Robusr/OnesArm/README.md

<p align="center">
  OnesArm v2 modular robotic arm on a 4040 aluminium platform
</p>

<h1 align="center">OnesArm</h1>

<p align="center">
  <strong>A modular serial robotic arm for multi-scenario tasks</strong>
  <br>
  v2 stepper/CAN platform, 24 joint layouts, and mortise-and-tenon interfaces
</p>

<p align="center">
  
  
  
  
  
  
</p>

<p align="center">
  <a href="./README.md">English</a> |
  <a href="./README.zh-CN.md">中文</a> |
  <a href="./README.fr.md">Français</a>
</p>

---

## About the project

**OnesArm** (Chinese project title: 珠联“臂”合) is a modular serial robotic arm. **v2 is the current platform.** It combines 42BYGH47 stepper motors with FLE-42-20 planetary reducers, STM32F103C8T6 CAN joint modules, an STM32F407ZGT6 bus controller, a 350 W supply and a 4040 aluminium platform. The links use 5 mm 5052 aluminium sheet and 50 × 46 mm carbon-fibre tubes, joined at standardised M5 nodes.

The arm is assembled from interchangeable joint, link and end-effector modules through **T/N mortise-and-tenon** interfaces. For the three-module configuration, the base-adjacent orientation is fixed and the other two modules choose one of two perpendicular channels, giving

**N₃ = 3! × 2² = 24**

joint layouts. The 24 assemblies are modelled in SolidWorks.

The earlier **v1 reference build**, with 15 kgf·cm PWM servos and a Raspberry Pi Pico W, is retained in the repository for comparison. The project was developed by 郭沫晗 (Guo Mohan) at Guyuan No. 1 Middle School, Ningxia. The report documents a first prize at the 38th National Youth Science and Technology Innovation Competition (2024).

> **Platform note.** v1 and v2 use separate electronics. Select the matching drive and board set before assembly.

## Key features

- **v2 stepper/CAN drive chain** — 42BYGH47 motors, FLE-42-20 1:20 reducers, magnetic encoder closed-loop control and STM32F103C8T6 CAN joint modules.
- **v2 aluminium/carbon structure** — 5 mm 5052 links, 50 × 46 mm carbon tubes, M5 nodes, a 4040 platform and a 350 W supply, with SolidWorks, STEP and STL sources included.
- **24 reconfigurable layouts** — three interchangeable modules, two perpendicular channels, and a fixed base-adjacent orientation.
- **T/N mortise-and-tenon interface** — a T node on top and an N node below, clamped by an M5 screw, inspired by dovetail and half-lap timber joints.
- **v1 reference build** — 15 kgf·cm PWM servos, Raspberry Pi Pico W, five module boards and a 16P gold-finger interconnect.
- **Multi-scenario end effectors** — parallel gripper, HC-SR04 ultrasonic probe, MQ gas sensor and pen module share the same interface.

## System architecture

### v2 current platform

<p align="center">
  OnesArm v2 system architecture
  <br>
  <em><strong>System architecture.</strong> End effector, link module, joint module and 4040 platform, with the CAN bus and 350 W supply.</em>
</p>

| Subsystem | v2 implementation |
|---|---|
| Controller | STM32F407ZGT6 CAN bus controller; STM32F103C8T6 CAN module in each joint |
| Drive | 42BYGH47 stepper + FLE-42-20 planetary reducer, 1:20; magnetic encoder closed-loop |
| Bus and power | CAN via TJA1050; 350 W DC supply; XT60 input; LM2596-5.0 logic rail |
| Structure | 5 mm 5052 aluminium sheet + 50 × 46 mm carbon tubes; M5 nodes; 4040 aluminium platform |
| End effectors | Parallel gripper, HC-SR04 ultrasonic probe, MQ gas sensor, pen module |

<p align="center">
  v2 X-X long link render
  v2 X-Y long link render
  <br>
  <em><strong>Figure 1 — v2 long links.</strong> X-X and X-Y links in 5 mm 5052 aluminium with 50 × 46 mm carbon tubes and M5 connection nodes.</em>
</p>

<p align="center">
  v2 stepper and reducer module
  v2 arm on a 4040 platform
  <br>
  <em><strong>Figure 2 — v2 drive module and platform.</strong> 42BYGH47 stepper, FLE-42-20 reducer, CAN board and the 4040 aluminium working platform.</em>
</p>

### v1 reference build

| Subsystem | v1 implementation |
|---|---|
| Controller | Raspberry Pi Pico W, RP2040, Wi-Fi |
| Drive | 15 kgf·cm PWM digital servo |
| Bus | 16P 2.54 mm gold-finger interconnect |
| Boards | Base, Joint A, Joint B, Holder/Sensor, Expand Controller |
| Supply | 5–9 V servo rail; 5 V logic |

<p align="center">
  v1 reference build render
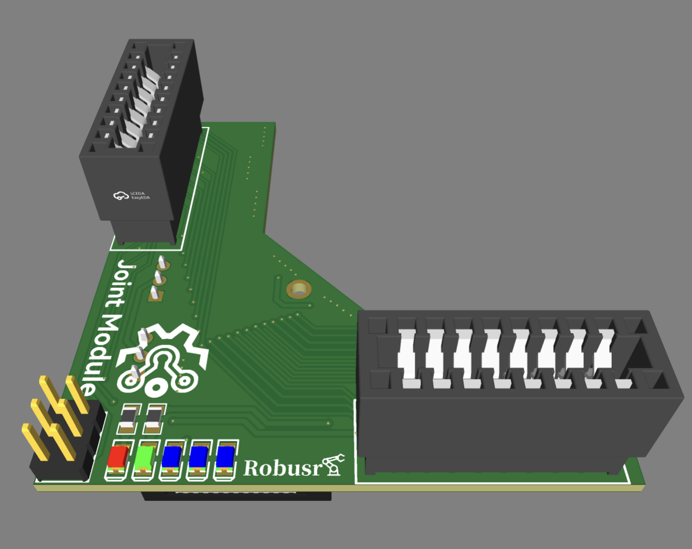
[picture p1: media/photos/reference/key_figures/fig2-19_pcb_joint_module.png]
v1 joint module PCB
  
  <br>
  <em><strong>Figure 3 — v1 reference build.</strong> Servo-driven arm render and the Joint Module PCB with PWM outputs, status LEDs and a servo signal selector.</em>
</p>

## Theory and design

### Modular combinations

The modular interface is a **connecting face – connecting channel – connecting face** (FCF) chain. An X-X or X-Y long link has 6 faces × 4 channels, a short link has 4 × 4, and a joint has 2 × 4. The per-module connection counts are:

- Base: 3 methods.
- X-X / X-Y long link: 2 × 3 × 3 = 18 methods.
- Short link: 2 × 2 × 3 = 12 methods.
- Joint: Pro side 4 × 1 × 1 = 4, Con side 1 × 4 × 1 = 4, total 8 per joint module.
- General end link: 2 × 2 or 2 × 3 methods.

For <i>F</i> joint modules, <i>N</i><sub>LL</sub> long links and <i>N</i><sub>LS</sub> short links, the FCF connection-method total is:

$$\displaystyle N_{com} = \sum_{i=0}^{N_{LL}} \sum_{j=0}^{N_{LS}} 8^{F} \cdot 18^{N_{LL}} \cdot 12^{N_{LS}}$$

The three-module assembly fixes the base-adjacent orientation and gives the remaining two modules two perpendicular channels each:

$$N_3 = 3! \cdot 2^{3-1} = 24$$

The 24 combinations are modelled as SolidWorks assemblies.

<p align="center">
  Connecting face - connecting channel - connecting face
  Concatenated modular chain
  <br>
  <em><strong>Figure 4 — FCF abstraction.</strong> Every connection is a face, a channel and another face. Long links have six faces, short links four, and joints two.</em>
</p>

### Kinematics and workspace

The analysed configuration is **AyCxBy-D**, a 4-DOF chain. Report Table 3-20 gives:

| i | dᵢ (mm) | aᵢ (mm) | αᵢ | Report range |
|---:|---:|---:|---:|---|
| 1 | 95 | 0 | 90° | 0° |
| 2 | 0 | 113.5 | 90° | 0–180° |
| 3 | 21.34 | 88.5 | 90° | 0–180° |
| 4 | 0 | 152 | 0° | 0–180° |

The standard DH transform is:

$$T_i^{i-1} = \begin{bmatrix}
c\theta_i & -s\theta_i c\alpha_i & s\theta_i s\alpha_i & a_i c\theta_i \\
s\theta_i & c\theta_i c\alpha_i & -c\theta_i s\alpha_i & a_i s\theta_i \\
0 & s\alpha_i & c\alpha_i & d_i \\
0 & 0 & 0 & 1
\end{bmatrix}, \qquad T_4^0 = T_1^0 T_2^1 T_3^2 T_4^3$$

The workspace is the set of tool positions over the joint ranges:

$$\mathcal{W} = \{\, \mathbf{p}(q) \mid q_i \in [q_{i,\min}, q_{i,\max}] \,\}, \qquad \mathbf{p}(q) = [T_4^0(q)]_{1:3,4}$$

The link-length sum is 113.5 + 88.5 + 152 = 354 mm. With the model offsets, the sampled workspace reaches about 450 mm.

<p align="center">
  Workspace comparison for four assembly layouts
  <br>
  <em><strong>Figure 5 — Workspace comparison.</strong> Four of the 24 layouts: AyCxBy-D, AyCyBx-D, AyCxBx-D and AyCyBy-D. Simulation samples from the kinematic model.</em>
</p>

### v2 finite element analysis

The v2 XY long link is evaluated as a static assembly. The base connection is fixed and the service load is applied at the connection nodes. The model combines the 5 mm 5052 aluminium plates with the 50 × 46 mm carbon tube.

The finite element solution is:

$$K u = f$$

where K is the stiffness matrix, u the nodal displacement vector and f the nodal load vector. The same load path can be checked with the cantilever relations:

$$M = FL, \qquad \sigma = \frac{Mc}{I}, \qquad \delta = \frac{FL^3}{3EI}$$

The v2 study reports a displacement-magnitude (URES) contour with a maximum of:

$$u_{\max} = 1.388 \times 10^{-2}\ \text{mm}$$

<p align="center">
  v2 XY long link static displacement contour
  <br>
  <em><strong>Figure 6 — v2 finite element analysis.</strong> Static displacement contour of the XY long link. The base is fixed and the connection nodes carry the service load; the URES legend is in millimetres.</em>
</p>

### Assembly selection

The v2 board uses the absolute joint-velocity integral as the assembly-selection index:

$$E_{Sum} = \sum_{i=1}^{F} \lvert \int_0^t \dot{\theta}_i(\tau)\,d\tau \rvert$$

The selection compares E_Sum with the workspace envelope. The workflow is:

<p align="center">
  Assembly selection workflow
  <br>
  <em><strong>Figure 7 — v2 assembly-selection workflow.</strong> The effort index and the workspace pre-processing path.</em>
</p>

### v1 reference static analysis

The v1 static study uses 9400A photopolymer resin and a 10 N load on each joint top face. The joint housings and the full assembly are evaluated in SolidWorks Simulation.

<p align="center">
  Finite element mesh of the joint housing
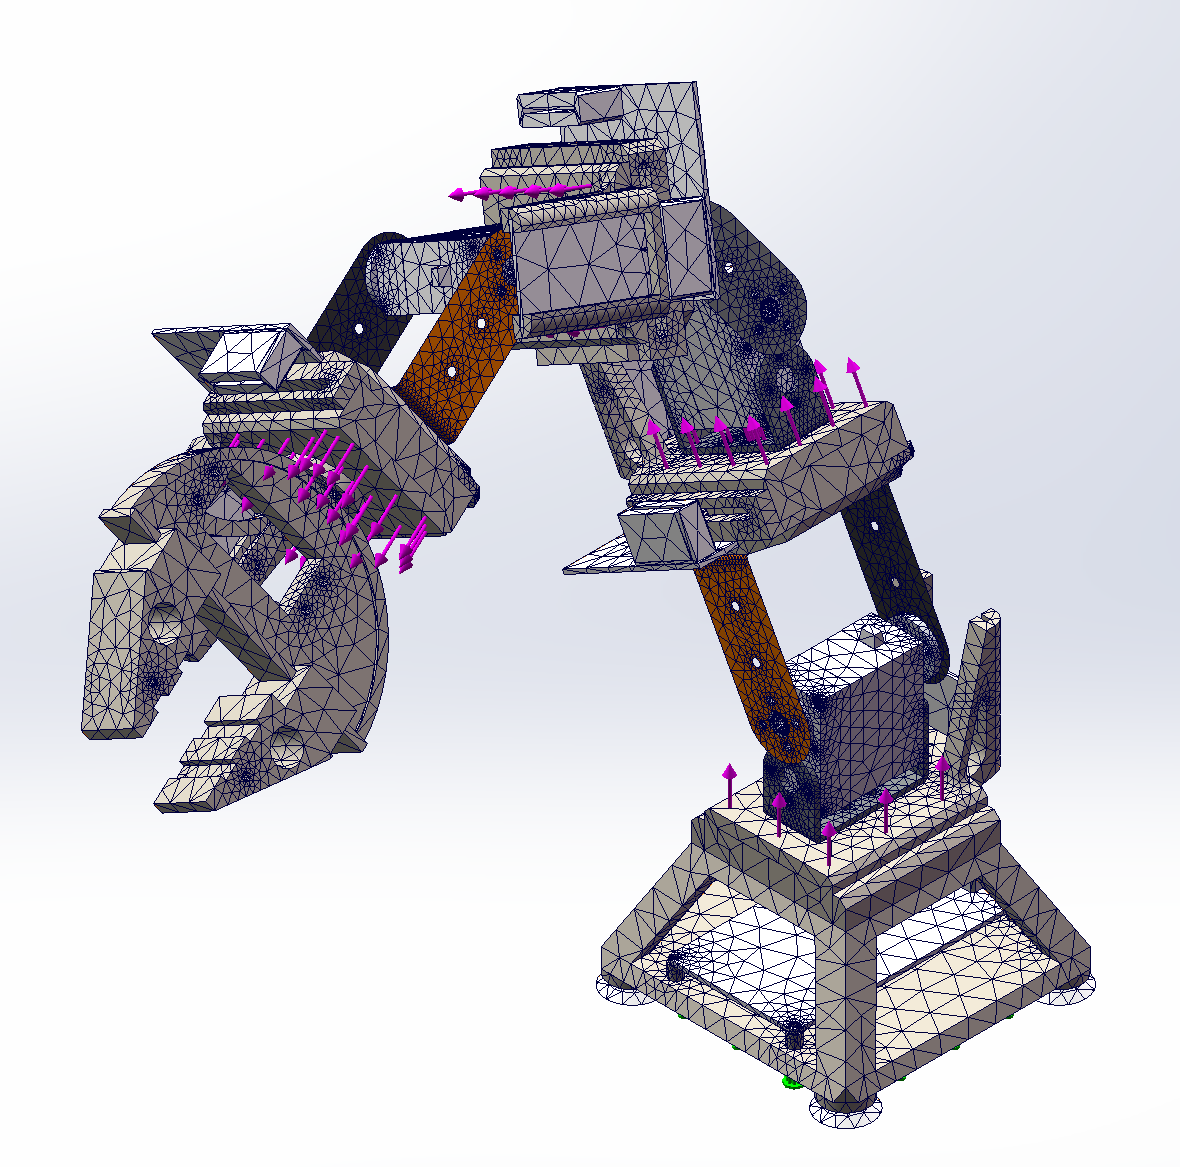
[picture p2: media/photos/reference/key_figures/fig3-5_fea_stress.png]
Static stress result for the joint housing
  
  <br>
  <em><strong>Figure 8 — v1 reference static analysis.</strong> Mesh and stress result for the joint housing under the 10 N load case.</em>
</p>

## Repository structure

```text
OnesArm/
├── BOM/                    summary + manufacturing checklists
├── electronics/            Gerber, BOM and silkscreen outputs
├── mechanical/
│   ├── source/             SolidWorks parts and assemblies
│   ├── output/             STEP, STL and fabrication exports
│   └── analysis/fea/       exported FEA images
├── firmware/               STM32CubeIDE projects + MicroPython libraries
├── software/               MATLAB kinematics scripts
├── docs/
│   ├── en/ zh-CN/ fr/      long-form documentation
│   ├── report/             2025 report and defence deck
│   ├── archive/            2024 report and research log
│   └── references/         citations and provenance
├── media/
│   ├── photos/project/     v2 renders, v1 build photos, PCB and test views
│   ├── photos/reference/   report figures and key figures
│   ├── gifs/               reference-build demonstrations
│   ├── videos/             original MP4 files
│   └── source/             editable poster files
├── data/                   data and log directory
├── scripts/verify_theory/  pure-Python kinematics and dimensional checks
├── README.md README.zh-CN.md README.fr.md
├── MIGRATION_NOTES.md CHANGELOG.md CONTRIBUTING.md
├── LICENSE.md LICENSE-docs.md
├── .gitignore .gitattributes
└── .github/
```

## Bill of materials

A summary is in [`BOM/onesarm_bom.md`](BOM/onesarm_bom.md); the machine-readable version is [`BOM/onesarm_bom.csv`](BOM/onesarm_bom.csv). Original checklists are under [`BOM/manufacturing/`](BOM/manufacturing/).

### v2 current platform

| Group | v2 items | Quantity |
|---|---|---|
| Long links | X-X and X-Y, 5 mm 5052 aluminium + carbon tube | 4 + 4 |
| Short links | 5 mm 5052 aluminium | 4 |
| Joints | 45° × 1, 90° × 2 | 3 |
| Drive | 42BYGH47 + FLE-42-20, 1:20 | 3 sets |
| Control | STM32F103C8T6 CAN modules + STM32F407ZGT6 controller | 1 set |
| Power | 350 W DC supply, XT60 | 1 |
| Platform | 4040 aluminium profile, three test plates | 1 |
| End effectors | Gripper, ultrasonic, gas sensor, pen | 4 modules |

### v1 reference build

| Group | v1 items | Quantity |
|---|---|---|
| Drive | 15 kgf·cm PWM servo | 3 |
| Controller | Raspberry Pi Pico W | 1 |
| Module boards | Base, Joint A/B, Holder/Sensor, Expand Controller | 5 |
| Interconnect | 16P 2.54 mm gold-finger | As required |
| Printed joints | 9400A resin joint housings | 3 + 3 |

## Getting started

### v2 build

1. **Fabricate the structure.** Use the STEP/STL files in `mechanical/output/`; cut and bend the 5 mm 5052 links, bond the 50 × 46 mm carbon tubes, and print the 9400A joint housings.
2. **Fabricate the electronics.** Order the Gerber archives in `electronics/output/gerber/controller_monitor/` and populate the BOM from `electronics/output/bom/controller_monitor/`.
3. **Assemble the platform.** Build the 4040 frame, fit the 350 W supply, and mount the Controller and Monitor boards.
4. **Configure the control.** Open the STM32CubeIDE projects in `firmware/stm32/` and configure the CAN bus and joint modules for the selected layout.
5. **Run the analysis.** Use the MATLAB scripts in `software/matlab/kinematics/` and the independent Python checks in `scripts/verify_theory/`.

```bash
python scripts/verify_theory/report_checks.py
python -m unittest discover -s scripts/verify_theory -v
```

### v1 reference build

1. Print the v1 joint housings and assemble the five v1 module boards.
2. Order the v1 Gerber archives in `electronics/output/gerber/v1_module_boards/` and build the 16P gold-finger harness.
3. Flash the Pico W with the MicroPython libraries in `firmware/micropython/` and connect the servo rail.

## Demo and testing

The v2 CAD and platform views show the current structure and drive package.

<p align="center">
  v2 arm on the 4040 working platform
  <br>
  <em><strong>Figure 9 — v2 working platform.</strong> Stepper-driven arm, aluminium/carbon links and the 4040 frame.</em>
</p>

The v1 reference build demonstrations show the servo/Pico reference build in motion, the expand-controller OLED/GNSS display, the gripper/pen module and the simulation view.

<p align="center">
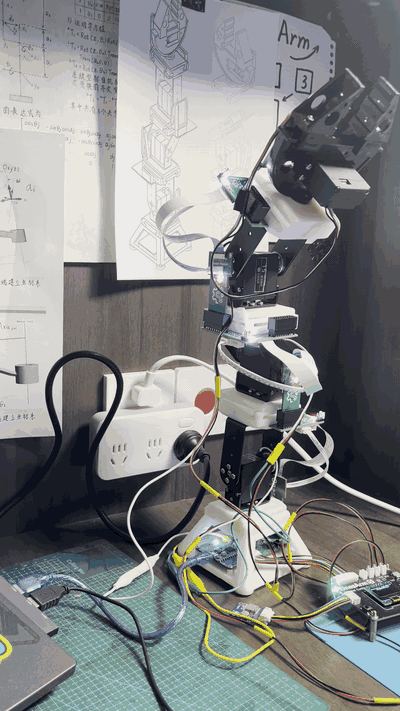
[picture p3: media/gifs/onesarm_motion.gif]
v1 reference build arm motion
  
  v1 reference build gripper demo
</p>

<p align="center">
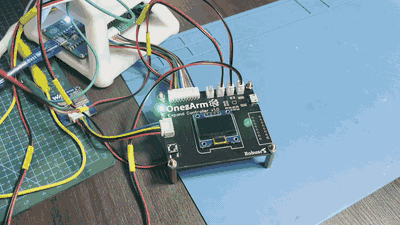
[picture p4: media/gifs/onesarm_electronics.gif]
v1 reference build OLED and GNSS demo
  
  Kinematic simulation view
</p>

<p align="center">
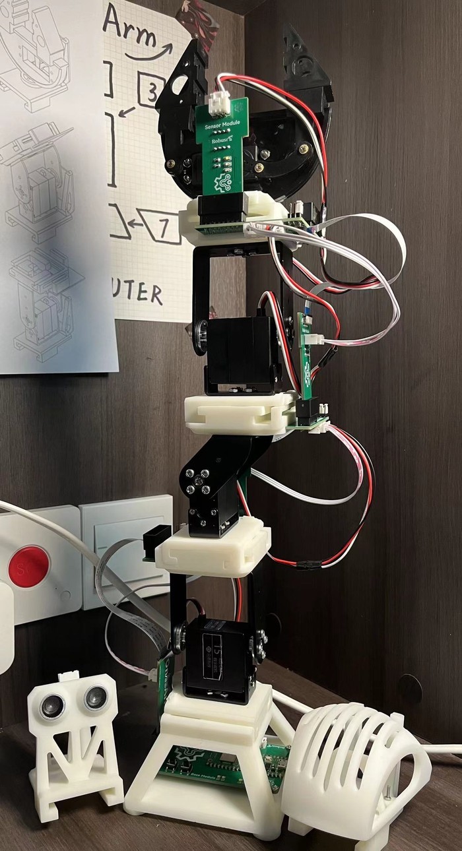
[picture p5: media/photos/project/onesarm_v1_build.jpg]
v1 reference build
  
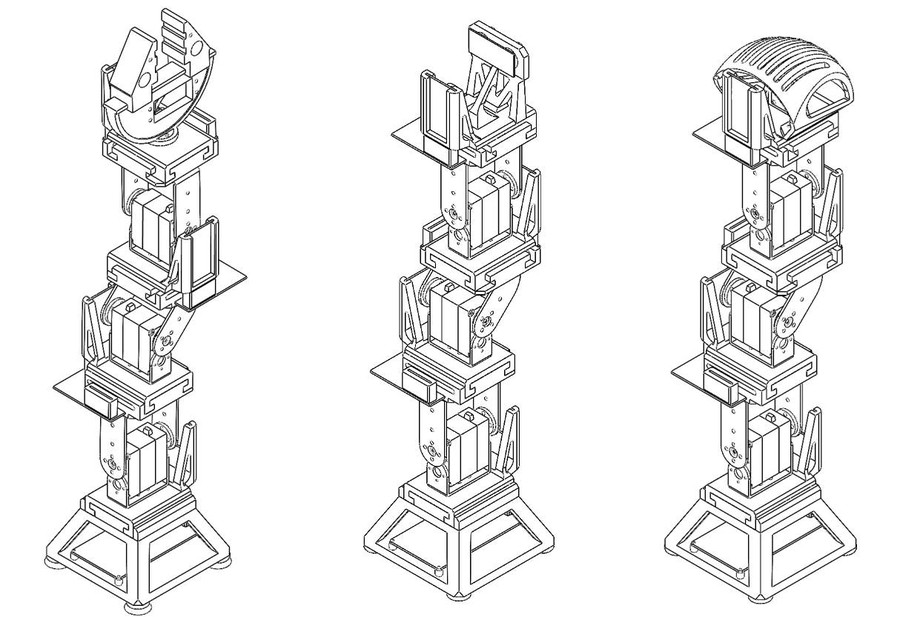
[picture p6: media/photos/project/scene_module_assembly_small.jpg]
Module assembly view
  
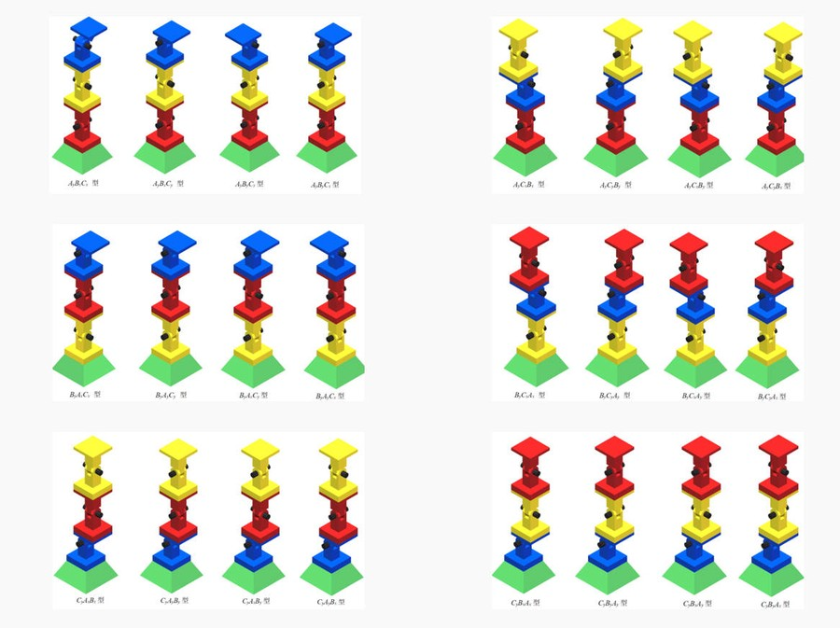
[picture p7: media/photos/project/modular_assembly_diagram_small.jpg]
24 assembly combinations
  
  <br>
  <em><strong>Figure 10 — v1 reference build and assembly views.</strong> The servo/Pico build, a module stack and the 24 permutation/orientation combinations.</em>
</p>

## Design specifications

### v2 current platform

| Parameter | Value | Source |
|---|---|---|
| Analysed configuration | AyCxBy-D, 4 DOF | Report §3.3 |
| Link parameters d₁, a₂, d₃, a₃, a₄ | 95, 113.5, 21.34, 88.5, 152 mm | Report Table 3-20 |
| Link-length sum | 354 mm | Computed |
| Maximum model reach | about 450 mm | Computed, 10,000 samples |
| Assemblies | 24 combinations | 3! × 2²; 24 CAD files |
| Drive | 42BYGH47 + FLE-42-20, 1:20 | Report §5.2.2 |
| Controller | STM32F103C8T6 CAN + STM32F407ZGT6 | Report §5.2.2 / §5.2.3 |
| Platform | 4040 aluminium profile, 350 W supply | Report §5.2.3 |
| Structure | 5 mm 5052 aluminium sheet + 50 × 46 mm carbon tube | Report §5.2.1 |
| FEA material | 9400A resin, E = 2.75 GPa, ν = 0.44, 1150 kg/m³ | Report Table 3-1 |
| FEA load | 10 N at each joint top face | Report §3.1.2 |

### v1 reference build

| Parameter | Value | Source |
|---|---|---|
| Drive | 15 kgf·cm PWM servo, 5–9 V, 180° | Report §2.3.1 |
| Controller | Raspberry Pi Pico W, RP2040 | Report §2.3.2 |
| Module boards | Base, Joint A/B, Holder/Sensor, Expand Controller | Report §2.3.2 |
| Interconnect | 16P 2.54 mm gold-finger | Report §2.3.2 |
| Logic supply | 5 V | Report §2.3.2 |

## Documentation

- [Theory of operation](docs/en/theory_of_operation.md)
- [Mechanical design](docs/en/mechanical_design.md)
- [Electronics and control](docs/en/electronics_and_control.md)
- [Assembly and replication](docs/en/assembly_and_replication.md)
- [Verification](docs/verification.md)
- [Glossary](docs/glossary.md)

Chinese and French versions are in [`docs/zh-CN/`](docs/zh-CN/) and [`docs/fr/`](docs/fr/).

## Contributing

See [`CONTRIBUTING.md`](CONTRIBUTING.md). Add sources and licence notes for third-party figures.

## License

- **Code, firmware and scripts:** [MIT](LICENSE.md).
- **Documentation, original CAD, photos and diagrams:** [CC BY 4.0](LICENSE-docs.md).
- **Third-party figures, papers, videos and trademarks:** excluded from both licences. See [`docs/references/README.md`](docs/references/README.md).

## Acknowledgments

- **Author:** 郭沫晗 (Guo Mohan), Guyuan No. 1 Middle School, Ningxia.
- **Teacher and mentors:** 马博伟 (school robotics studio), 杨旭 (University of Electronic Science and Technology of China), 邵金龙 (Ningxia University), as acknowledged in the report.
- **Competition:** 38th National Youth Science and Technology Innovation Competition (2024).
- **References:** the continuum-robot, modular-arm, mortise-and-tenon and snake-robot literature listed in [`docs/references/README.md`](docs/references/README.md).
- **Tools:** SolidWorks, MATLAB Robotics Toolbox, EasyEDA/LCEDA, STM32CubeIDE, MicroPython, ffmpeg and Pillow.
