Robusr/OnesArm/docs/README.md

# Documentation

## Languages

- [English](en/index.md)
- [中文](zh-CN/index.md)
- [Français](fr/index.md)

## Review documents

- [Errata and theory review](errata.md) — DH convention, Eq. (3.7), joint limits, combination count, “energy” proxy, load case, hardware revisions.
- [Verification](verification.md) — commands, test results, workspace envelope and actuator margin.
- [Glossary](glossary.md) — English / 中文 / Français terminology.
- [References](references/README.md) — report citations, third-party material and tool provenance.

## Source documents

- [Canonical 2025 report](report/README.md)
- [Archived 2024 material](archive/README.md)

The three README files at the repository root are the entry points. Long-form documents are duplicated in `en/`, `zh-CN/` and `fr/` with the same section structure, figures and numbers.
