Robusr/OnesArm/docs/report/README.md

# Reports

| File | Pages / type | Role |
|---|---|---|
| `onesarm_report_2025_zh.pdf` | 65 pages | Canonical Chinese report (2025-09). Includes Chapter 5, the v2 stepper/CAN update. |
| `onesarm_report_2025_zh.docx` | 65 pages | Editable Chinese source for the PDF. |
| `onesarm_report_2025_en.pdf` | 66 pages | English translation (2025-01). |
| `onesarm_defense_2024.pptx` | 51 slides | 2024 defence deck; describes the v1 servo/Pico prototype. |
| `novelty_search_report_2024.pdf` | 9 pages | Novelty search completed 2024-01-20; concludes that no identical report was found. |

## Which version to cite

Use the **2025 Chinese report** for the latest design. Its Chapter 5 supersedes the v1 hardware description in Chapters 1–4. The 2024 report and deck are retained under `../archive/` for traceability.

## Evidence status

The reports contain design descriptions, FEA screenshots, MATLAB plots and qualitative conclusions. They do **not** contain measured payload, repeatability, mass or power data. See `../errata.md` and `../../data/README.md`.

## Copyright

The reports are the author’s work. Third-party figures inside them are not covered by the repository licences; see `../references/README.md`.
