Robusr/OnesArm/docs/archive/README.md

# Archive

This folder keeps superseded material in its original form. It is **not** the current design.

| Path | Content |
|---|---|
| `report_2024/` | 2024 Chinese report (DOCX/PDF) and the 2024 poster PDF. Uses the v1 servo/Pico hardware. |
| `presentations/` | Midterm review deck (2024). |
| `research_log_2023_2024.docx` | Research log from 2023-10 to 2024. |
| `abstract_2024.docx`, `project_intro_2024.docx` | 2024 abstract and project introduction. |
| `xmind/` | Original XMind outlines (project plan and spatial structure). |
| `board_text_2024.md` | Markdown source of the 2024 poster board, including absolute image paths from the author’s machine. |
| `related_concepts/electromagnetic_continuum_arm/` | A separate early concept: an electromagnetically driven continuum arm. It is not part of OnesArm. |

The 2024 report and the 2025 report differ in hardware and wording. Do not mix their specifications. See `../errata.md` E-10.
