Robusr/OnesArm/docs/archive/abstract_2024.docx

# Design and analysis of multi-scenario modular tandem manipulator structure

## Abstract

With the continuous improvement of industrial automation and the demand in the field of medical rescue, the demand for high-precision, high-speed, and high-reliability robotic arm systems is increasing. The modular robotic arm is characterized by high flexibility, easy maintenance and strong scalability. Inspired by the continuous manipulator based on the continuous joint flexible structure, drawing on its advantages of large working space and high flexible adaptability, and avoiding the shortcomings of complex structure and not easy to maintain, aiming at the problems of large volume, single use scenario and poor passing ability of the traditional rigid tandem manipulator, a multi-scene modular tandem manipulator was designed, a three-dimensional solid model was established and 3D printed, and the modular structure design was completed according to the mortise and tenon joints. Static stress finite element analysis and preliminary function verification, based on the coordinate transformation method, the kinematic model of the manipulator was constructed, the forward and reverse kinematics was solved by MATLAB, the simulation analysis and modular combination analysis of the single and multi-joints of the manipulator were carried out, and the multi-scene switching and modular servo control system were built, which realized the purpose of high flexibility, versatility, easy maintenance and expansion, and space optimization of the multi-scene modular tandem manipulator.
