Robusr/OnesArm/docs/archive/project_intro_2024.docx

随着工业自动化程度和医疗救援领域需求的不断提高，对于高精度、高速度、高可靠性的机械臂需求日益增加。受启发于柔性结构的连续型机械臂，借鉴其具有较大工作空间和较高适应性的优点，并规避结构复杂和不易于维护的缺点，针对传统刚性串联机械臂体积大、使用场景单一和复杂狭窄环境通过能力差的问题，设计了多场景模块化串联机械臂。建立三维实体模型，依据榫卯节点连接方式完成模块化结构设计、静应力有限元分析和初步功能验证；基于坐标变换法构建了机械臂的运动学模型，使用MATLAB完成正逆运动学求解，对机械臂单关节、多关节运动进行仿真分析、模块化组合分析和冗余自由度优化，从系统能耗和工作空间两个方面对机械臂结构组装预处理，通过模块化重组的方式完成由“固定需求映射固定机构”到“不同需求映射不同机构”的实时优化；实现多场景模块化串联机械臂通用性高、易于维护和拓展、便于空间优化的目的，满足技术发展和不断变化的需求，达到了珠联“臂”合。
