Robusr/OnesArm/electronics/output/silkscreen/Holder Module.png

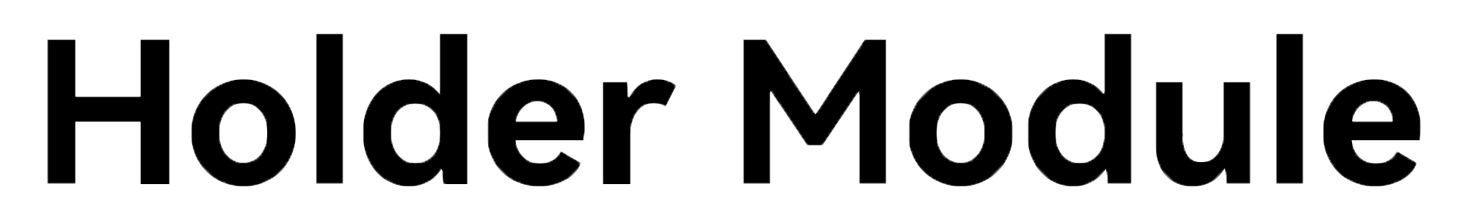
electronics/output/silkscreen/Holder Module.png
