Robusr/OnesArm/electronics/output/silkscreen/Joint Module.png

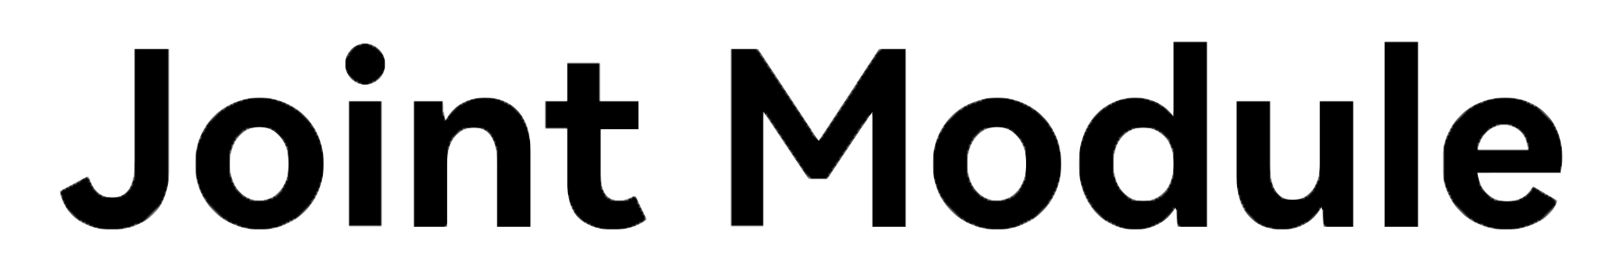
electronics/output/silkscreen/Joint Module.png
