Robusr/OnesArm/media/photos/project/design_views/夹具模块.jpg

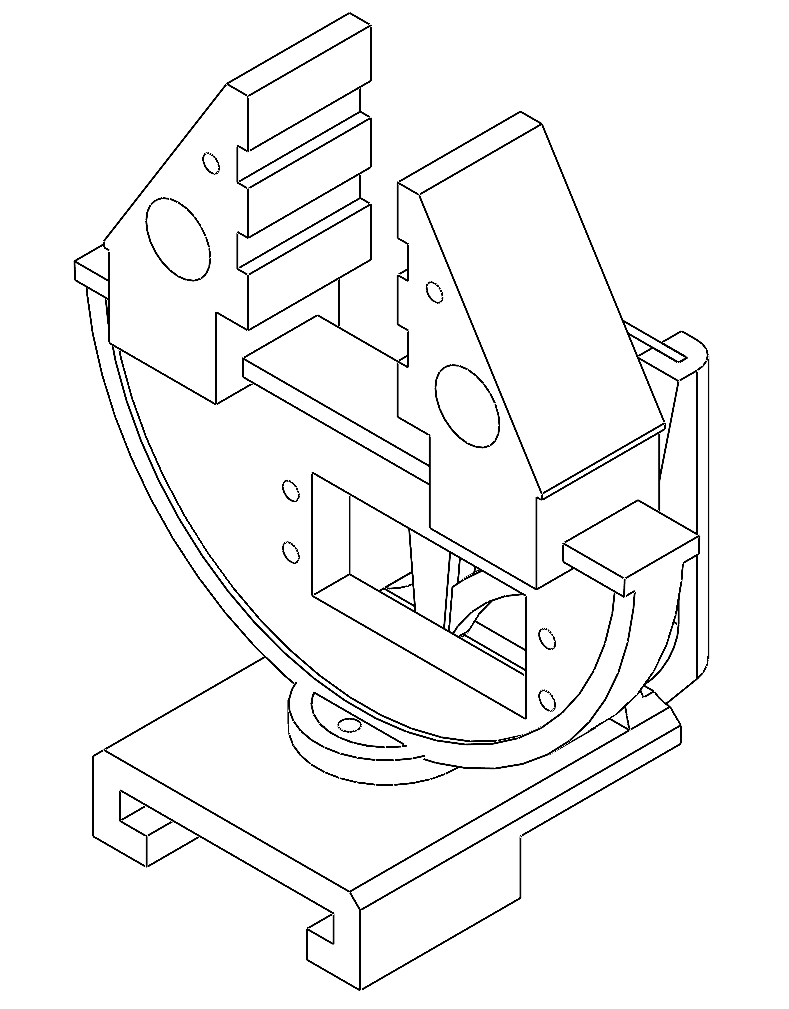
media/photos/project/design_views/夹具模块.jpg
