Robusr/OnesArm/media/photos/project/design_views/整体直.jpg

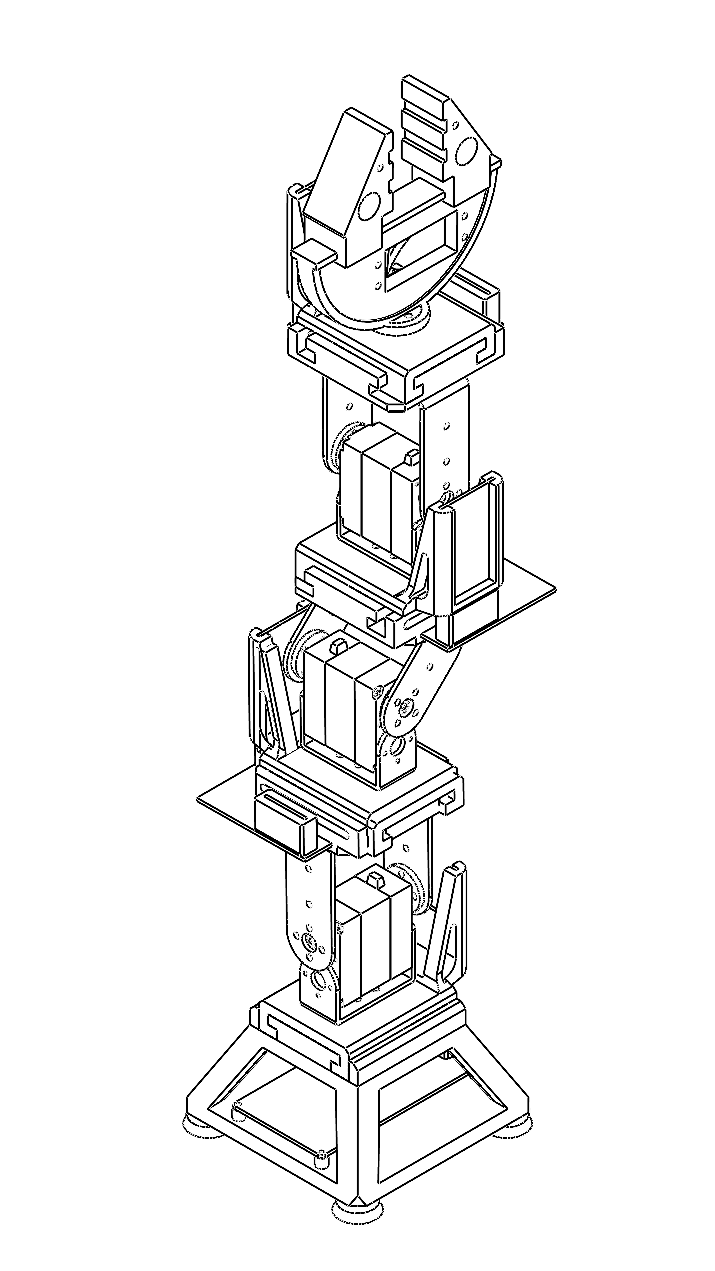
media/photos/project/design_views/整体直.jpg
