Robusr/OnesArm/media/photos/project/misc/微信图片_20240814153913.jpg

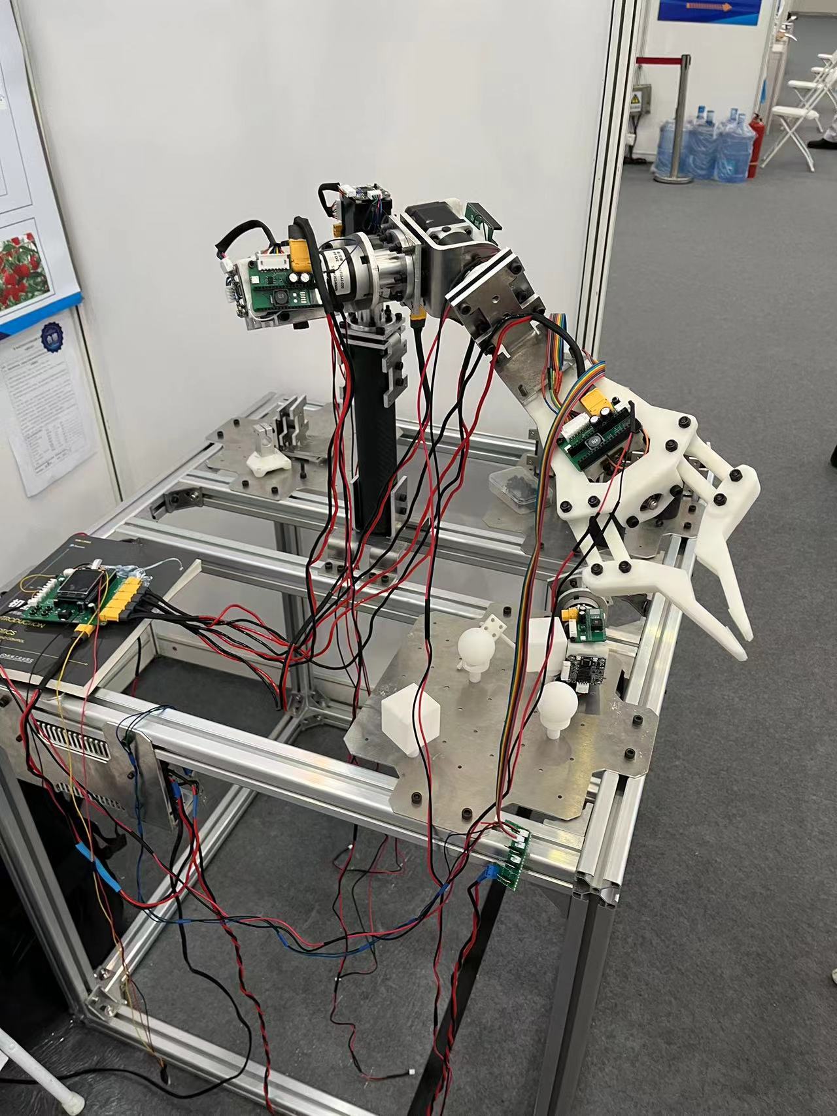
media/photos/project/misc/微信图片_20240814153913.jpg
