Robusr/OnesArm/media/photos/project/misc/微信图片_20240814153923.jpg

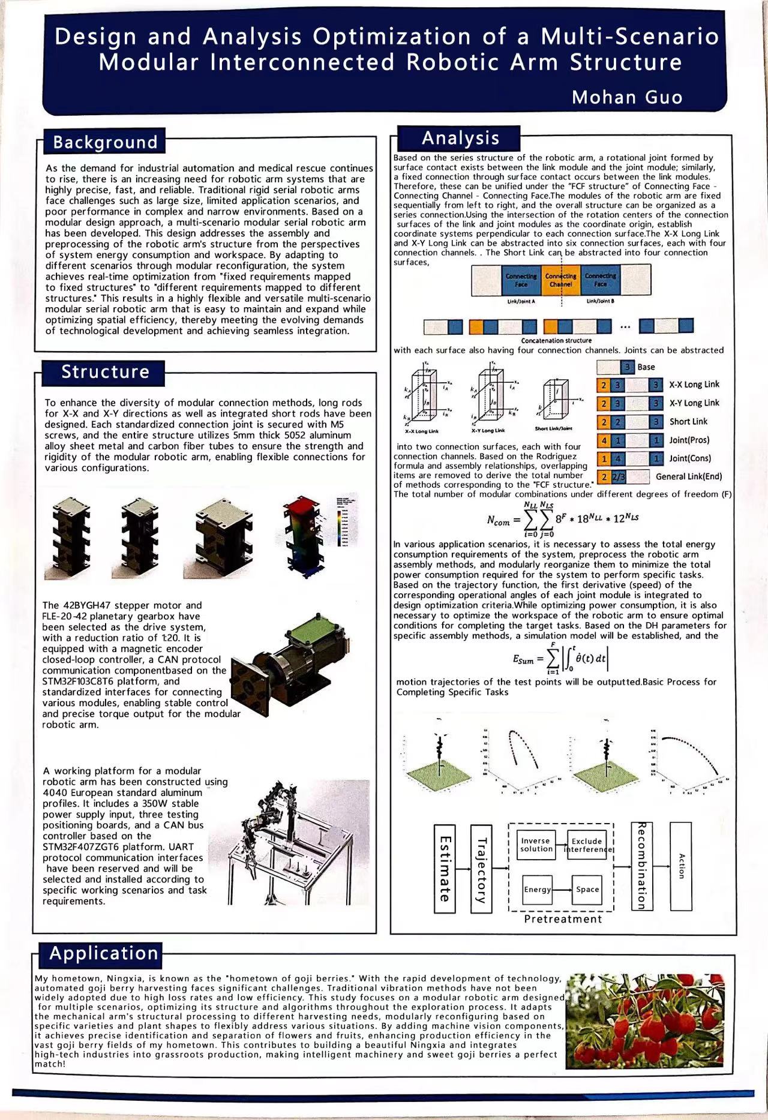
media/photos/project/misc/微信图片_20240814153923.jpg
