Robusr/OnesArm/media/photos/project/onesarm_electronics_poster.jpg

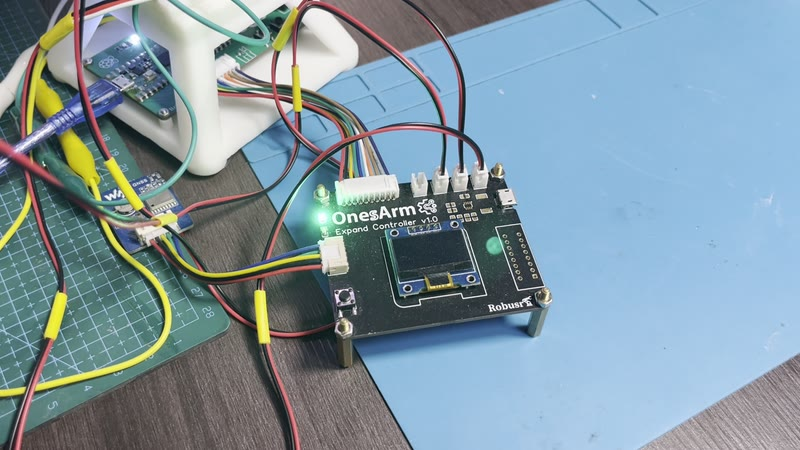
media/photos/project/onesarm_electronics_poster.jpg
