Robusr/OnesArm/media/photos/reference/board/功耗指标.png

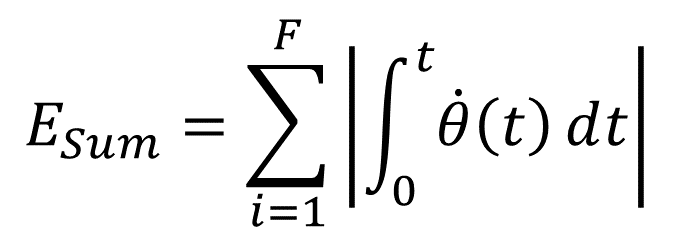
media/photos/reference/board/功耗指标.png
