Robusr/OnesArm/media/photos/reference/board/组合总数.png

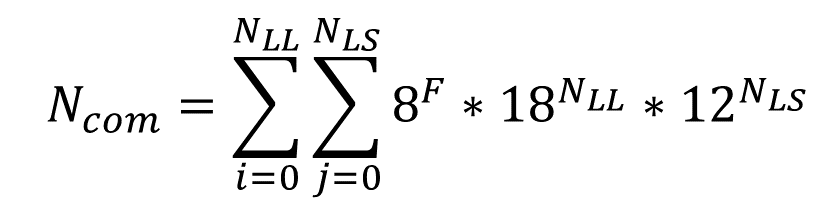
media/photos/reference/board/组合总数.png
