Robusr/OnesArm/media/photos/reference/defense_slides/1.jpg

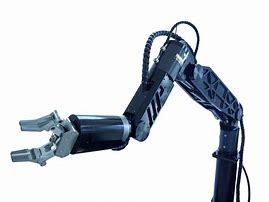
media/photos/reference/defense_slides/1.jpg
