Robusr/OnesArm/media/photos/reference/defense_slides/3.png

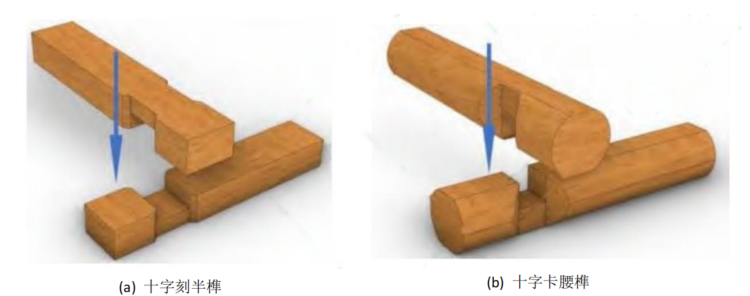
media/photos/reference/defense_slides/3.png
