Robusr/OnesArm/media/photos/reference/defense_slides/5.png

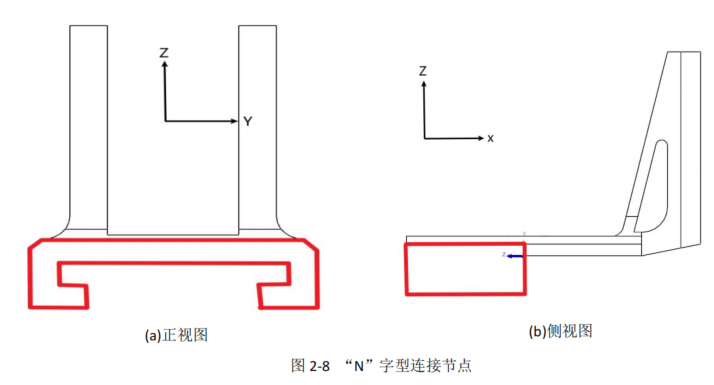
media/photos/reference/defense_slides/5.png
