Robusr/OnesArm/media/photos/reference/defense_slides/8.png

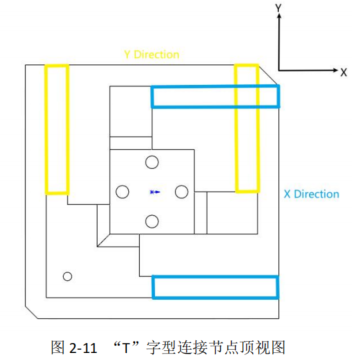
media/photos/reference/defense_slides/8.png
