Robusr/OnesArm/media/photos/reference/defense_slides/10.png

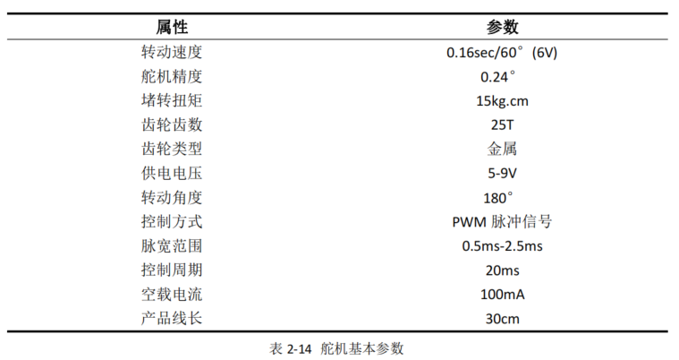
media/photos/reference/defense_slides/10.png
