Robusr/OnesArm/media/photos/reference/defense_slides/11.png

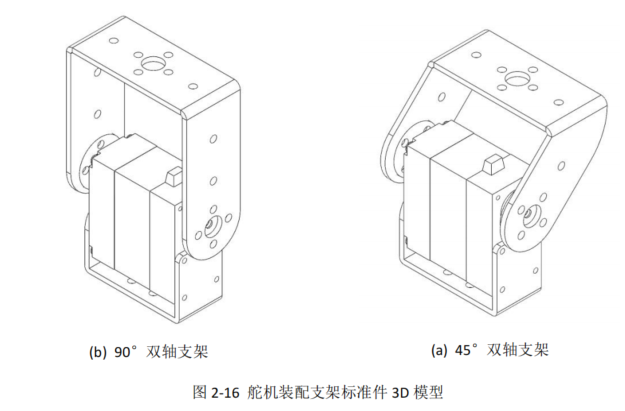
media/photos/reference/defense_slides/11.png
