Robusr/OnesArm/media/photos/reference/defense_slides/13.png

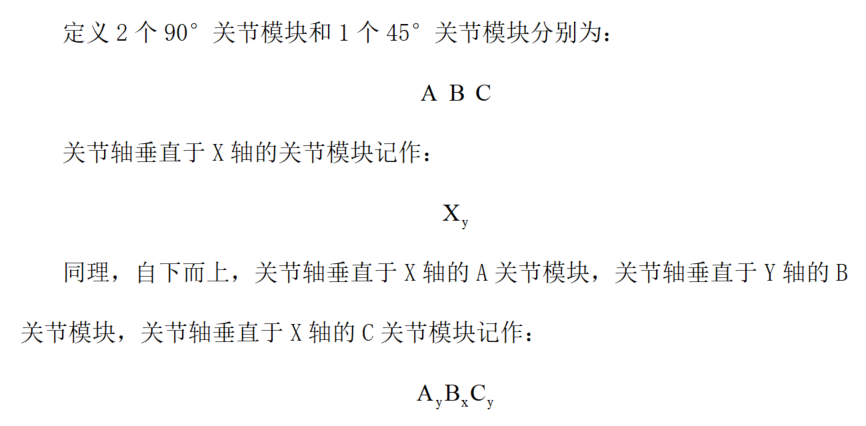
media/photos/reference/defense_slides/13.png
