Robusr/OnesArm/media/photos/reference/defense_slides/15.png

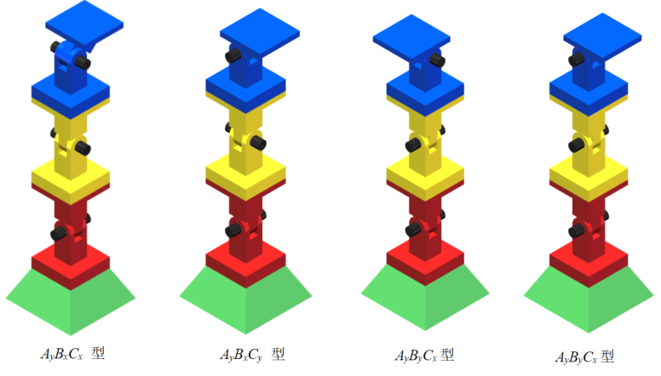
media/photos/reference/defense_slides/15.png
