Robusr/OnesArm/media/photos/reference/defense_slides/16.png

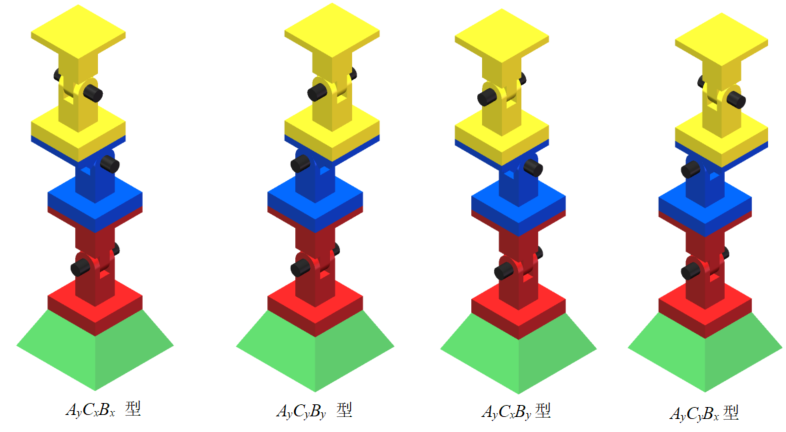
media/photos/reference/defense_slides/16.png
