Robusr/OnesArm/media/photos/reference/defense_slides/17.png

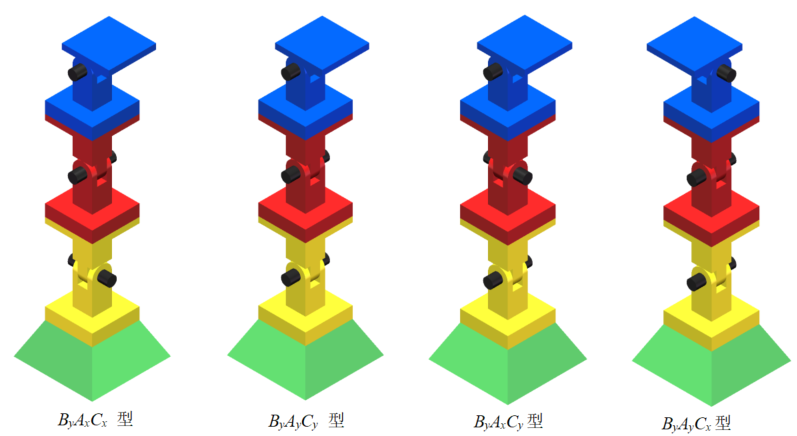
media/photos/reference/defense_slides/17.png
