Robusr/OnesArm/media/photos/reference/defense_slides/18.png

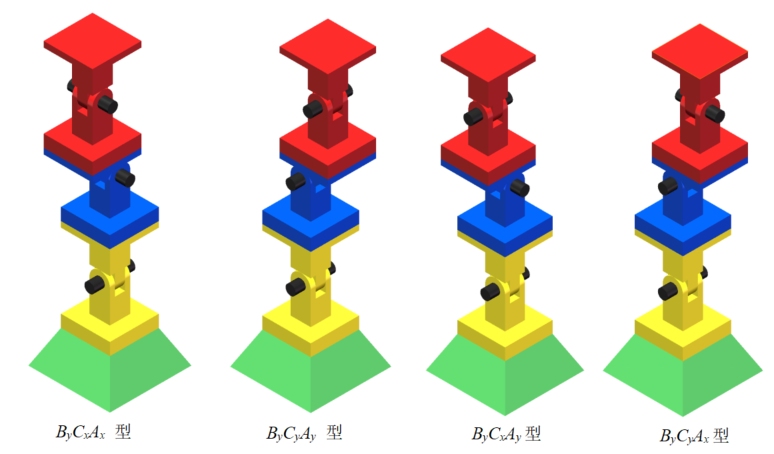
media/photos/reference/defense_slides/18.png
