Robusr/OnesArm/media/photos/reference/defense_slides/20.png

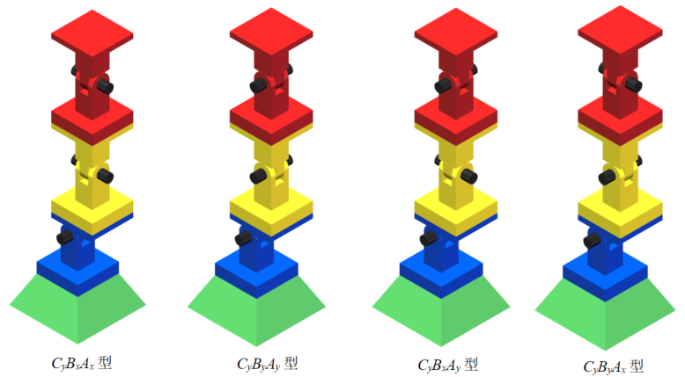
media/photos/reference/defense_slides/20.png
