Robusr/OnesArm/media/photos/reference/defense_slides/21.png

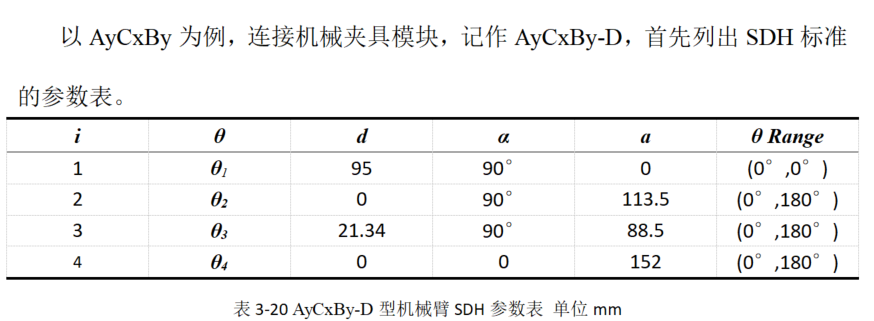
media/photos/reference/defense_slides/21.png
