Robusr/OnesArm/media/photos/reference/defense_slides/22.png

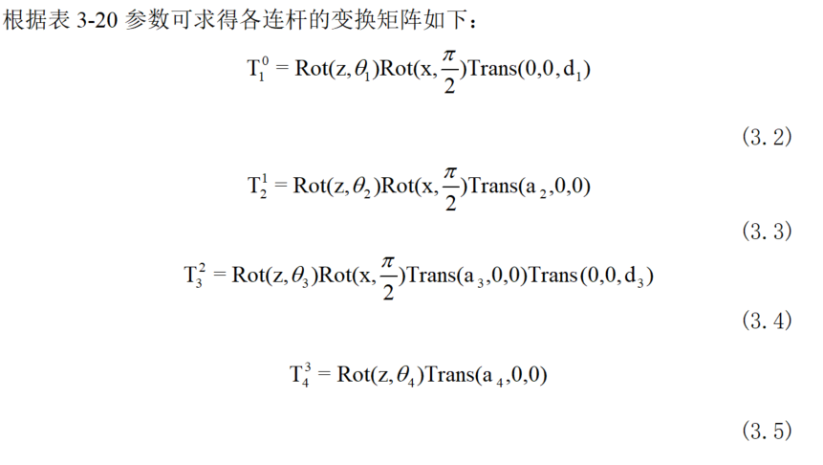
media/photos/reference/defense_slides/22.png
