Robusr/OnesArm/media/photos/reference/defense_slides/23.png

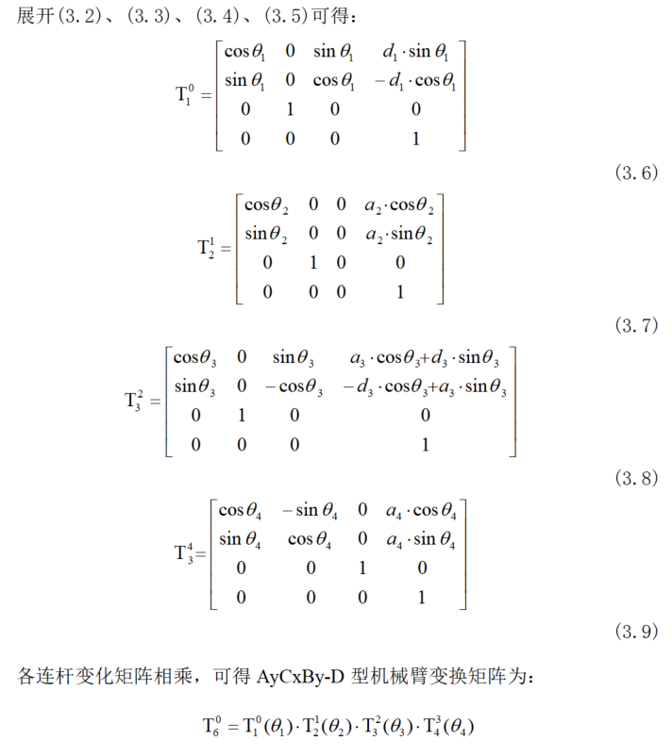
media/photos/reference/defense_slides/23.png
