Robusr/OnesArm/media/photos/reference/defense_slides/24.png

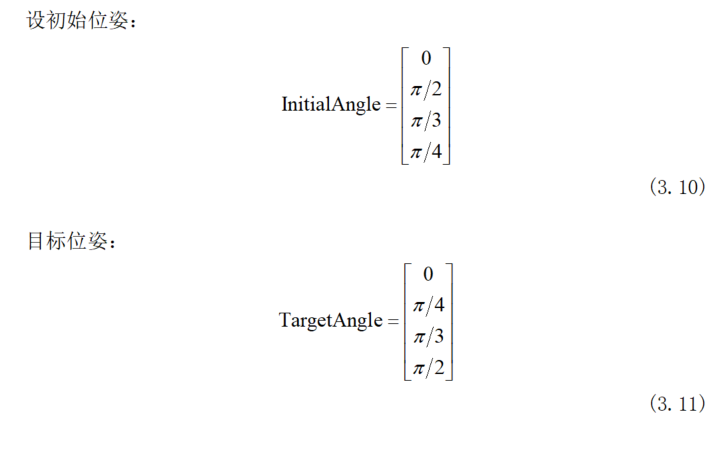
media/photos/reference/defense_slides/24.png
