Robusr/OnesArm/media/photos/reference/defense_slides/25.png

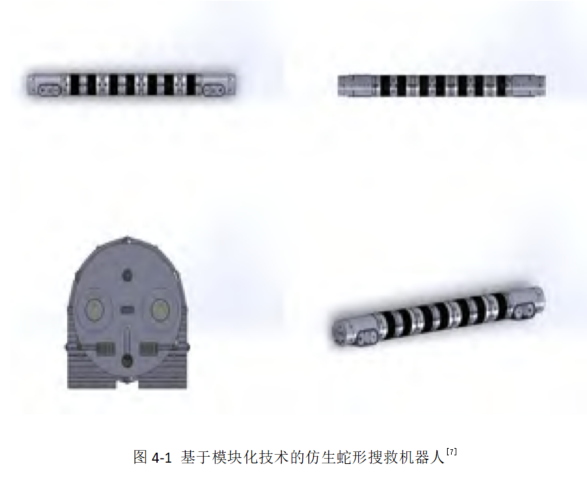
media/photos/reference/defense_slides/25.png
