Robusr/OnesArm/media/photos/reference/figures/2-12.png

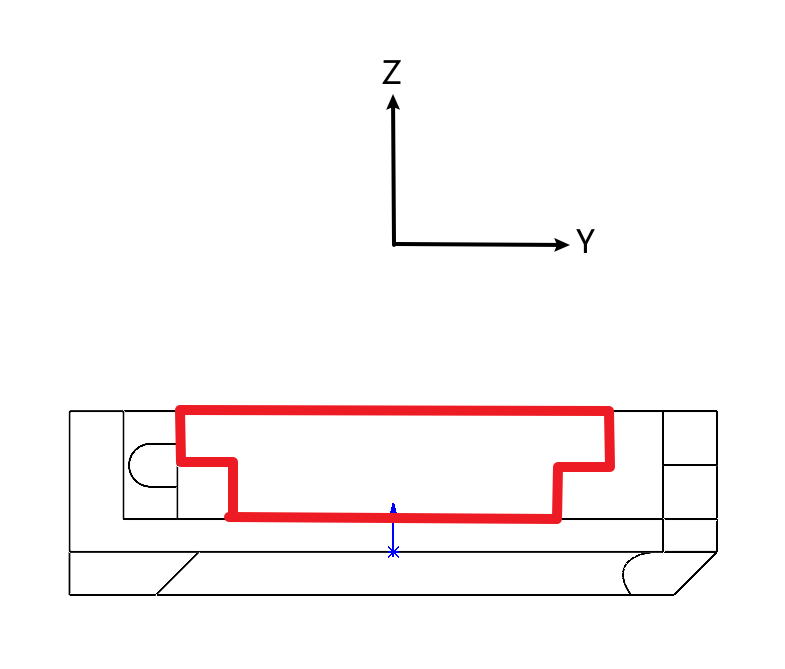
media/photos/reference/figures/2-12.png
