Robusr/OnesArm/media/photos/reference/figures/2-14.png

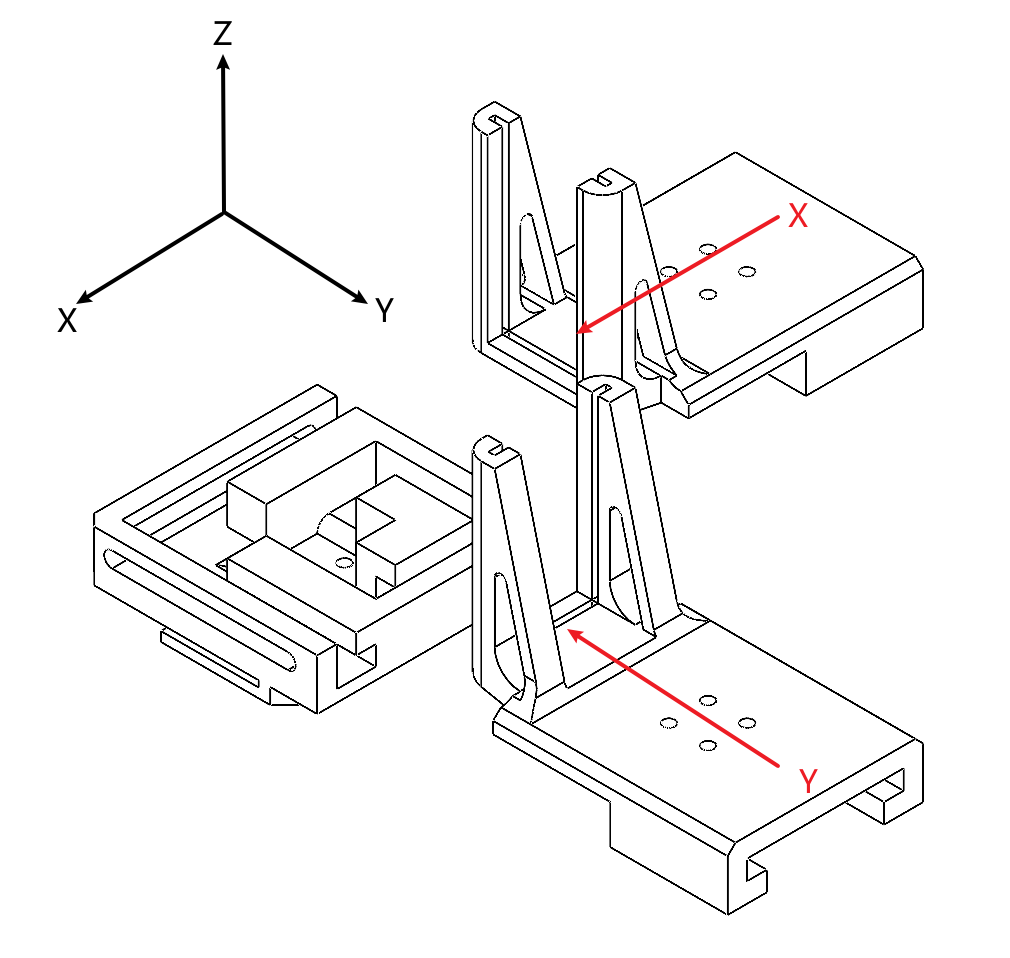
media/photos/reference/figures/2-14.png
