Robusr/OnesArm/media/photos/reference/figures/2.1.1.png

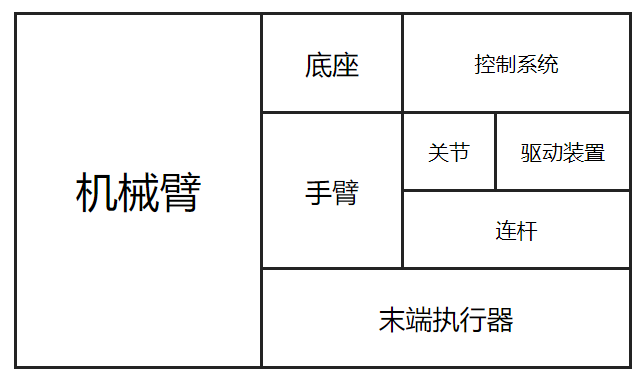
media/photos/reference/figures/2.1.1.png
