Robusr/OnesArm/media/photos/reference/figures/PCB2.png

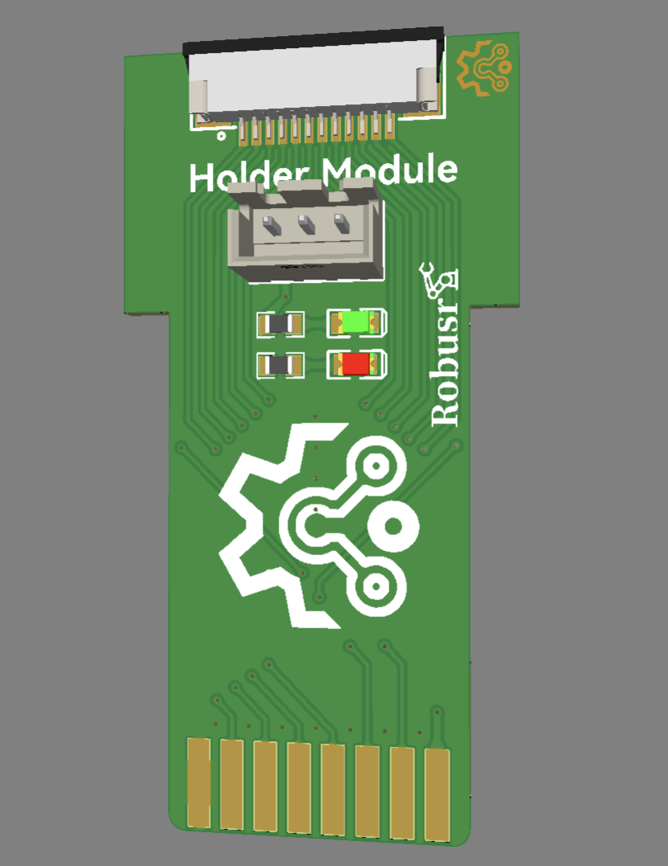
media/photos/reference/figures/PCB2.png
