Robusr/OnesArm/media/photos/reference/figures/PCB3.png

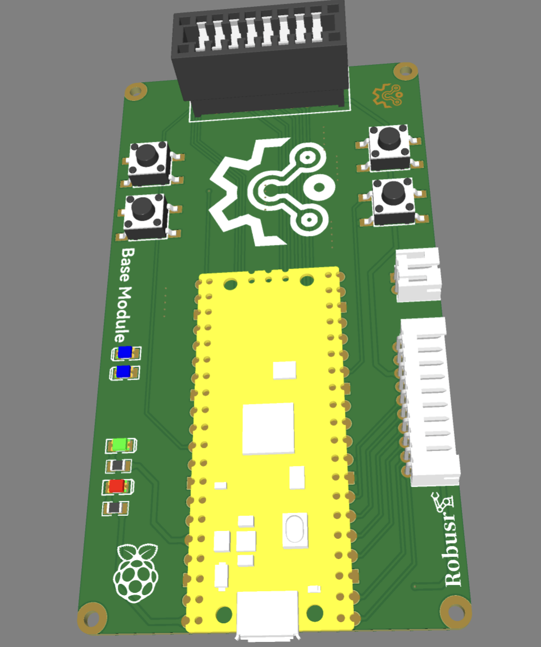
media/photos/reference/figures/PCB3.png
