Robusr/OnesArm/media/photos/reference/figures/Snipaste_2024-04-23_04-02-33.png

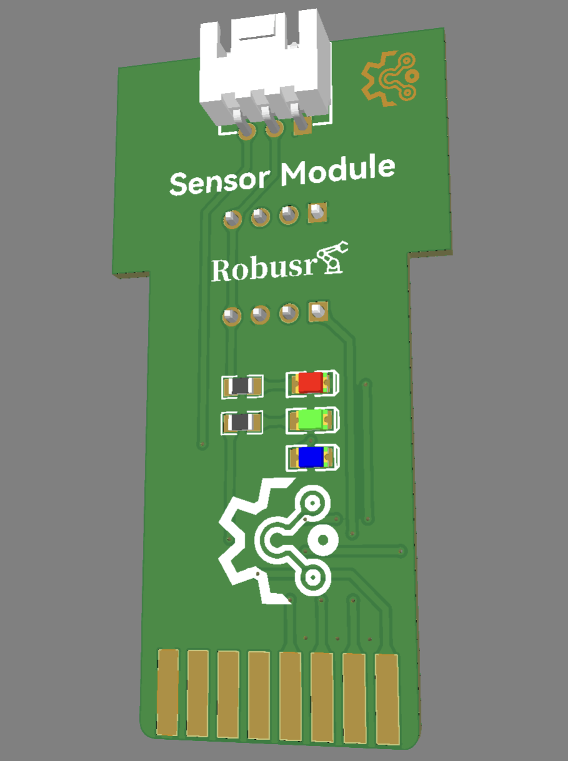
media/photos/reference/figures/Snipaste_2024-04-23_04-02-33.png
