Robusr/OnesArm/media/photos/reference/figures/Velocity.png

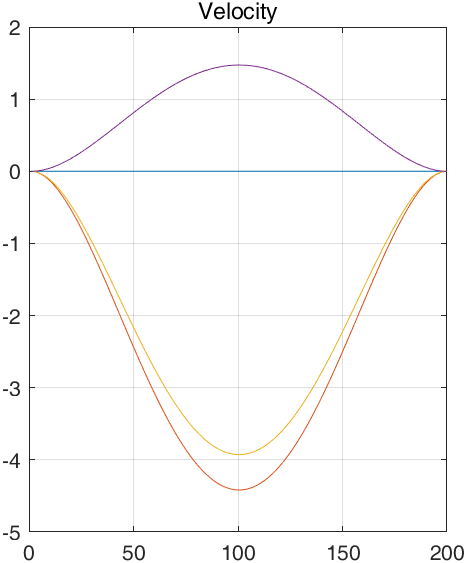
media/photos/reference/figures/Velocity.png
