Robusr/OnesArm/media/photos/reference/figures/轨迹.png

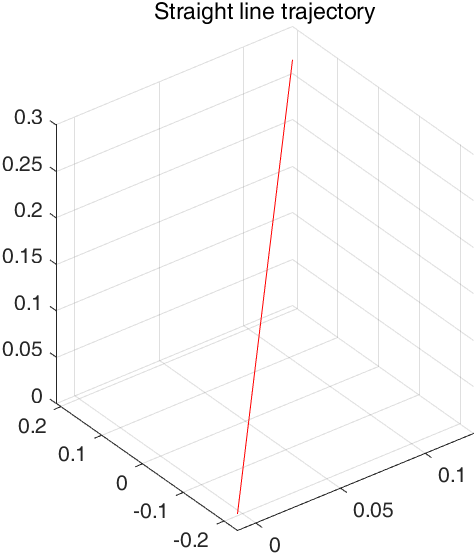
media/photos/reference/figures/轨迹.png
