Robusr/OnesArm/media/source/posters/图片/1.png

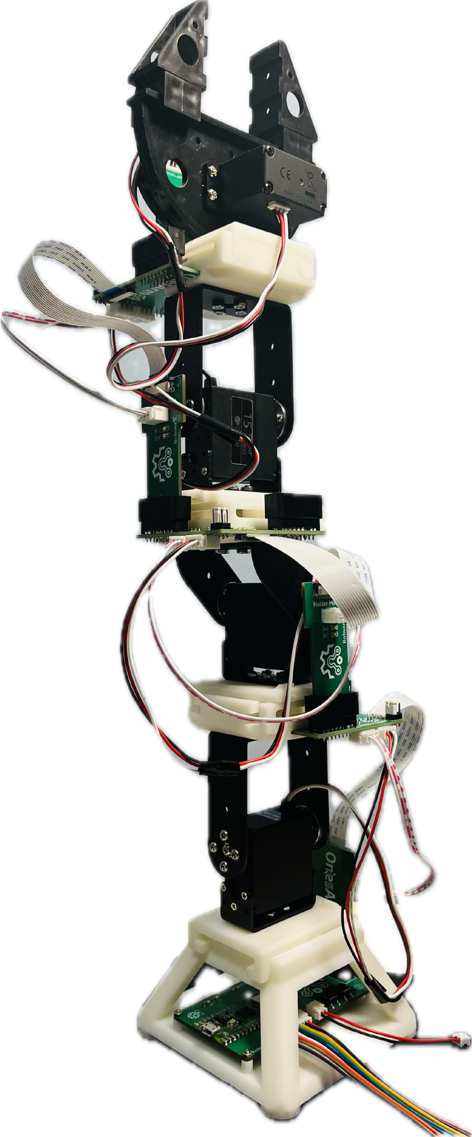
media/source/posters/图片/1.png
