Robusr/OnesArm/media/source/posters/图片/3.png

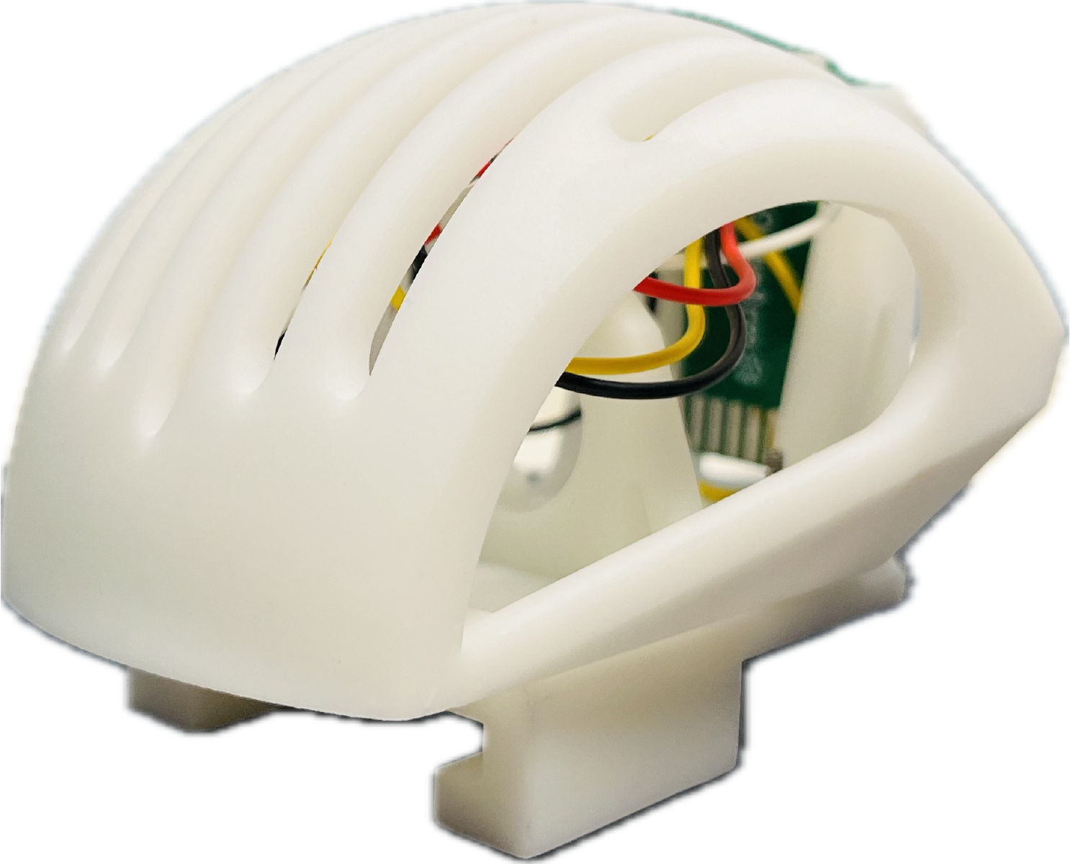
media/source/posters/图片/3.png
