Robusr/OnesArm/media/source/posters/排版.png

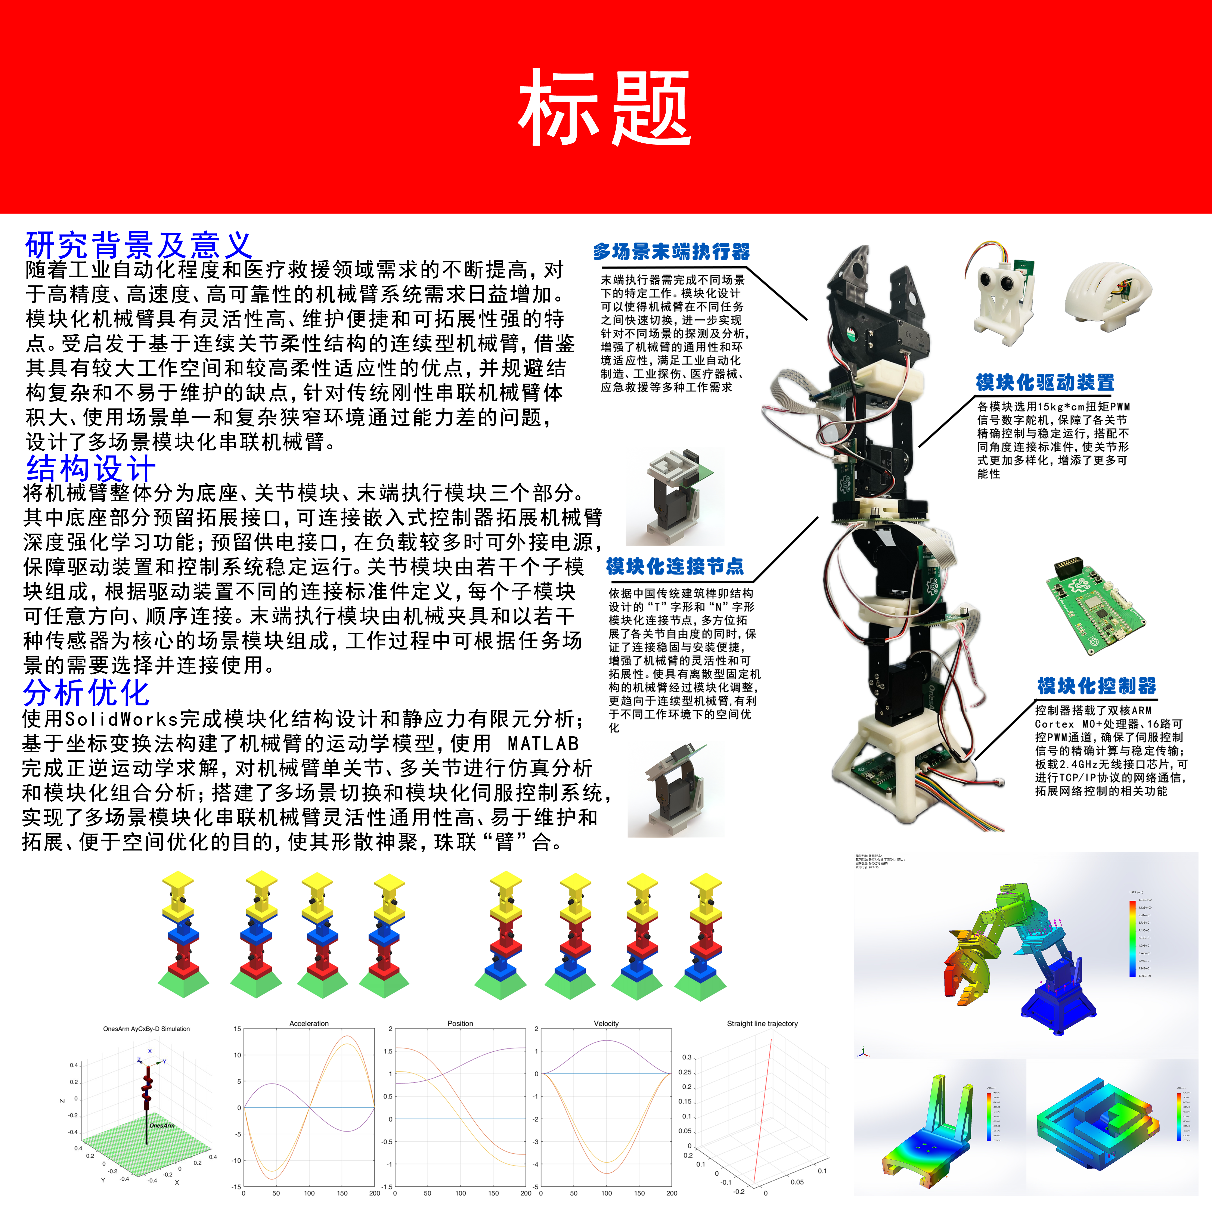
media/source/posters/排版.png
