Robusr/OnesArm/BOM/onesarm_bom.csv

subsystem | item | specification | qty | revision | source | notes
Structure | X-X long link | 5 mm 5052 aluminium sheet + 50 x 46 mm carbon tube | 4 | v1/v2 | Report 2.2 / 5.2.1; BOM/manufacturing/定做生产.md | Carbon tube quantity is 2
Structure | X-Y long link | 5 mm 5052 aluminium sheet + 50 x 46 mm carbon tube | 4 | v1/v2 | Report 2.2 / 5.2.1; BOM/manufacturing/定做生产.md | Carbon tube quantity is 2
Structure | Short link | 5 mm 5052 aluminium sheet | 4 | v1/v2 | BOM/manufacturing/定做生产.md
Structure | Base plate | 5 mm 5052 aluminium sheet | 2 | v1/v2 | BOM/manufacturing/定做生产.md
Structure | Motor support | Sheet metal | 6 | v1/v2 | BOM/manufacturing/定做生产.md
Structure | Flange connecting plate | Sheet metal | 6 | v1/v2 | BOM/manufacturing/定做生产.md
Structure | Base support | Sheet metal | 1 | v1/v2 | BOM/manufacturing/定做生产.md
Carbon tube | XX long carbon tube | 50 x 46 mm | 2 | v1/v2 | BOM/manufacturing/定做生产.md
Carbon tube | XY long carbon tube | 50 x 46 mm | 2 | v1/v2 | BOM/manufacturing/定做生产.md
Carbon tube | Short carbon tube | 50 x 46 mm | 2 | v1/v2 | BOM/manufacturing/定做生产.md
Carbon tube | Base carbon tube | 50 x 46 mm | 1 | v1/v2 | BOM/manufacturing/定做生产.md
3D printed | Joint bottom | 9400A photopolymer resin | 3 | v1 | BOM/manufacturing/3D打印/备注.txt | Print orientation not documented
3D printed | Joint top | 9400A photopolymer resin | 3 | v1 | BOM/manufacturing/3D打印/备注.txt | Print orientation not documented
3D printed | Fixture base | 9400A photopolymer resin | 1 | v1 | BOM/manufacturing/3D打印/备注.txt
3D printed | Base | 9400A photopolymer resin | 1 | v1 | BOM/manufacturing/3D打印/备注.txt
3D printed | Gas sensor housing | 9400A photopolymer resin | 1 | v1 | BOM/manufacturing/3D打印/备注.txt
3D printed | Gas sensor base | 9400A photopolymer resin | 2 | v1 | BOM/manufacturing/3D打印/备注.txt
3D printed | Ultrasonic module base | 9400A photopolymer resin | 1 | v1 | BOM/manufacturing/3D打印/备注.txt
3D printed | Print batch 1 | 17 part types | 1 batch | v1 | BOM/manufacturing/3D打印/3D打印清单.md | See checklist for quantities
3D printed | Reprint batch | 8 part types | 1 batch | v1 | BOM/manufacturing/3D打印补印/3D打印清单.md | Reprint after first fit check
Joint | 45 degree joint module | Servo or stepper drive + bracket | 1 | v1/v2 | Report 2.3.4 / 5.2.2
Joint | 90 degree joint module | Servo or stepper drive + bracket | 2 | v1/v2 | Report 2.3.4 / 5.2.2
Drive v1 | Digital servo | 15 kgf.cm; 5-9 V; PWM; 180 deg; 0.16 s/60 deg at 6 V | 3 | v1 | Report 2.3.1 | Stall torque about 1.47 N.m
Drive v2 | Stepper motor | 42BYGH47 | 3 | v2 | Report 5.2.2 | Drawing shows 42BYGH27; resolve before build
Drive v2 | Planetary gearbox | FLE-42-20; 1:20 | 3 | v2 | Report 5.2.2
Drive v2 | Magnetic encoder closed-loop controller | Model not stated | 3 | v2 | Report 5.2.2
Control v1 | Raspberry Pi Pico W | RP2040 dual-core 133 MHz; 264 KB SRAM; 2 MB flash; Wi-Fi | 1 | v1 | Report 2.3.2
Control v1 | Base PCB | Base module carrier | 1 | v1 | Report 2.3.2; electronics/output/gerber/v1_module_boards
Control v1 | Joint A / Joint B PCB | 3 PWM outputs + 5 LEDs + servo selector each | 2 | v1 | Report 2.3.2; electronics/output/gerber/v1_module_boards
Control v1 | Holder / Sensor PCB | 2 ADC inputs + 3 PWM outputs | 1 | v1 | Report 2.3.2; electronics/output/gerber/v1_module_boards
Control v1 | Expand Controller PCB | GNSS + 0.96 inch OLED + 8 x 2P gold-finger header | 1 | v1 | Report 4.2.2; electronics/output/gerber/v1_module_boards
Control v2 | STM32F103C8T6 CAN module | Model not stated | 3 | v2 | Report 5.2.2
Control v2 | STM32F407ZGT6 CAN controller | Model not stated | 1 | v2 | Report 5.2.3
Power | DC power supply | 350 W | 1 | v2 | Report 5.2.3
Platform | Aluminium profile frame | 4040 European standard profile | 1 | v2 | Report 5.2.3
Platform | Test positioning plate | 3 plates | 3 | v1/v2 | Report 2.3.4 / 5.2.3
End effector | Parallel gripper | Payload diameter <= 50 mm | 1 | v1/v2 | Report 2.3.3
End effector | Ultrasonic module | HC-SR04 | 1 | v1/v2 | Report 2.3.3
End effector | Gas sensor module | MQ series analogue sensor | 1 | v1/v2 | Report 2.3.3
End effector | Pen module | 16 mm fixture | 1 | v1/v2 | Report 4.2.2; media/photos/project
Fasteners | M3 / M5 screws and nuts | Assorted | As required | v1/v2 | Report 2.2; mechanical/source/standard_parts
Wiring | Module interconnect | 16P 2.54 mm gold-finger plug and socket | As required | v1 | Report 2.3.2
Wiring | Internal module wiring | 12P 1 mm FPC + XH 3P 2.54 mm | As required | v1 | Report 2.3.2
PCB | OnesArm Controller board | Gerber + BOM | 1 | v2 | electronics/output/gerber/controller_monitor
PCB | OnesArm Monitor board | Gerber + BOM | 1 | v2 | electronics/output/gerber/controller_monitor
PCB | v1 module board set | Base + Joint A/B + Holder/Sensor + Expand Controller | 1 set | v1 | electronics/output/gerber/v1_module_boards
