Robusr/OnesArm/electronics/output/bom/controller_monitor/BOM_OnesArm_Monitor_2024-07-20.csv

ID | Name | Designator | Footprint | Quantity | Manufacturer Part | Manufacturer | Supplier | Supplier Part | Price
1 | 100uF | C1 | CAP-8*12 | 1 | EEUFC1H681 | PANASONIC | LCSC | C178674 | 5.87
2 | 220uF | C2 | CAP-8*12 | 1 | EEUFC1V221B | PANASONIC | LCSC | C178681 | 1.781
3 | ZX-XH2.54-2PWZ | CN1,CN2,CN3,CN4,CN5 | CONN-TH_2P-P2.50_ZX-XH2.54-2PWZ | 5 | ZX-XH2.54-2PWZ | Megastar(兆星) | LCSC | C7429641 | 0.0823
4 | 1N5822D_SMA | D1 | SMA_L4.3-W2.6-LS5.2-RD | 1 | 1N5822D_SMA | null | LCSC | C9900001949
5 | HDR-M-2.54_2x4 | J1 | HDR-M-2.54_2X4 | 1 |  |  | LCSC | C58363 | 0.1969
6 | 47uH | L1 | IND-SMD_L12.3-W12.3 | 1 | CDRH127N-470M | 登壹(MINGSTAR) | LCSC | C962356 | 1.5656
7 | TC5050RGBF08-3CJH-AF53A | LED1 | LED-SMD_6P-L5.0-W5.0-TL_TC5050RGBF08 | 1 | TC5050RGBF08-3CJH-AF53A | TCWIN(天成) | LCSC | C784540 | 0.1117
8 | LED-0603_G | LED2,LED3,LED4 | LED0805-R-RD-1 | 3 | 19-217/GHC-YR1S2/3T | EVERLIGHT(台湾亿光) | LCSC | C72043 | 0.1999
9 | 1k | R1,R2,R4 | R0805 | 3
10 | 120 | R3 | R0805 | 1
11 | TJA1050T/CM,118 | TJA1050 | SOIC-8_L5.0-W4.0-P1.27-LS6.0-BL | 1 | TJA1050T/CM,118 | NXP | LCSC | C6952 | 5
12 | KH-2.54FH-2X29P-H8.5 | U1,U2 | HDR-TH_58P-P2.54-V-F-R2-C29-S2.54 | 2 | KH-2.54FH-2X29P-H8.5 | kinghelm(金航标) | LCSC | C22440851 | 2.13
13 | XT60PW-F_C428722 | U3,U4,U5,U6,U7,U8 | TH_2P-XT60PW-F | 6 | XT60PW-F | AMASS(艾迈斯) | LCSC | C428722 | 3.3
14 | LM2596S-5.0 | U10 | TO-263-5_L10.1-W8.7-P1.70-LS14.4-BR | 1 | LM2596S-5.0/TR | HGC(Huaguan Semicon) | LCSC | C459077 | 1.6744
15 | TS-1002S-05026C | SW1,SW2,SW3,SW4 | KEY-SMD_4P-L6.0-W6.0-P4.50-LS9.0 | 4 | TS-1002S-05026C | XUNPU(讯普) | LCSC | C455110 | 0.2514
16 | HDR-M-2.54_1x2 | J2 | HDR-M-2.54_1X2 | 1 |  |  | LCSC | C124375 | 0.1477
17 | XH-3AW_C2908612 | CN6 | CONN-TH_3P-P2.54_HCTL_XH-3AW | 1 | XH-3AW | HCTL(华灿天禄) | LCSC | C2908612 | 0.1052
