Robusr/OnesArm/electronics/output/bom/v1_module_boards/BOM_OnesArm_ExpandController_v1_2024-03-17.csv

ID | Name | Designator | Footprint | Quantity | Manufacturer Part | Manufacturer | Supplier | Supplier Part | Price
1 | 1uF | A1,A2,C2 | C0603 | 3 | CL10A105KB8NNNC | SAMSUNG | LCSC | C15849 | 0.0312
2 | 10K | R1,R3,R4,R6 | R0603 | 4 | TC0325B1002T5E | UniOhm | LCSC | C39050 | 0.2643
3 | 0.1 | R5 | R2512 | 1 | PT2512FK-7W0R1L | YAGEO | LCSC | C309534 | 1.2209
4 | INA219AIDCNR | U8 | SOT-23-8_L3.0-W1.7-P0.65-LS2.8-BL | 1 | INA219AIDCNR | TI | LCSC | C87469 | 4.59
5 | HC-PH-5AW-G | U7 | CONN-TH_5P-P2.00_HCTL_HC-PH-5AW-X | 1 | HC-PH-5AW-G | HCTL(华灿天禄) | LCSC | C5342445 | 0.2384
6 | PH-10AW_C2908642 | CN1 | CONN-TH_10P-P2.00_HCTL_PH-10AW | 1 | PH-10AW | HCTL(华灿天禄) | LCSC | C2908642 | 0.3501
7 | LED-0805_R | LED1,LED3 | LED0805_RED | 2 | 17-21SURC/S530-A3/TR8 | EVERLIGHT(台湾亿光) |  | C72037 | 0.137
8 | 0.96OLED_4P | OLED1 | 0.96OLED_4P | 1 |  |  | LCSC
9 | TS-1002S-05026C | SW1 | KEY-SMD_4P-L6.0-W6.0-P4.50-LS9.0 | 1 | TS-1002S-05026C | XUNPU(讯普) | LCSC | C455110 | 0.2514
10 | Power | U1,U2,U3,U4 | CONN-TH_2P-P2.00_HDGC_HDGC2001WV-2P | 4 | HDGC2001WV-2P | HDGC(华德共创) | LCSC | C5175230 | 0.0454
11 | ED16BGFBK | U6 | CONN-TH_ED16BGFBK | 1 | ED16BGFBK | WingTAT(格林柏) | LCSC | C5173292 | 2.65
12 | MICROUSB | USB1 | MICRO USB | 1 | MICRO5.9mmusb | SHOU HAN | LCSC | C393940 | 0.1694
