Robusr/OnesArm/BOM/manufacturing/3D打印补印/3D打印清单.md

# 3D打印清单

### 1、短连杆*2

### 2、法兰连接*1

### 3、夹臂*2

### 4、夹爪基座*1

### 5、内连杆*2

### 6、长连杆右*1

### 7、长连杆左*1

### 8、零空间运动测试组件*1
