Robusr/OnesArm/BOM/manufacturing/工作平台定位板/清单2.md

# 清单2

## 1、测试定位板

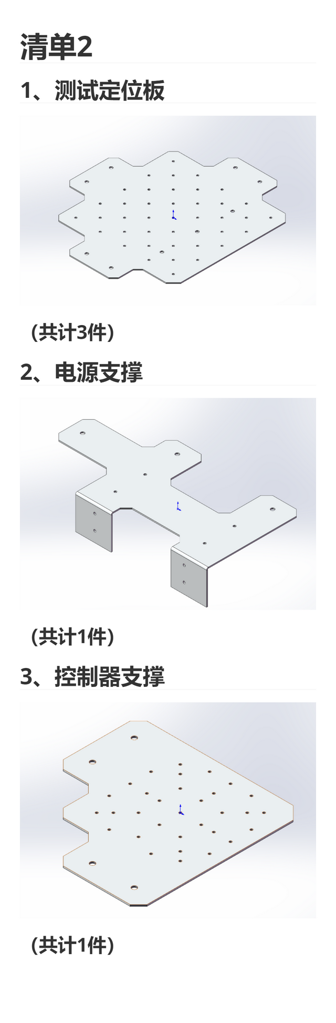
[picture p158: BOM/manufacturing/工作平台定位板/清单2.png]
清单


### （共计3件）

## 2、电源支撑

清单

### （共计1件）

## 3、控制器支撑

清单

### （共计1件）
