Robusr/OnesArm/BOM/manufacturing/碳管定做/清单.md

# 清单

## 1、XX长

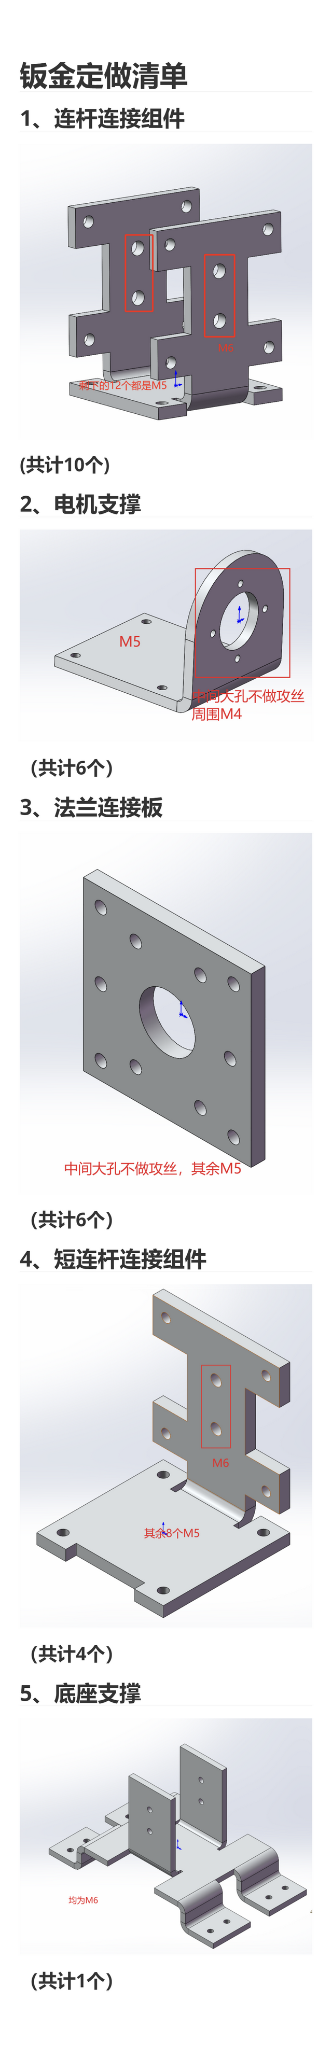
[picture p159: BOM/manufacturing/钣金攻丝/清单.png]
清单


### (共计2个)

## 2、XY长

### 正面

清单

### 侧面

清单

### （共计2个）

## 3、短

清单

### （共计2个）

## 4、底座长

清单

### （共计1个）
