Robusr/OnesArm/BOM/manufacturing/钣金攻丝/清单.md

# 钣金定做清单

## 1、连杆连接组件

清单

### (共计10个)

## 2、电机支撑

清单

### （共计6个）

## 3、法兰连接板

清单

### （共计6个）

## 4、短连杆连接组件

清单

### （共计4个）

## 5、底座支撑

清单

### （共计1个）
