Robusr/OnesArm/electronics/output/bom/controller_monitor/BOM_OnesArm_Controller_2024-07-20.csv

ID | Name | Designator | Footprint | Quantity | Manufacturer Part | Manufacturer | Supplier | Supplier Part | Price
1 | HDR-F-2.54_1x20 | H1,H2 | HDR-F-2.54_1X20 | 2 |  |  | LCSC | C50984 | 1.1153
2 | ZX-XH2.54-8PWZ | U1 | CONN-TH_8P-P2.50_ZX-XH2.54-8PWZ | 1 | ZX-XH2.54-8PWZ | Megastar(兆星) | LCSC | C7429647 | 0.2686
3 | 100uF | C1 | CAP-8*12 | 1 | EEUFC1H681 | PANASONIC | LCSC | C178674 | 5.87
4 | 220uF | C2 | CAP-8*12 | 1 | EEUFC1V221B | PANASONIC | LCSC | C178681 | 1.781
5 | ZX-XH2.54-2PWZ | CN1 | CONN-TH_2P-P2.50_ZX-XH2.54-2PWZ | 1 | ZX-XH2.54-2PWZ | Megastar(兆星) | LCSC | C7429641 | 0.0823
6 | 47uH | L1 | IND-SMD_L12.3-W12.3 | 1 | CDRH127N-470M | 登壹(MINGSTAR) | LCSC | C962356 | 1.5656
7 | TC5050RGBF08-3CJH-AF53A | LED1 | LED-SMD_6P-L5.0-W5.0-TL_TC5050RGBF08 | 1 | TC5050RGBF08-3CJH-AF53A | TCWIN(天成) | LCSC | C784540 | 0.1117
8 | 120 | R3 | R0805 | 1
9 | TJA1050T/CM,118 | TJA1050 | SOIC-8_L5.0-W4.0-P1.27-LS6.0-BL | 1 | TJA1050T/CM,118 | NXP | LCSC | C6952 | 5
10 | XT60PW-F_C428722 | U7 | TH_2P-XT60PW-F | 1 | XT60PW-F | AMASS(艾迈斯) | LCSC | C428722 | 3.3
11 | LM2596S-5.0 | U10 | TO-263-5_L10.1-W8.7-P1.70-LS14.4-BR | 1 | LM2596S-5.0/TR | HGC(Huaguan Semicon) | LCSC | C459077 | 1.6744
12 | 1N5822D_SMA | D1 | SMA_L4.3-W2.6-LS5.2-RD | 1 | 1N5822D_SMA | null | LCSC | C9900001949
