Robusr/OnesArm/BOM/manufacturing/3D打印补印/3D打印清单.png

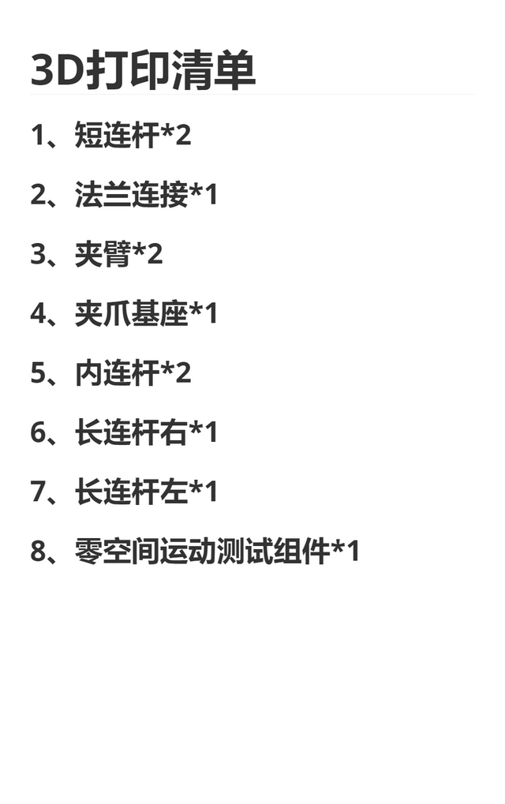
BOM/manufacturing/3D打印补印/3D打印清单.png
