Robusr/OnesArm/mechanical/source/standard_parts/螺丝/内六角/内六角螺栓.png

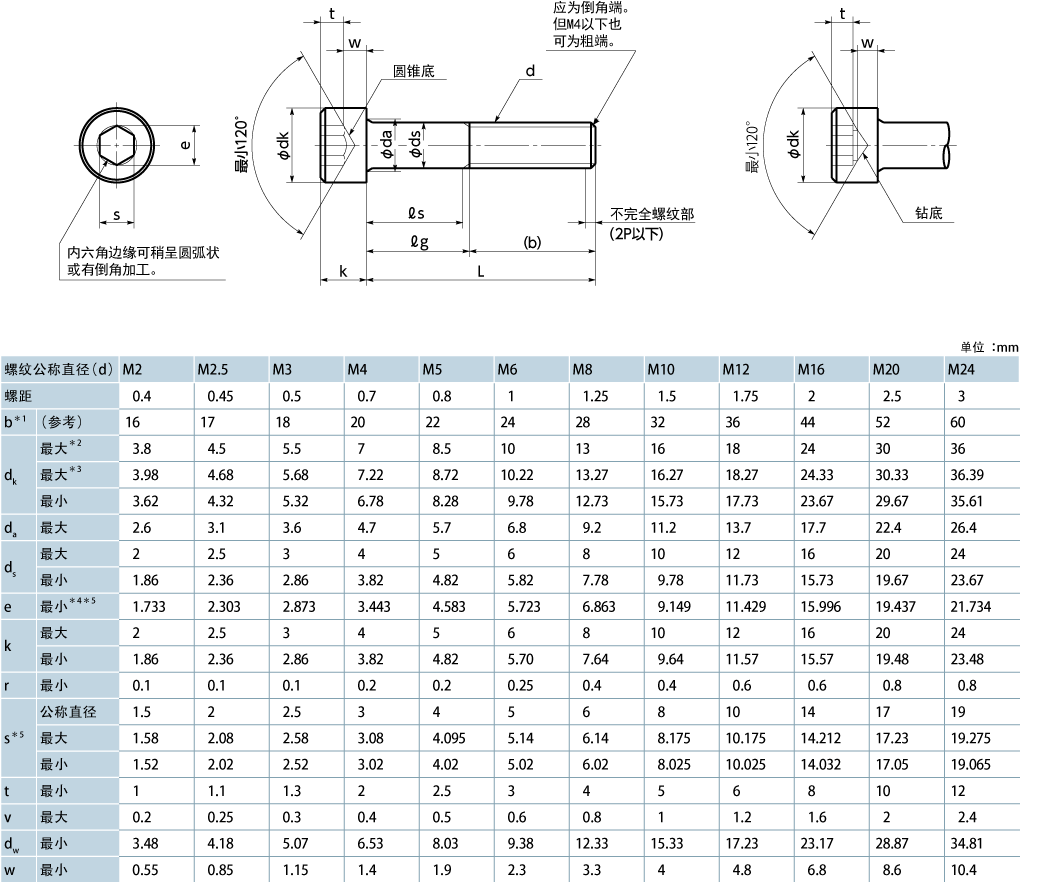
mechanical/source/standard_parts/螺丝/内六角/内六角螺栓.png
