Robusr/OnesArm/mechanical/source/analysis_models/kinematics/AyCxBy-D型机械臂图纸/2.SLDASM

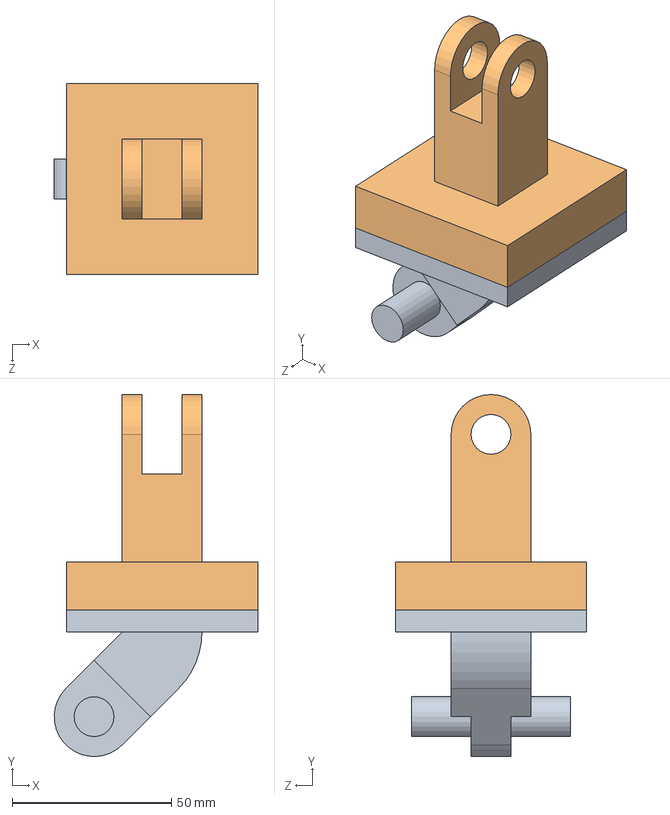
[picture p162: CAD file, 2026-10-19]
mechanical/source/analysis_models/kinematics/AyCxBy-D型机械臂图纸/2.SLDASM
63.8 x 113.5 x 60.0 mm
C45度关节顶部简化
B直关节底部简化
