Robusr/OnesArm/mechanical/source/assemblies/current/装配测试1.SLDASM

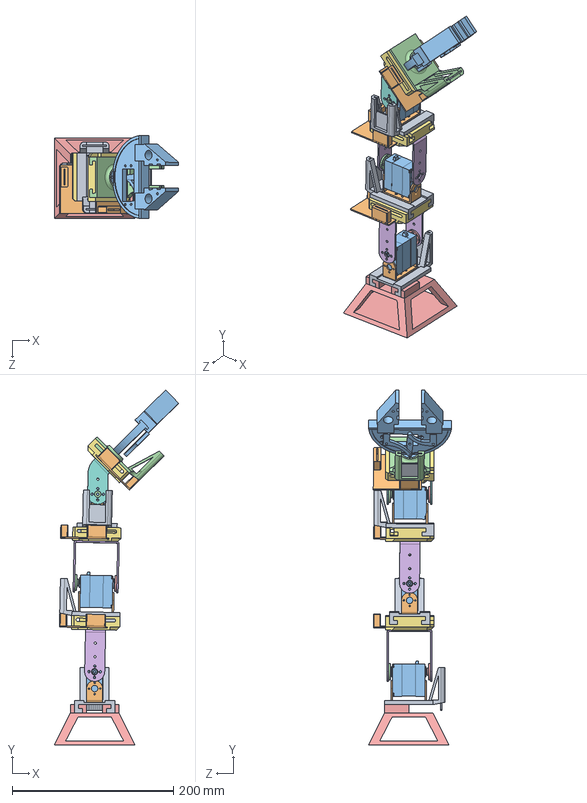
[picture p163: CAD file, 2026-10-19]
mechanical/source/assemblies/current/装配测试1.SLDASM
154.2 x 440.4 x 103.1 mm
直关节底部 x 3
窄U支架 x 3
15KG双轴舵机 x 3
金属从舵盘 x 3
金属主舵盘 x 3
长U支架 x 2
直关节顶部 x 3
斜U支架
底部连接PCB x 4
顶部连接PCB x 3
平行夹具整体
夹具底部
底座
