Robusr/OnesArm/mechanical/source/assemblies/simplified_24/装配/ABC/AyByCy.SLDASM

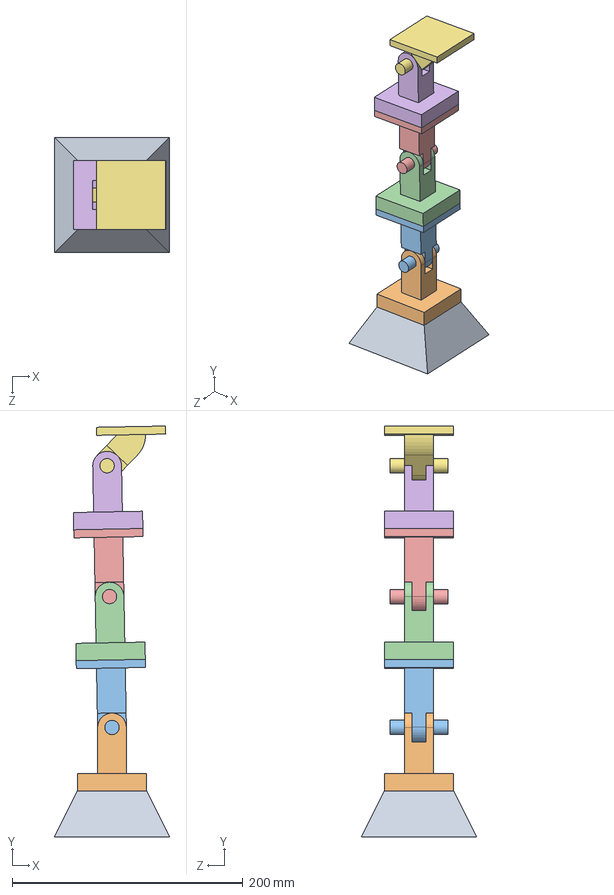
[picture p164: CAD file, 2026-10-19]
mechanical/source/assemblies/simplified_24/装配/ABC/AyByCy.SLDASM
100.0 x 356.4 x 100.0 mm
底座简化
A直关节底部简化
A直关节顶部简化
B直关节底部简化
B直关节顶部简化
C45度关节底部简化
C45度关节顶部简化
