Robusr/OnesArm/mechanical/source/end_effectors/手写模块/手写模块.SLDASM

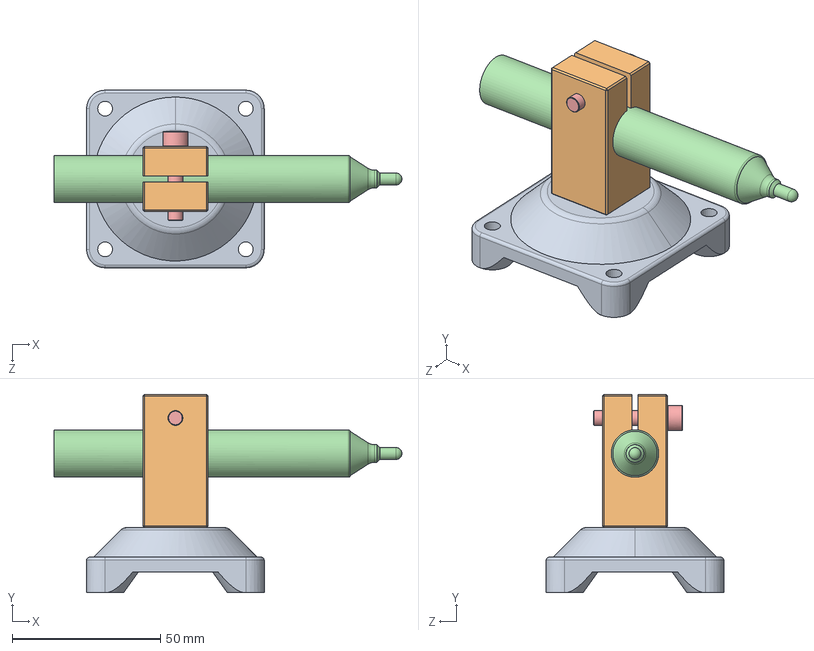
[picture p165: CAD file, 2026-10-19]
mechanical/source/end_effectors/手写模块/手写模块.SLDASM
117.5 x 67.0 x 60.0 mm
手写模块连接组件
16mm夹具
SCA-M5-L16 x 4
手写笔
SCA-M5-L25
