Robusr/OnesArm/mechanical/source/fea_models/静力学/SolidWorks有限元分析/整体/装配测试2.SLDASM

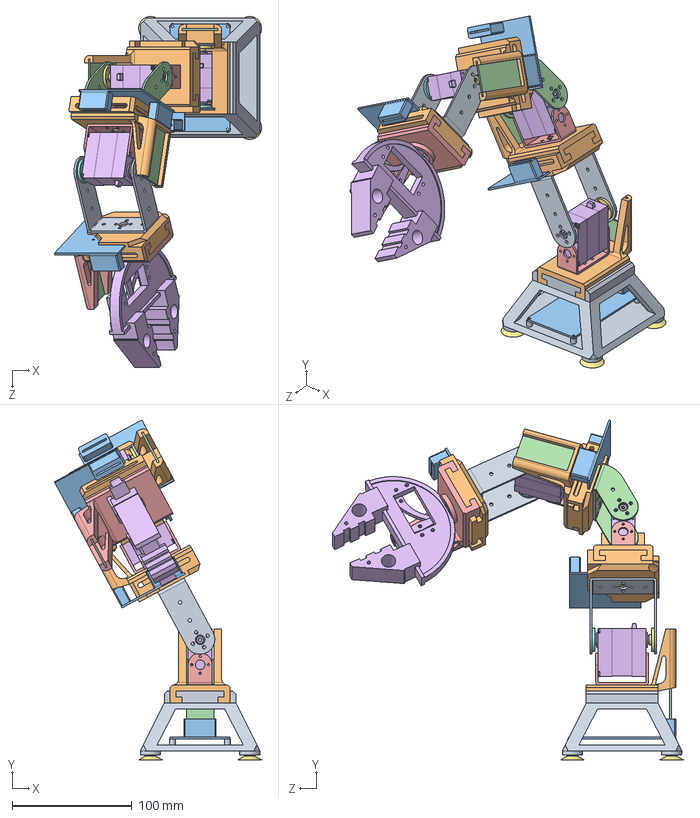
[picture p166: CAD file, 2026-10-19]
mechanical/source/fea_models/静力学/SolidWorks有限元分析/整体/装配测试2.SLDASM
173.4 x 284.5 x 293.8 mm
底座
关节底部 x 3
控制主板PCB
底部连接PCB x 4
窄U支架 x 3
15KG双轴舵机 x 3
金属从舵盘 x 3
金属主舵盘 x 3
长U支架 x 2
关节顶部 x 3
顶部连接PCB x 3
斜U支架
夹具底部
平行夹具整体
吸盘 x 4
