Robusr/OnesArm/mechanical/source/analysis_models/kinematics/AyCxBy-D型机械臂图纸/AyCxBy-D连杆.SLDASM

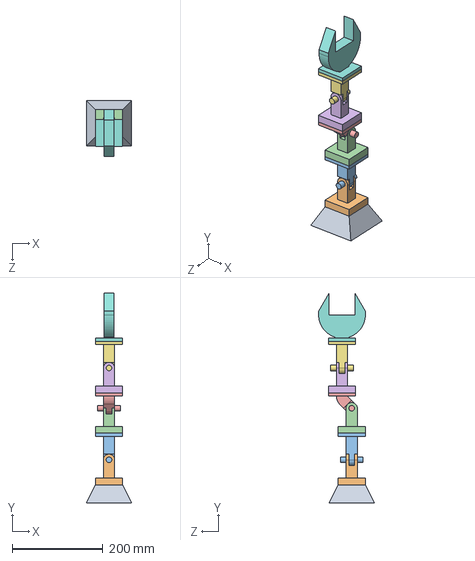
[picture p167: CAD file, 2026-10-19]
mechanical/source/analysis_models/kinematics/AyCxBy-D型机械臂图纸/AyCxBy-D连杆.SLDASM
100.0 x 462.0 x 122.8 mm
B直关节顶部简化
夹具
