Robusr/OnesArm/mechanical/source/assemblies/current/斜关节装配.SLDASM

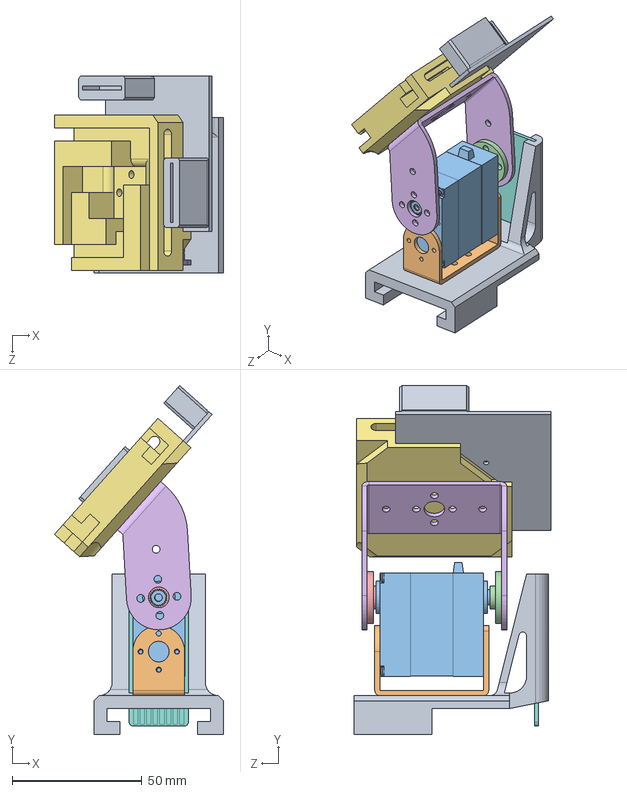
[picture p168: CAD file, 2026-10-19]
mechanical/source/assemblies/current/斜关节装配.SLDASM
65.2 x 134.7 x 76.0 mm
关节底部
窄U支架
15KG双轴舵机
金属从舵盘
金属主舵盘
斜U支架
关节顶部
底部连接PCB
顶部连接PCB
