Robusr/OnesArm/mechanical/source/assemblies/simplified_24/零件/B关节.SLDASM

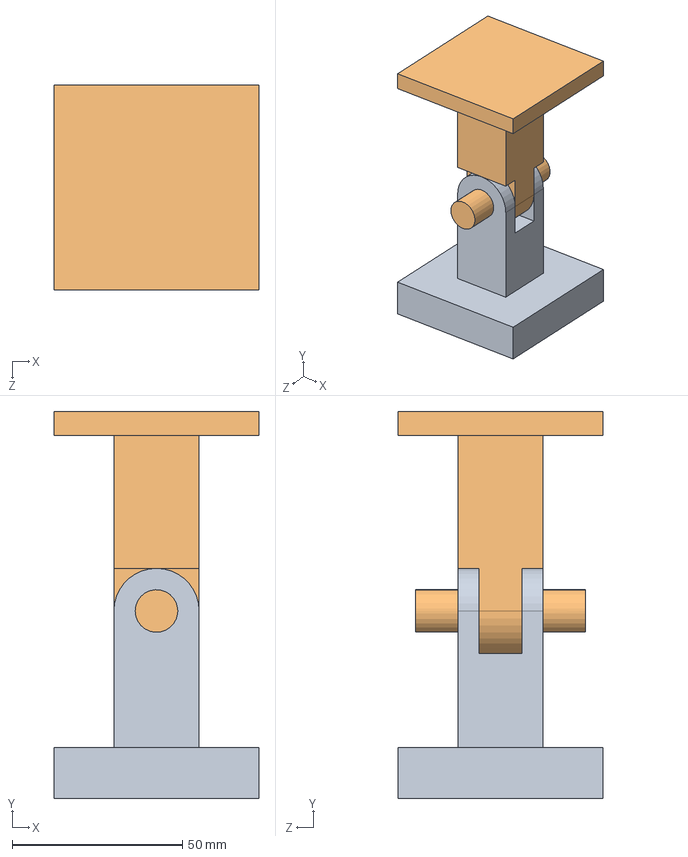
[picture p169: CAD file, 2026-10-19]
mechanical/source/assemblies/simplified_24/零件/B关节.SLDASM
60.0 x 113.5 x 60.0 mm
B直关节底部简化
B直关节顶部简化
