Robusr/OnesArm/mechanical/source/end_effectors/ultrasonic/超声波模块装配.SLDASM

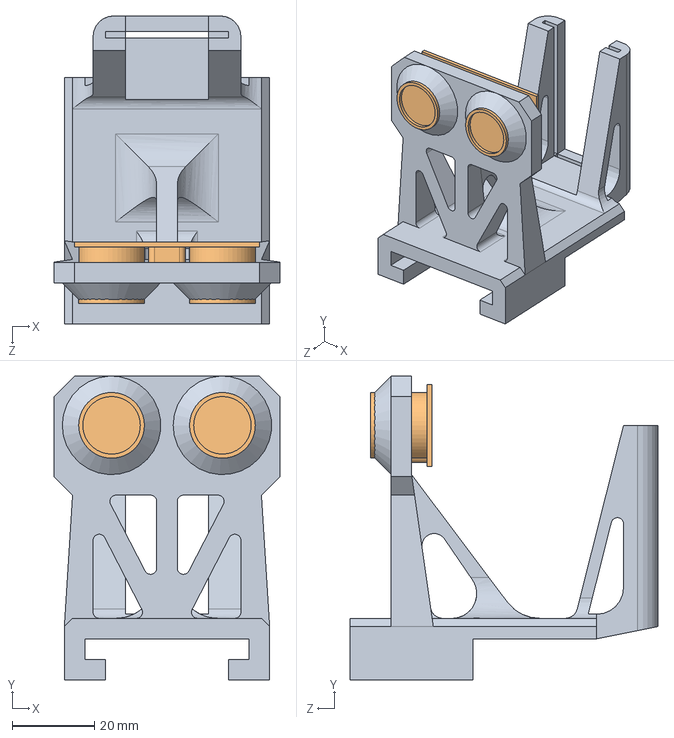
[picture p170: CAD file, 2026-10-19]
mechanical/source/end_effectors/ultrasonic/超声波模块装配.SLDASM
55.0 x 74.0 x 75.0 mm
超声波模块底座
超声波模块
