Robusr/OnesArm/mechanical/source/analysis_models/kinematics/AyCxBy-D型机械臂图纸/1.SLDASM

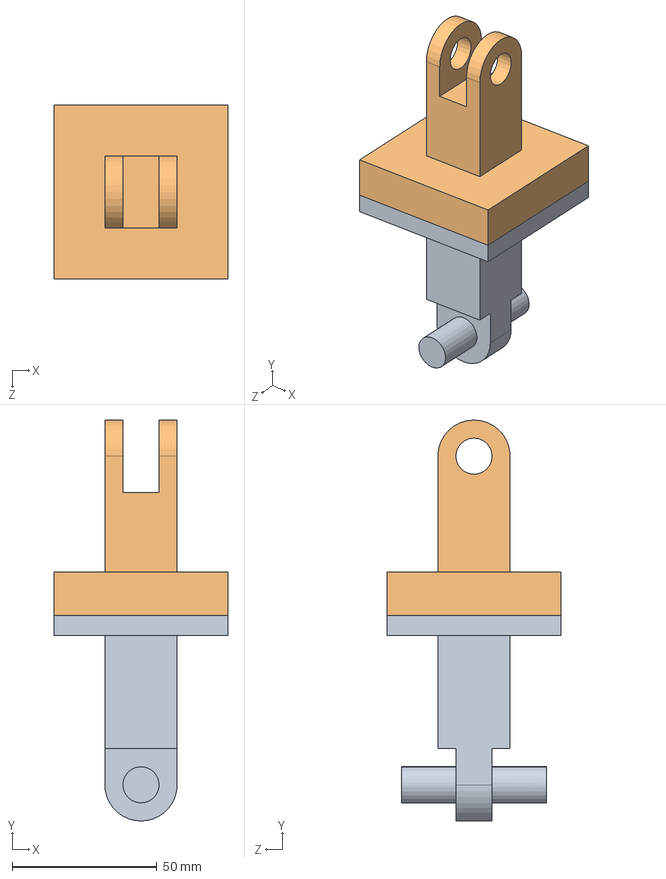
[picture p171: CAD file, 2026-10-19]
mechanical/source/analysis_models/kinematics/AyCxBy-D型机械臂图纸/1.SLDASM
60.0 x 138.5 x 60.0 mm
A直关节顶部简化
C45度关节底部简化
