Robusr/OnesArm/mechanical/source/assemblies/current/装配测试2.SLDASM

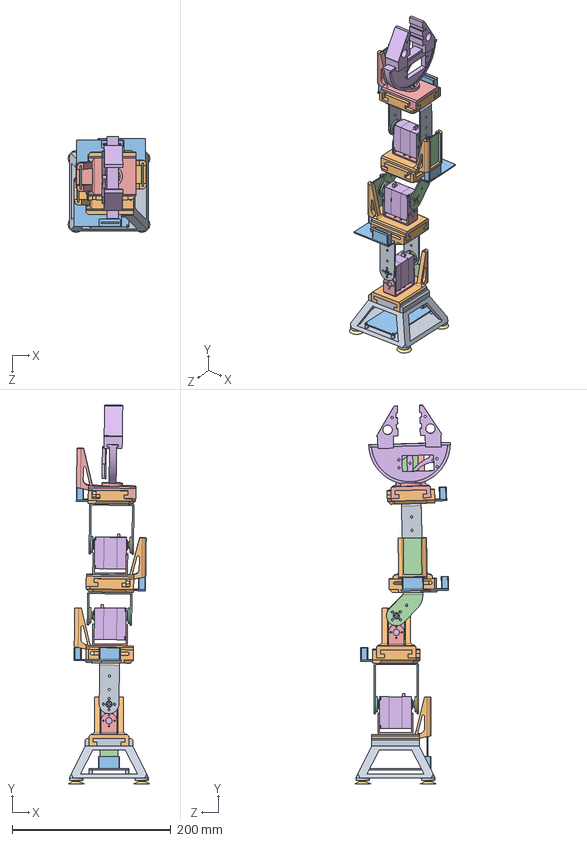
[picture p172: CAD file, 2026-10-19]
mechanical/source/assemblies/current/装配测试2.SLDASM
102.9 x 477.9 x 120.5 mm
底座
关节底部 x 3
控制主板PCB
底部连接PCB x 4
窄U支架 x 3
15KG双轴舵机 x 3
金属从舵盘 x 3
金属主舵盘 x 3
长U支架 x 2
关节顶部 x 3
顶部连接PCB x 3
斜U支架
夹具底部
平行夹具整体
吸盘 x 4
