Robusr/OnesArm/mechanical/source/assemblies/simplified_24/零件/C关节.SLDASM

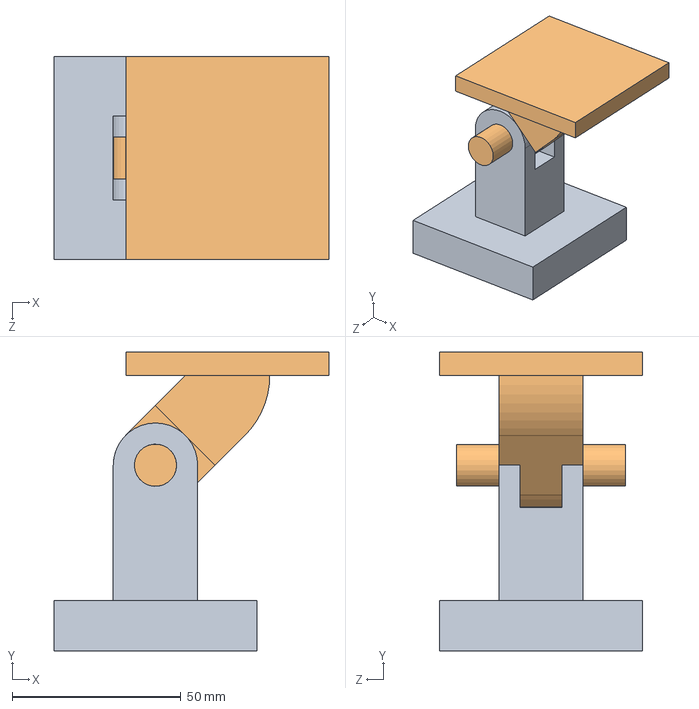
[picture p173: CAD file, 2026-10-19]
mechanical/source/assemblies/simplified_24/零件/C关节.SLDASM
81.3 x 88.5 x 60.0 mm
C45度关节底部简化
C45度关节顶部简化
