Robusr/OnesArm/mechanical/source/electronics_mechanics/电源/明纬S-350-24V.SLDASM

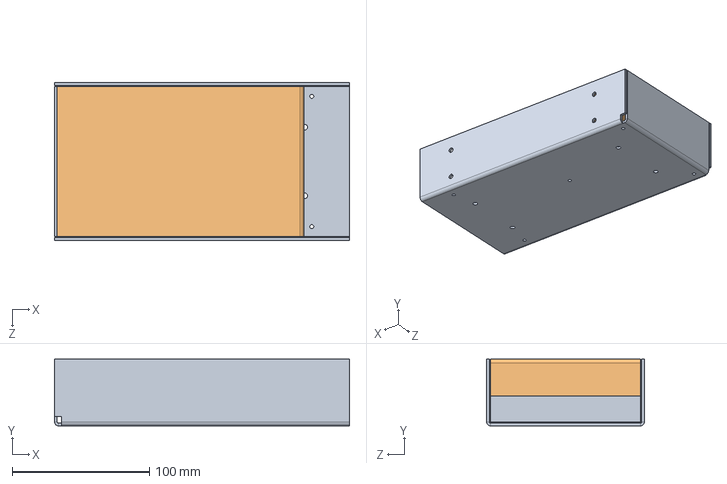
[picture p174: CAD file, 2026-10-19]
mechanical/source/electronics_mechanics/电源/明纬S-350-24V.SLDASM
215.0 x 48.7 x 115.0 mm
明纬S-350-24V(外壳)
明纬S-350-24V(上盖板)
