Robusr/OnesArm/mechanical/source/analysis_models/kinematics/AyCxBy-D型机械臂图纸/3.SLDASM

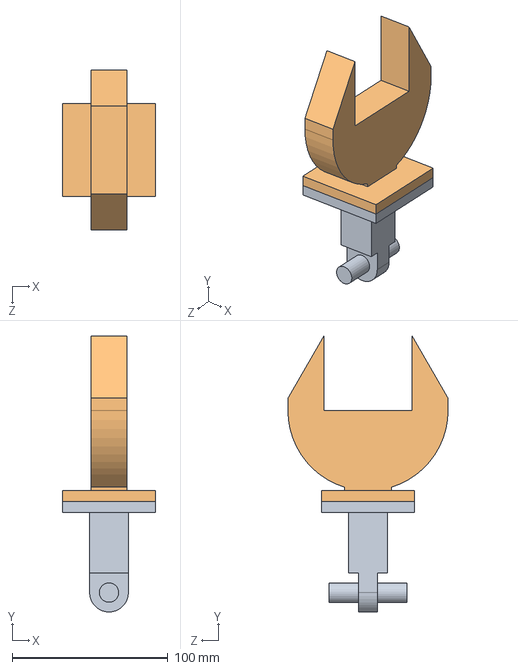
[picture p175: CAD file, 2026-10-19]
mechanical/source/analysis_models/kinematics/AyCxBy-D型机械臂图纸/3.SLDASM
60.0 x 177.5 x 103.0 mm
B直关节顶部简化
夹具
