Robusr/OnesArm/mechanical/source/assemblies/current/装配测试4.SLDASM

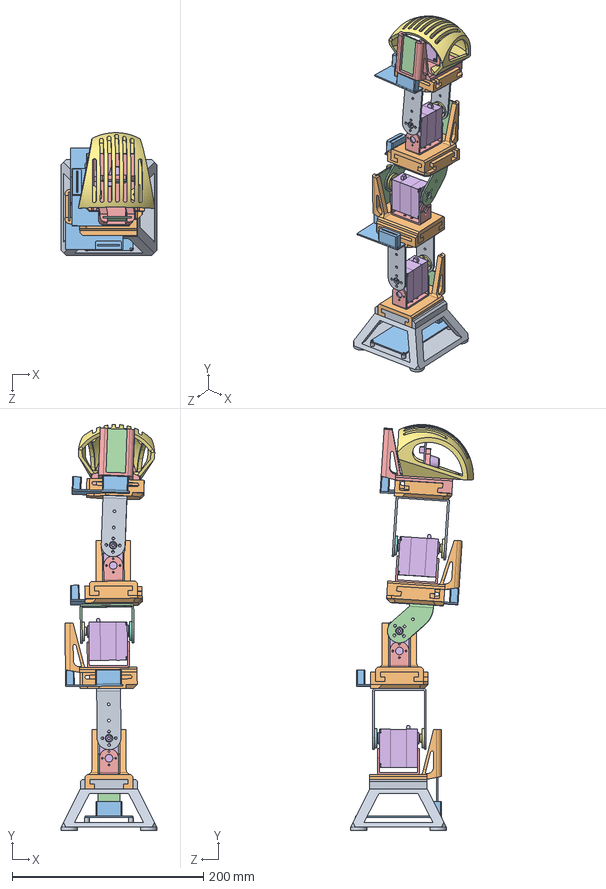
[picture p176: CAD file, 2026-10-19]
mechanical/source/assemblies/current/装配测试4.SLDASM
100.0 x 424.3 x 128.3 mm
底座
关节底部 x 3
控制主板PCB
底部连接PCB x 4
窄U支架 x 3
15KG双轴舵机 x 3
金属从舵盘 x 3
金属主舵盘 x 3
长U支架 x 2
关节顶部 x 3
顶部连接PCB x 3
斜U支架
气体传感器底座
MQ-135气体传感器
气体传感器保护罩
