Robusr/OnesArm/mechanical/output/3dp/step/current/关节顶部.STEP

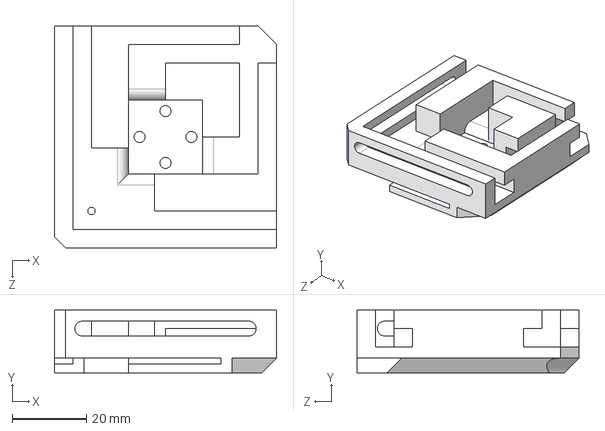
[picture p177: CAD file, 2026-10-19]
mechanical/output/3dp/step/current/关节顶部.STEP
60.0 x 17.0 x 60.0 mm
