Robusr/OnesArm/mechanical/output/3dp/step/print_batch_1/支架.STEP

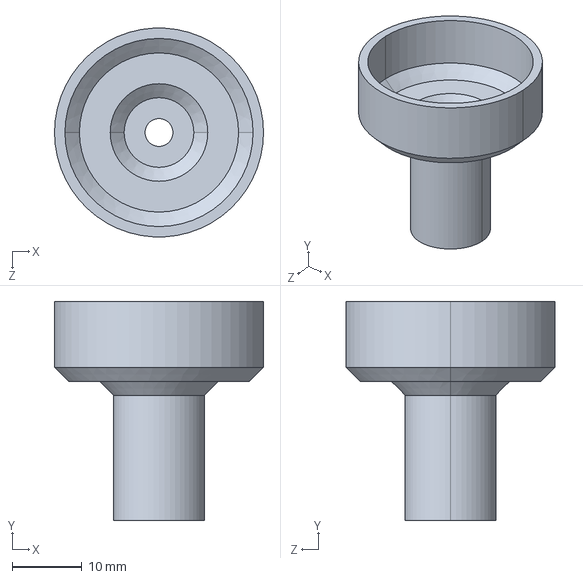
[picture p178: CAD file, 2026-10-19]
mechanical/output/3dp/step/print_batch_1/支架.STEP
30.0 x 31.5 x 29.9 mm
