Robusr/OnesArm/mechanical/output/3dp/step/print_batch_2/短连杆.STEP

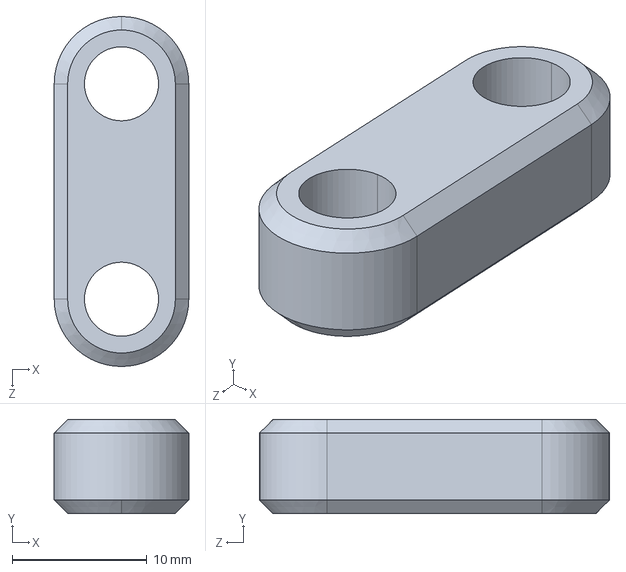
[picture p179: CAD file, 2026-10-19]
mechanical/output/3dp/step/print_batch_2/短连杆.STEP
10.0 x 7.00 x 26.0 mm
