Robusr/OnesArm/mechanical/output/3dp/stl_current/底座.STL

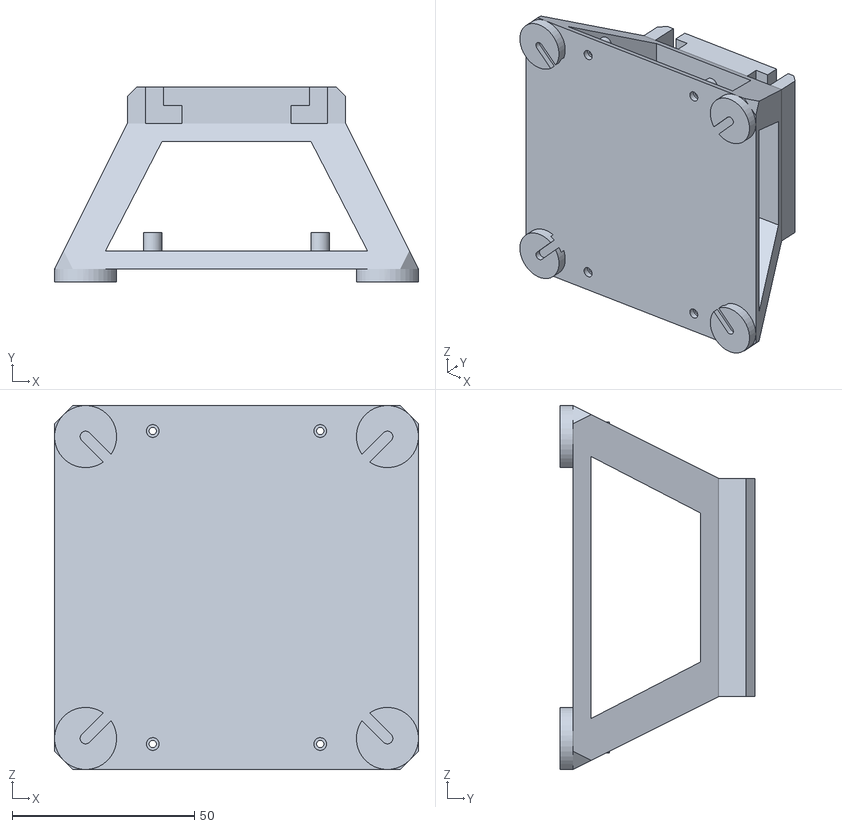
[picture p180: CAD file, 2026-10-19]
mechanical/output/3dp/stl_current/底座.STL
100.0 x 53.5 x 100.0
