Robusr/OnesArm/mechanical/output/carbon_tube/XX连杆碳管.STEP

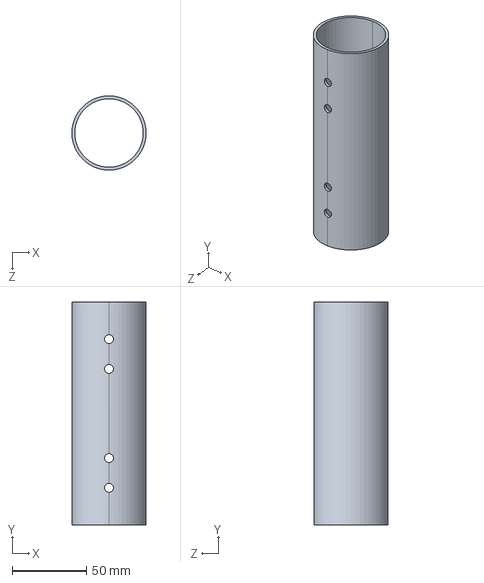
[picture p181: CAD file, 2026-10-19]
mechanical/output/carbon_tube/XX连杆碳管.STEP
50.0 x 150.0 x 50.0 mm
