Robusr/OnesArm/mechanical/output/platform/工作平台.STEP

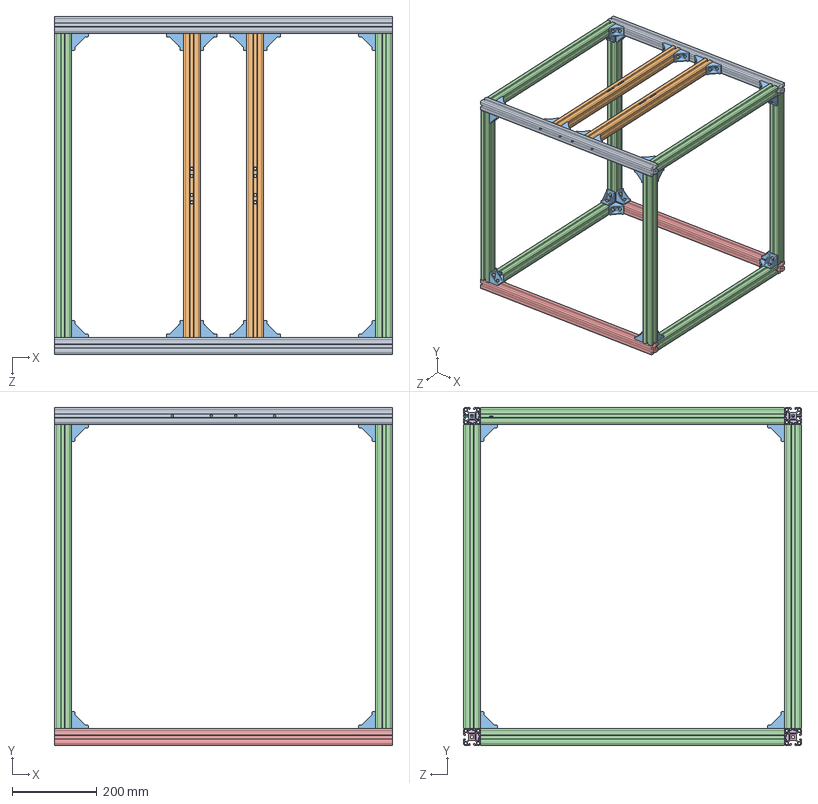
[picture p182: CAD file, 2026-10-19]
mechanical/output/platform/工作平台.STEP
800.0 x 800.0 x 800.0 mm
4040型材-上边框-800mm x 2
4040型材-支撑-720mm x 2
4040标准角码 x 32
4040型材-上边框-720mm x 2
4040型材-竖边框-720mm x 4
4040型材-下边框-800mm x 2
4040型材-下边框-720mm x 2
4040-M6-T倰蹟譫 x 73
SCA-M6-L16 x 56
SCA-M6-L45 x 8
