Robusr/OnesArm/mechanical/output/sheet_metal/法兰连接板(攻丝底孔).STEP

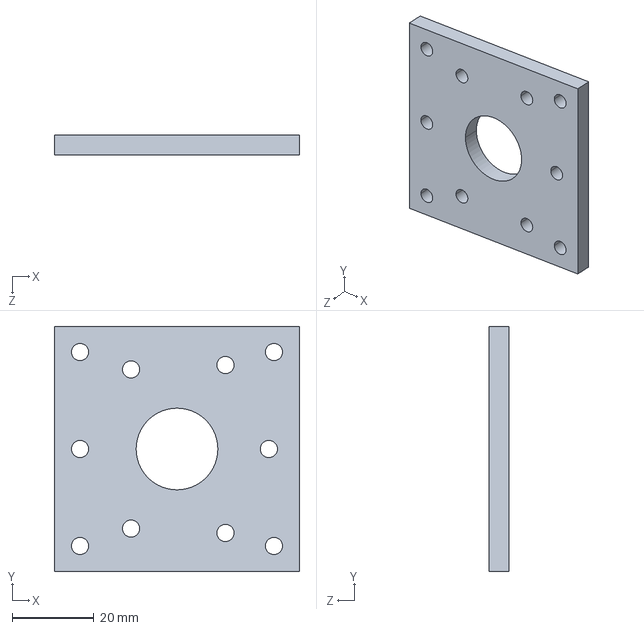
[picture p183: CAD file, 2026-10-19]
mechanical/output/sheet_metal/法兰连接板(攻丝底孔).STEP
60.0 x 60.0 x 5.00 mm
