Robusr/OnesArm/mechanical/source/analysis_models/kinematics/AyCxBy-D型机械臂图纸/Link/link0.STL

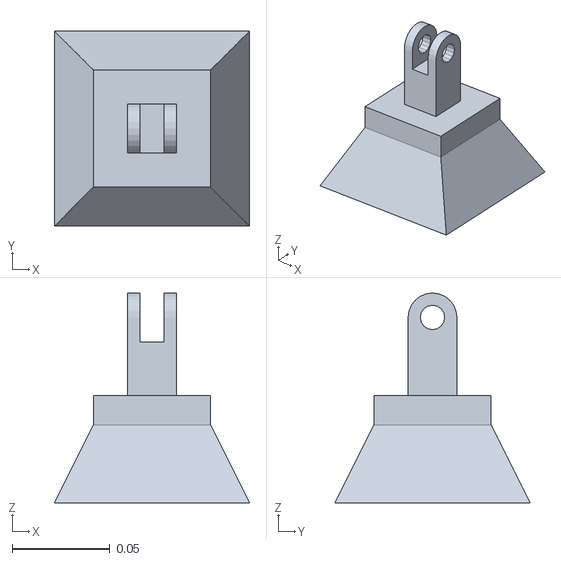
[picture p184: CAD file, 2026-10-19]
mechanical/source/analysis_models/kinematics/AyCxBy-D型机械臂图纸/Link/link0.STL
0.1 x 0.1 x 0.108
