Robusr/OnesArm/mechanical/source/assemblies/simplified_24/零件/A直关节顶部简化.SLDPRT

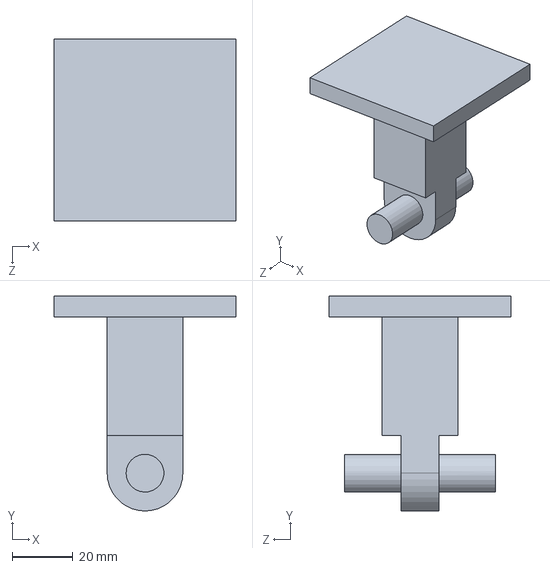
[picture p185: CAD file, 2026-10-19]
mechanical/source/assemblies/simplified_24/零件/A直关节顶部简化.SLDPRT
60.0 x 71.0 x 60.0 mm
