Robusr/OnesArm/mechanical/source/base/current/吸盘.SLDPRT

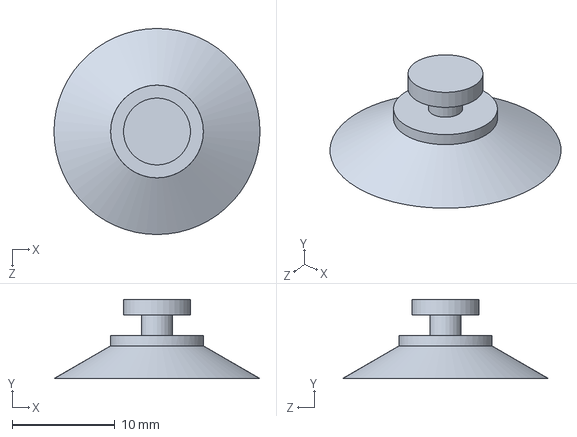
[picture p186: CAD file, 2026-10-19]
mechanical/source/base/current/吸盘.SLDPRT
20.0 x 7.68 x 20.0 mm
