Robusr/OnesArm/mechanical/source/electronics_mechanics/控制器/控制器定位板.SLDPRT

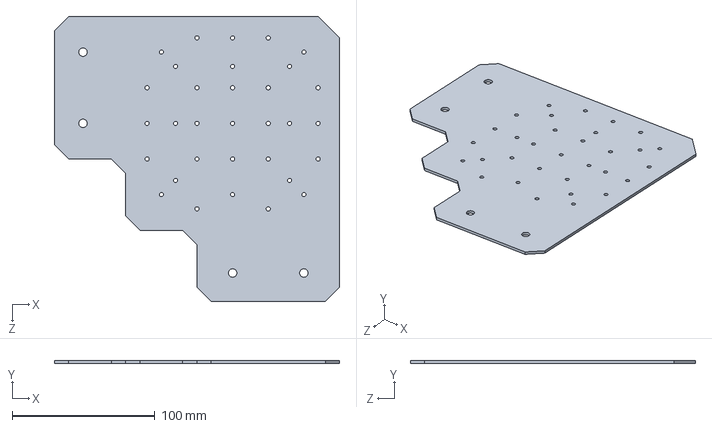
[picture p187: CAD file, 2026-10-19]
mechanical/source/electronics_mechanics/控制器/控制器定位板.SLDPRT
200.0 x 2.00 x 200.0 mm
