Robusr/OnesArm/mechanical/source/electronics_mechanics/控制器/闭环控制器/背面闭环控制器PCB.SLDPRT

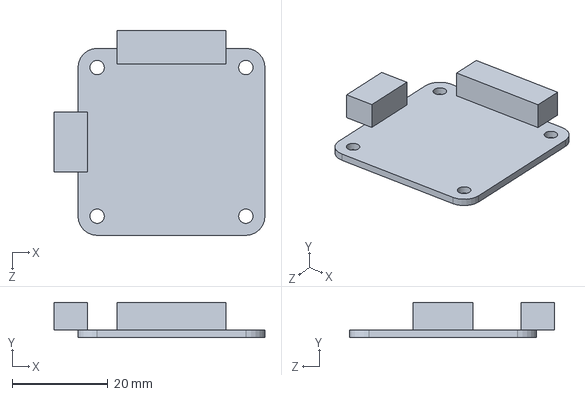
[picture p188: CAD file, 2026-10-19]
mechanical/source/electronics_mechanics/控制器/闭环控制器/背面闭环控制器PCB.SLDPRT
44.0 x 7.40 x 42.7 mm
