Robusr/OnesArm/mechanical/source/electronics_mechanics/电源/明纬S-350-24V(上盖板).SLDPRT

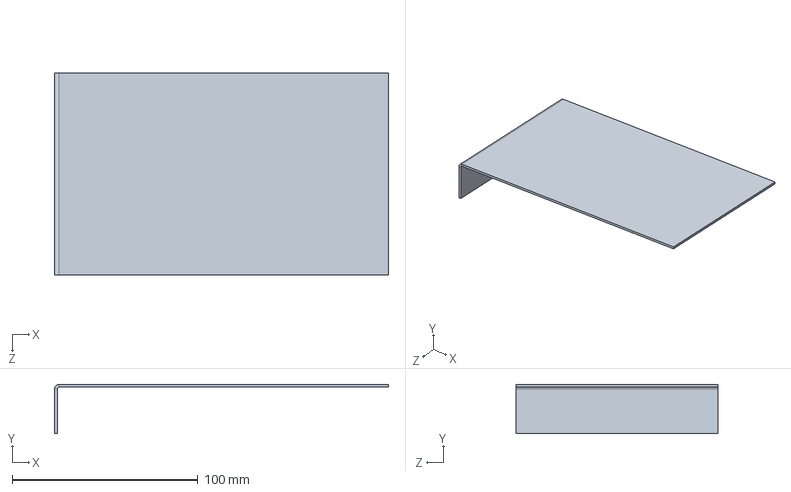
[picture p189: CAD file, 2026-10-19]
mechanical/source/electronics_mechanics/电源/明纬S-350-24V(上盖板).SLDPRT
180.0 x 26.5 x 109.0 mm
