Robusr/OnesArm/mechanical/source/end_effectors/夹爪模块/夹臂.SLDPRT

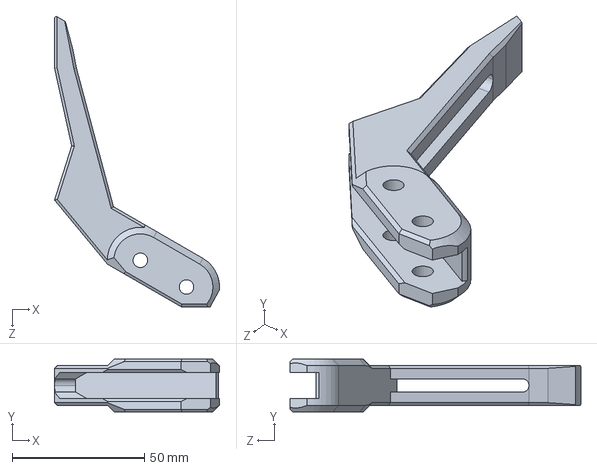
[picture p191: CAD file, 2026-10-19]
mechanical/source/end_effectors/夹爪模块/夹臂.SLDPRT
62.5 x 20.0 x 110.0 mm
