Robusr/OnesArm/mechanical/source/fea_models/静力学/SolidWorks有限元分析/Joint A/关节底部.SLDPRT

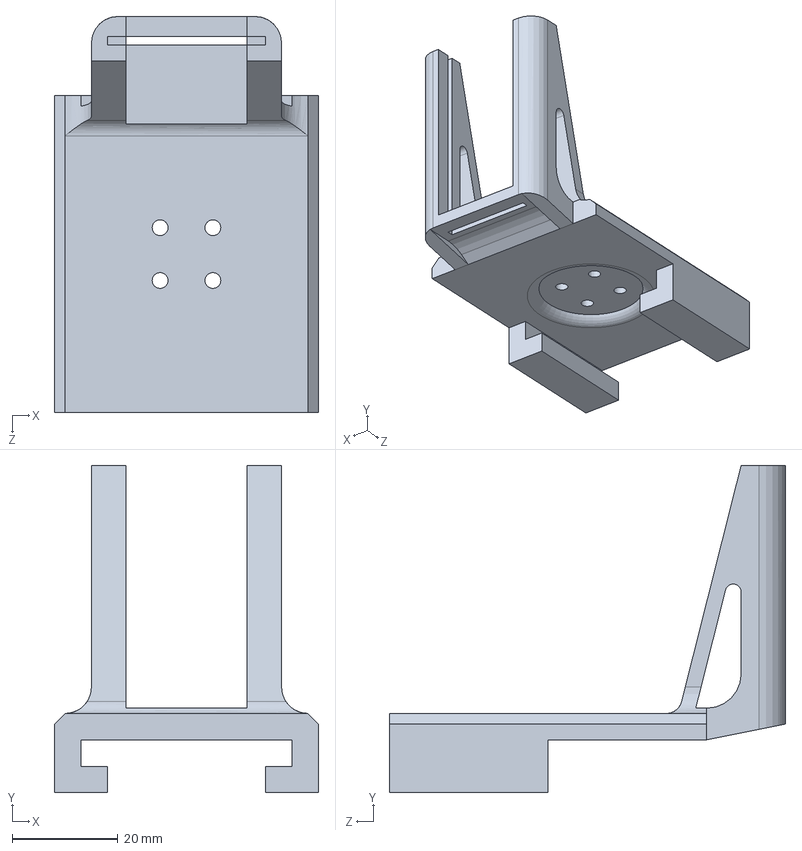
[picture p192: CAD file, 2026-10-19]
mechanical/source/fea_models/静力学/SolidWorks有限元分析/Joint A/关节底部.SLDPRT
50.0 x 62.0 x 75.0 mm
