Robusr/OnesArm/mechanical/source/pcb_3d_models/底部连接PCB.SLDPRT

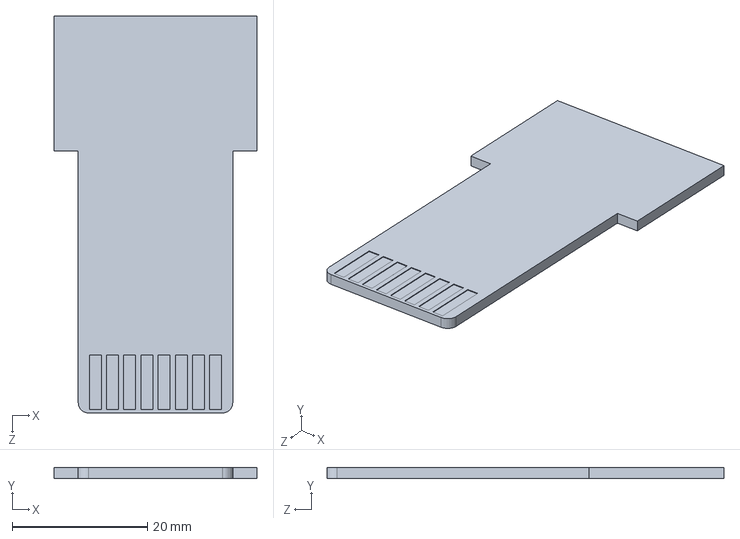
[picture p193: CAD file, 2026-10-19]
mechanical/source/pcb_3d_models/底部连接PCB.SLDPRT
30.0 x 1.60 x 58.7 mm
