Robusr/OnesArm/mechanical/source/test_rig/汉诺塔/底座.SLDPRT

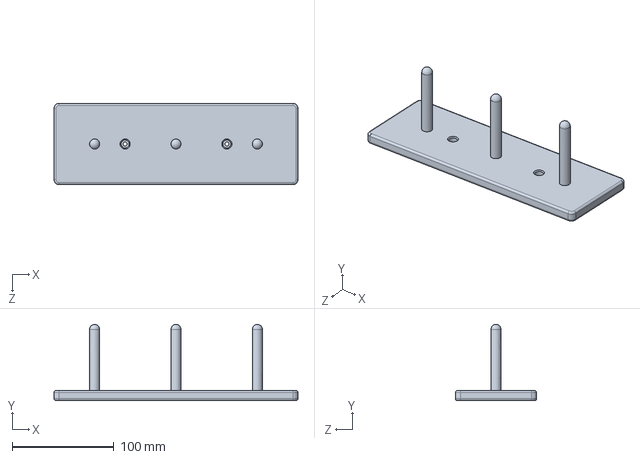
[picture p195: CAD file, 2026-10-19]
mechanical/source/test_rig/汉诺塔/底座.SLDPRT
240.0 x 75.0 x 80.0 mm
