Robusr/OnesArm/mechanical/source/test_rig/测试写字板.SLDPRT

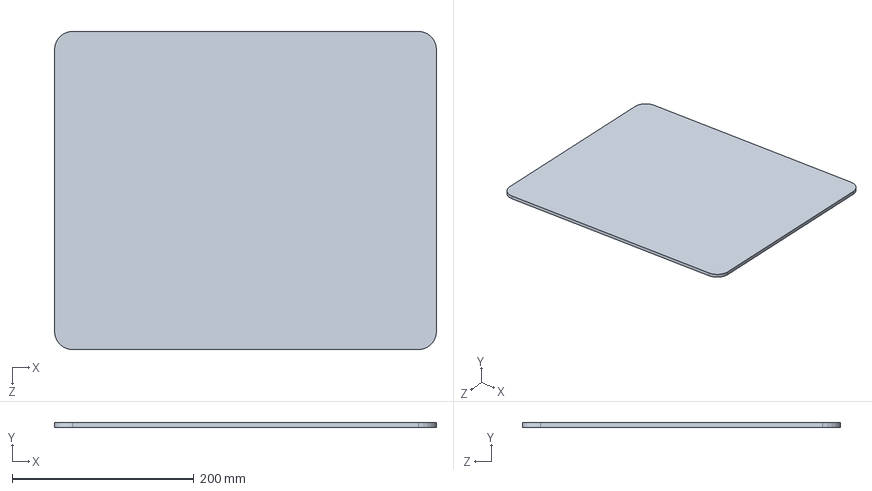
[picture p196: CAD file, 2026-10-19]
mechanical/source/test_rig/测试写字板.SLDPRT
420.0 x 5.00 x 350.0 mm
