Robusr/OnesArm/mechanical/output/3dp/step/print_batch_2/长连杆左.STEP

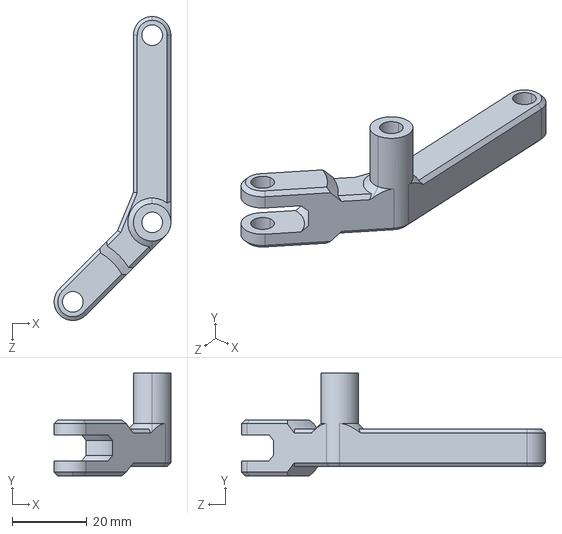
[picture p197: CAD file, 2026-10-19]
mechanical/output/3dp/step/print_batch_2/长连杆左.STEP
31.2 x 27.5 x 81.2 mm
