Robusr/OnesArm/mechanical/output/carbon_tube/底座碳管.STEP

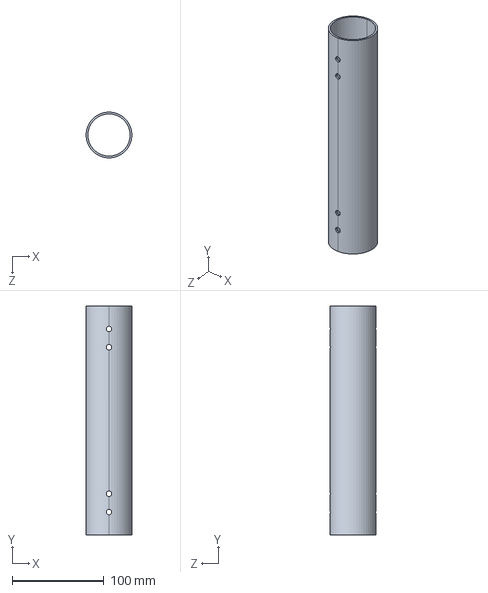
[picture p198: CAD file, 2026-10-19]
mechanical/output/carbon_tube/底座碳管.STEP
50.0 x 250.0 x 50.0 mm
