Robusr/OnesArm/mechanical/output/sheet_metal/连杆连接组件(攻丝底孔).STEP

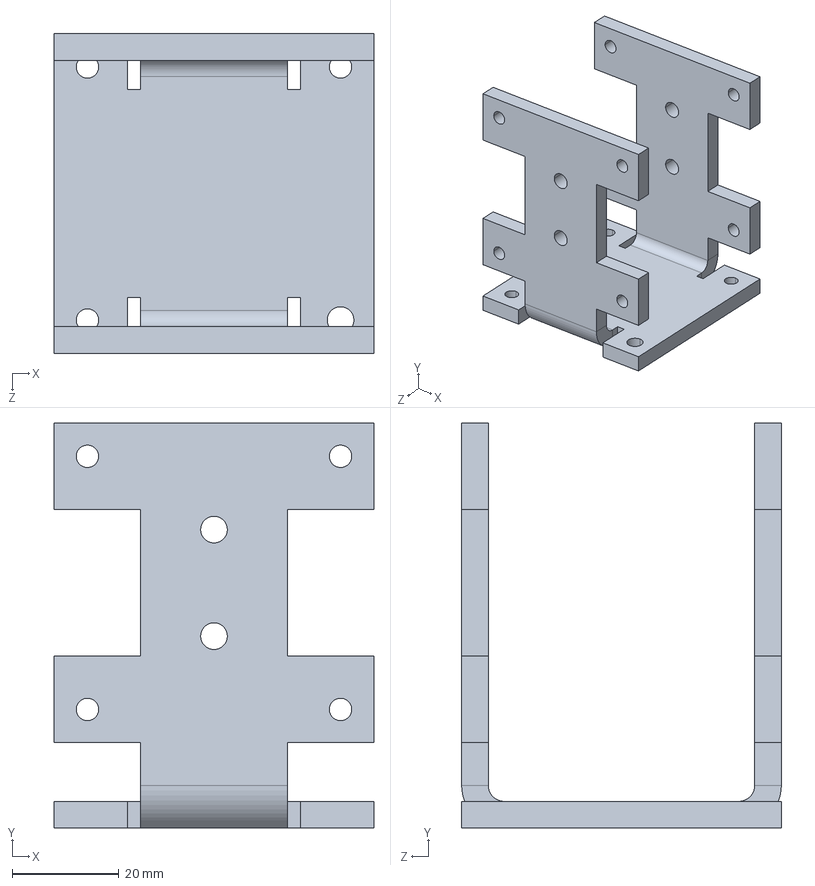
[picture p199: CAD file, 2026-10-19]
mechanical/output/sheet_metal/连杆连接组件(攻丝底孔).STEP
60.0 x 76.0 x 60.0 mm
