Robusr/OnesArm/mechanical/source/electronics_mechanics/控制器/闭环控制器/背面闭环控制器PCB垫片.SLDPRT

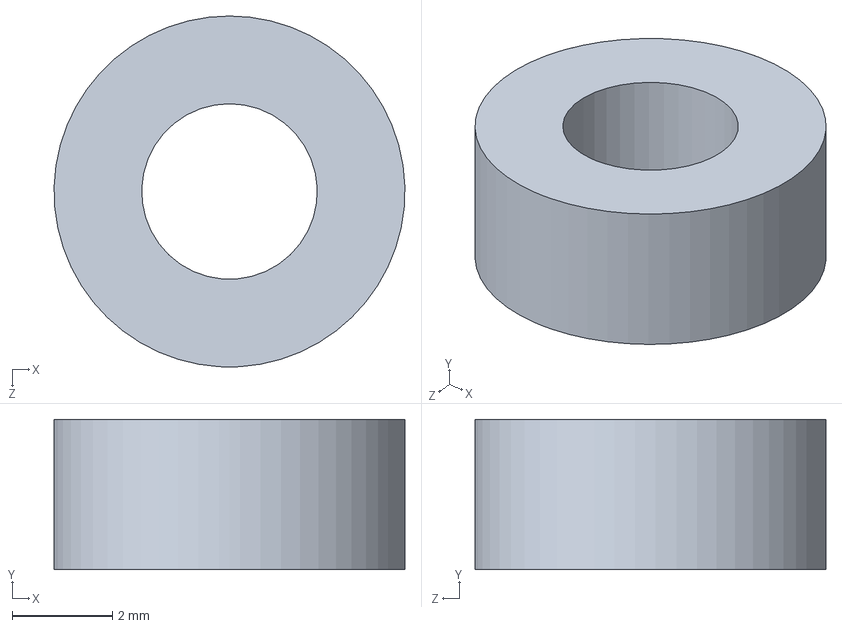
[picture p201: CAD file, 2026-10-19]
mechanical/source/electronics_mechanics/控制器/闭环控制器/背面闭环控制器PCB垫片.SLDPRT
7.00 x 3.00 x 7.00 mm
