Robusr/OnesArm/mechanical/source/electronics_mechanics/电源/电源支撑.SLDPRT

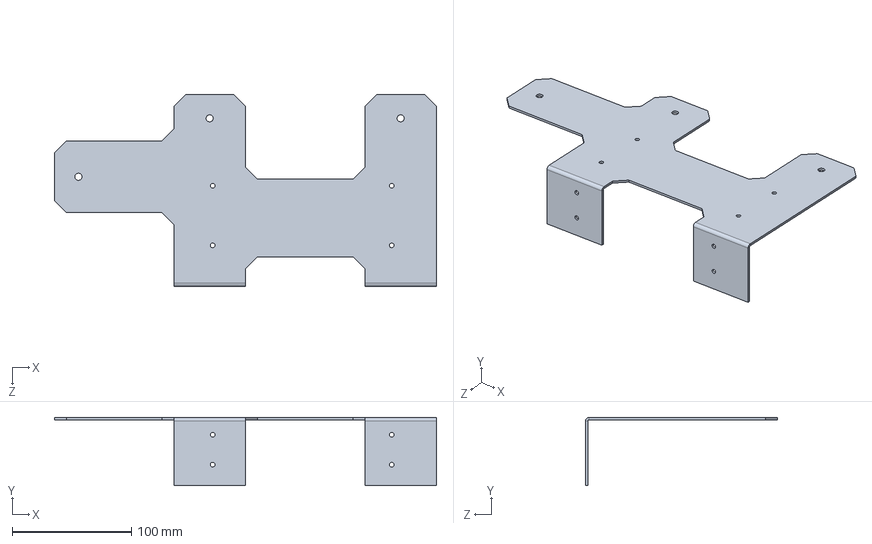
[picture p202: CAD file, 2026-10-19]
mechanical/source/electronics_mechanics/电源/电源支撑.SLDPRT
320.0 x 57.0 x 161.0 mm
