Robusr/OnesArm/mechanical/source/end_effectors/夹爪模块/丝杆.SLDPRT

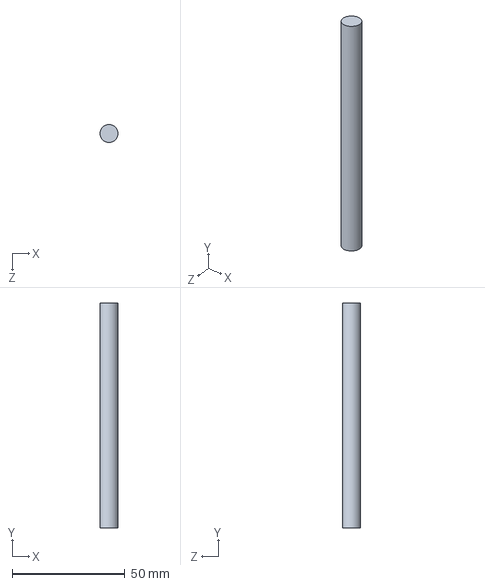
[picture p203: CAD file, 2026-10-19]
mechanical/source/end_effectors/夹爪模块/丝杆.SLDPRT
8.00 x 100.0 x 8.00 mm
