Robusr/OnesArm/mechanical/source/end_effectors/手写模块/手写笔.SLDPRT

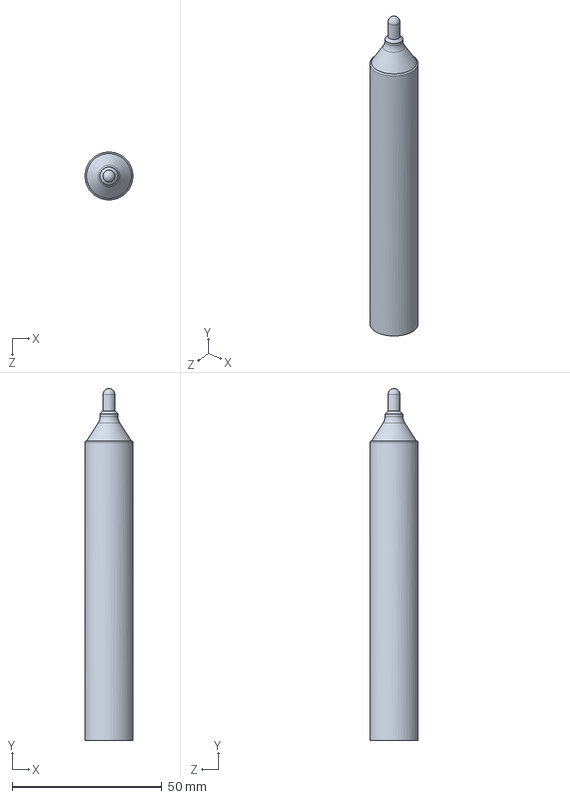
[picture p204: CAD file, 2026-10-19]
mechanical/source/end_effectors/手写模块/手写笔.SLDPRT
16.0 x 117.5 x 16.0 mm
