Robusr/OnesArm/mechanical/source/test_rig/汉诺塔/小圆盘 .SLDPRT

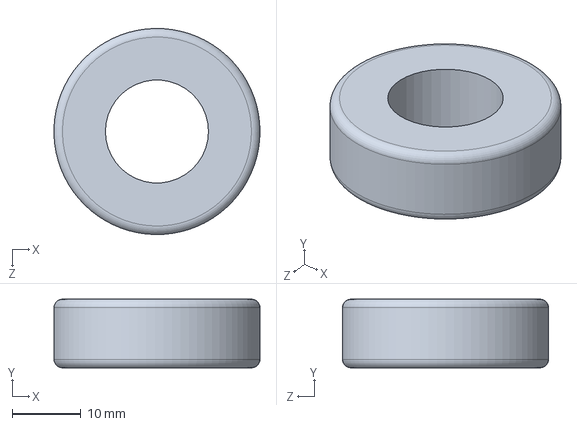
[picture p205: CAD file, 2026-10-19]
mechanical/source/test_rig/汉诺塔/小圆盘 .SLDPRT
30.0 x 10.0 x 30.0 mm
