Robusr/OnesArm/mechanical/output/3dp/step/current/气体传感器底座.STEP

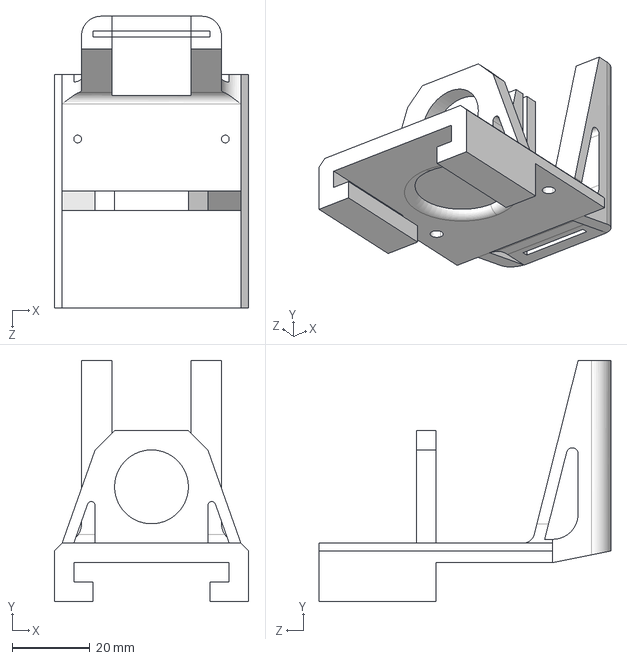
[picture p206: CAD file, 2026-10-19]
mechanical/output/3dp/step/current/气体传感器底座.STEP
50.0 x 62.0 x 75.0 mm
