Robusr/OnesArm/mechanical/output/3dp/step/print_batch_1/侧面闭环支撑.STEP

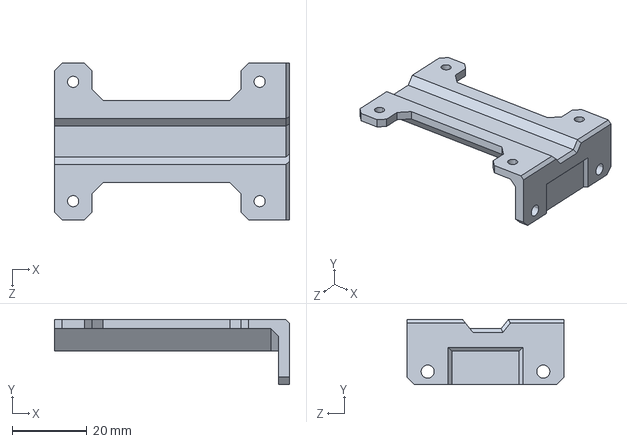
[picture p207: CAD file, 2026-10-19]
mechanical/output/3dp/step/print_batch_1/侧面闭环支撑.STEP
63.0 x 17.5 x 42.0 mm
