Robusr/OnesArm/mechanical/source/carbon_tube/短碳管.SLDPRT

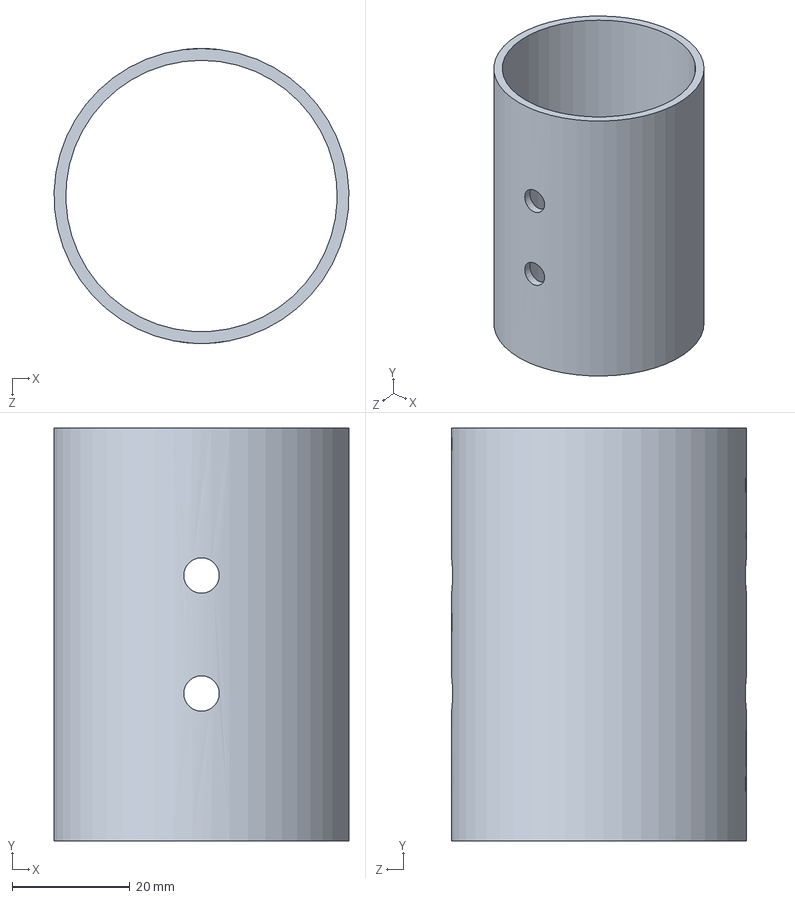
[picture p209: CAD file, 2026-10-19]
mechanical/source/carbon_tube/短碳管.SLDPRT
50.0 x 70.0 x 50.0 mm
