Robusr/OnesArm/mechanical/source/end_effectors/ultrasonic/超声波模块.SLDPRT

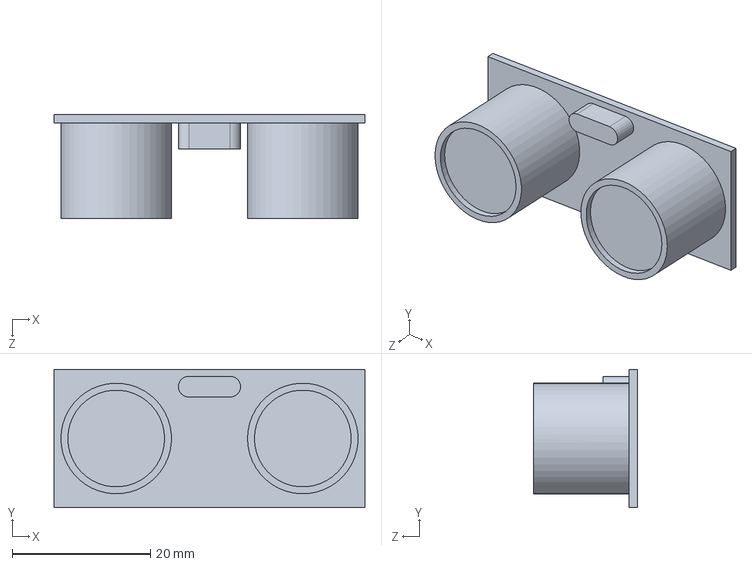
[picture p210: CAD file, 2026-10-19]
mechanical/source/end_effectors/ultrasonic/超声波模块.SLDPRT
45.0 x 20.0 x 15.0 mm
