Robusr/OnesArm/mechanical/source/end_effectors/夹爪模块/法兰连接.SLDPRT

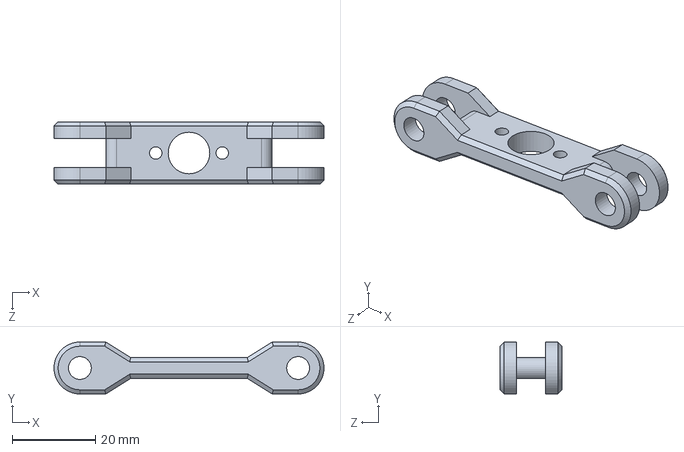
[picture p211: CAD file, 2026-10-19]
mechanical/source/end_effectors/夹爪模块/法兰连接.SLDPRT
65.0 x 12.5 x 15.0 mm
