Robusr/OnesArm/mechanical/source/end_effectors/手写模块/16mm夹具.SLDPRT

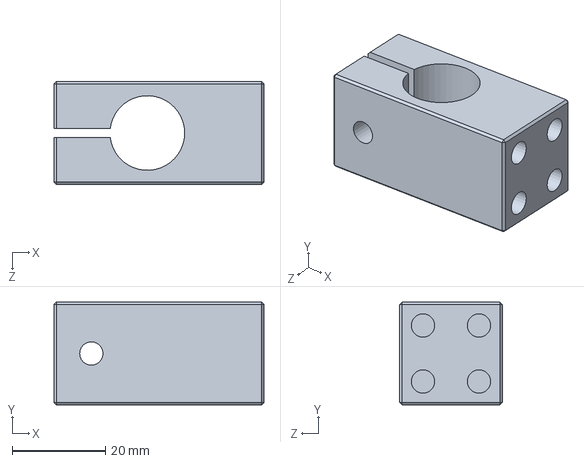
[picture p212: CAD file, 2026-10-19]
mechanical/source/end_effectors/手写模块/16mm夹具.SLDPRT
45.0 x 22.0 x 22.0 mm
