Robusr/OnesArm/mechanical/source/sheet_metal/底座支撑新(攻丝底孔).SLDPRT

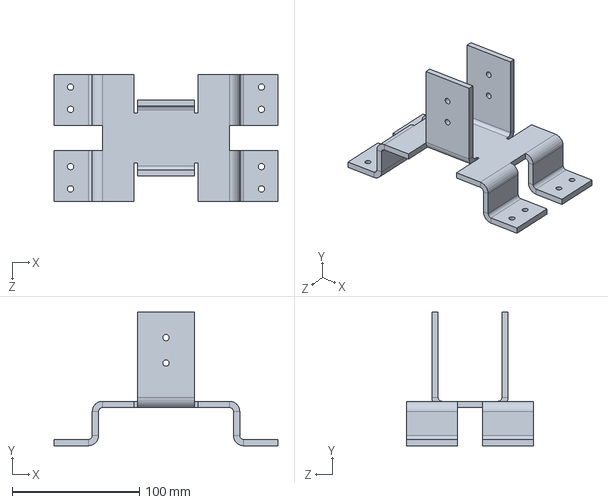
[picture p213: CAD file, 2026-10-19]
mechanical/source/sheet_metal/底座支撑新(攻丝底孔).SLDPRT
176.0 x 105.0 x 100.0 mm
