Robusr/OnesArm/mechanical/source/test_rig/汉诺塔/大圆盘.SLDPRT

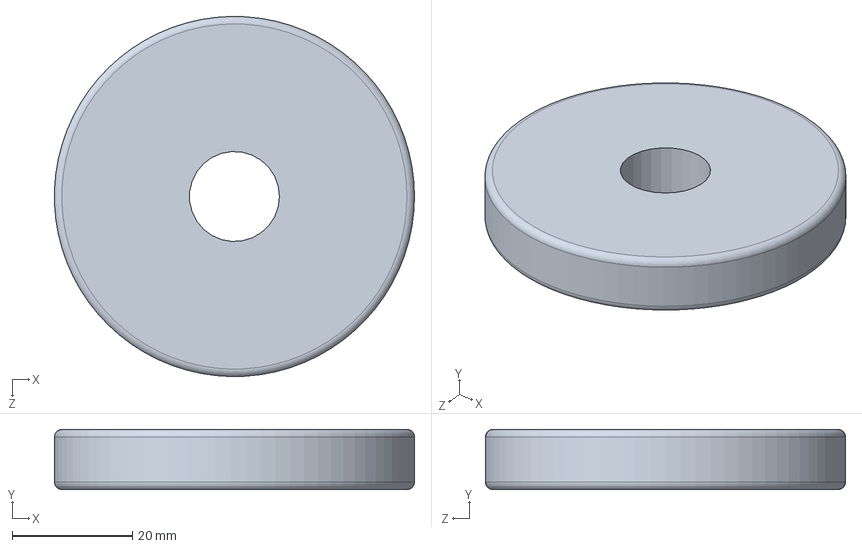
[picture p214: CAD file, 2026-10-19]
mechanical/source/test_rig/汉诺塔/大圆盘.SLDPRT
60.0 x 10.0 x 60.0 mm
