Robusr/OnesArm/mechanical/output/3dp/step/current/气体传感器保护罩.STEP

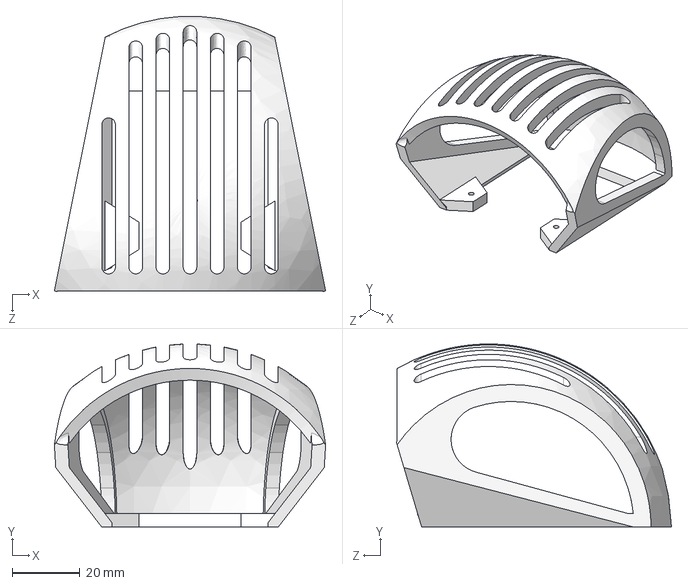
[picture p215: CAD file, 2026-10-19]
mechanical/output/3dp/step/current/气体传感器保护罩.STEP
80.0 x 54.0 x 81.1 mm
