Robusr/OnesArm/mechanical/output/3dp/step/print_batch_1/夹爪基座.STEP

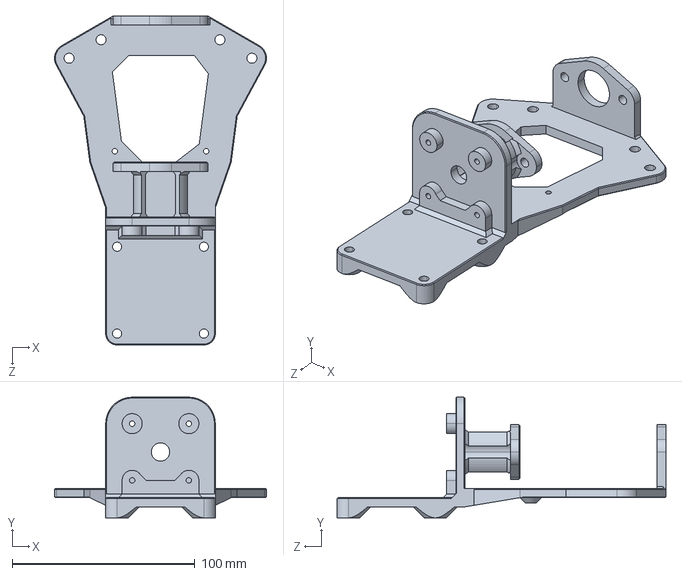
[picture p216: CAD file, 2026-10-19]
mechanical/output/3dp/step/print_batch_1/夹爪基座.STEP
116.0 x 66.0 x 180.0 mm
