Robusr/OnesArm/mechanical/source/assemblies/simplified_24/零件/A直关节底部简化.SLDPRT

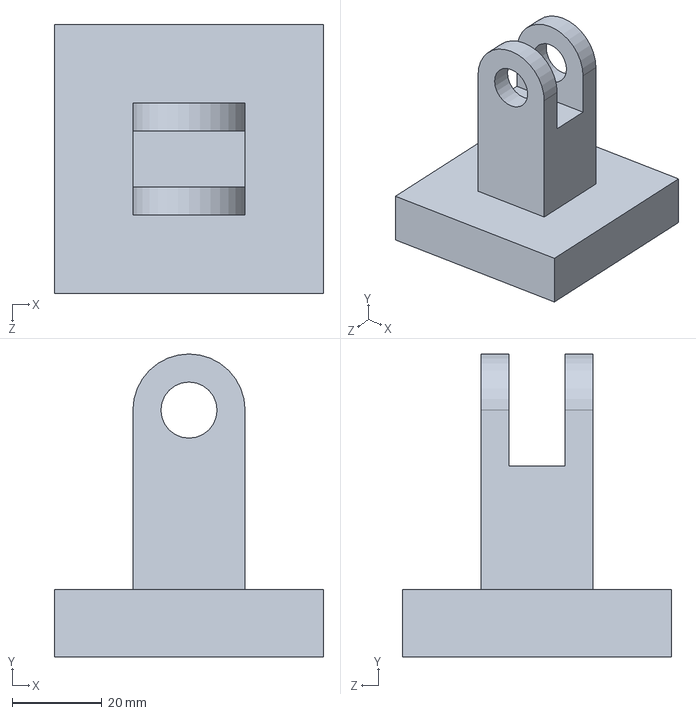
[picture p217: CAD file, 2026-10-19]
mechanical/source/assemblies/simplified_24/零件/A直关节底部简化.SLDPRT
60.0 x 67.5 x 60.0 mm
