Robusr/OnesArm/mechanical/source/end_effectors/手写模块/零空间运动测试组件.SLDPRT

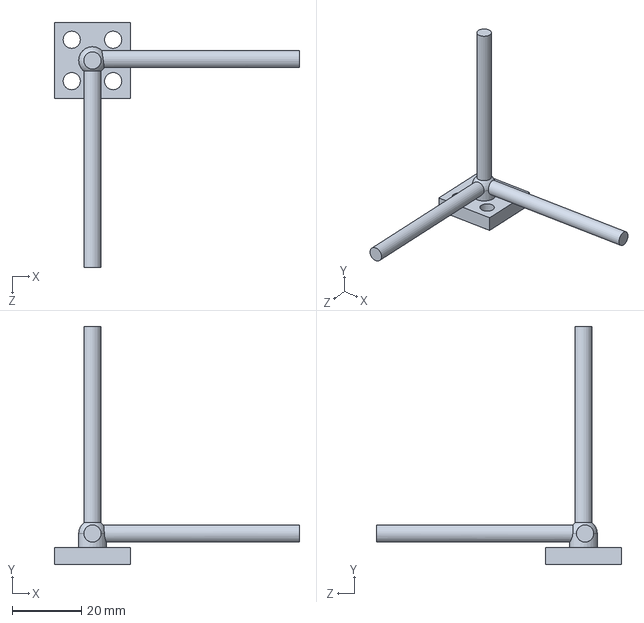
[picture p218: CAD file, 2026-10-19]
mechanical/source/end_effectors/手写模块/零空间运动测试组件.SLDPRT
71.0 x 69.0 x 71.0 mm
