Robusr/OnesArm/mechanical/source/sheet_metal/电机支撑(攻丝底孔).SLDPRT

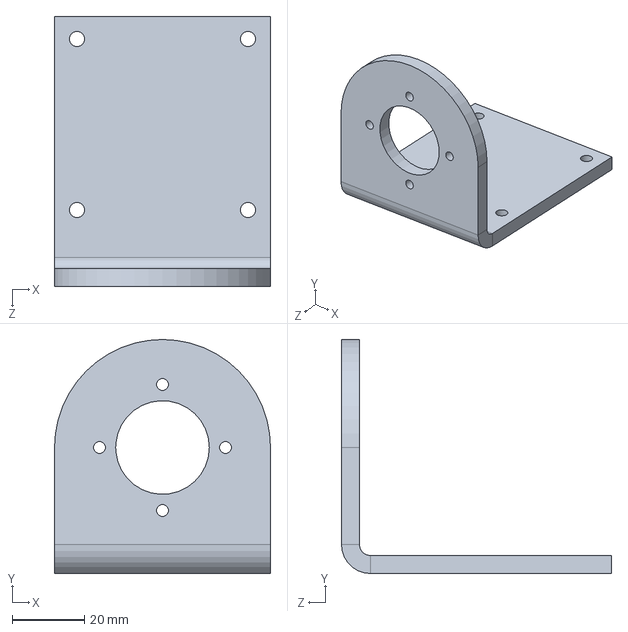
[picture p219: CAD file, 2026-10-19]
mechanical/source/sheet_metal/电机支撑(攻丝底孔).SLDPRT
60.0 x 65.0 x 75.0 mm
