Robusr/OnesArm/mechanical/output/3dp/step/print_batch_1/零空间运动测试组件.STEP

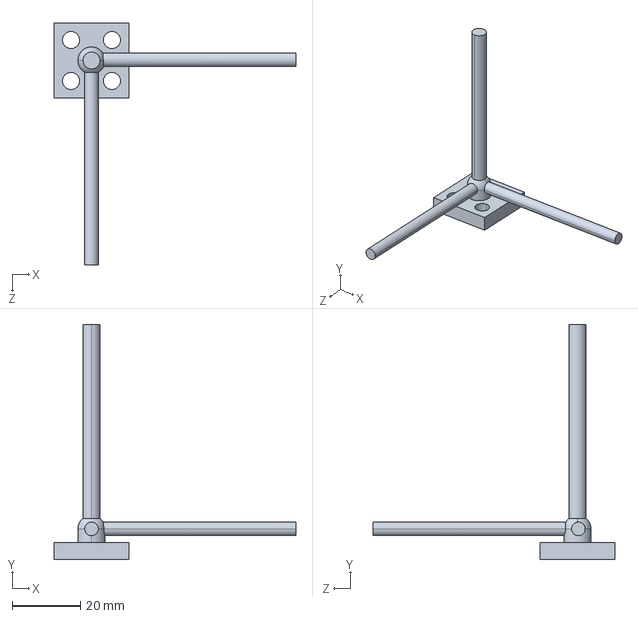
[picture p220: CAD file, 2026-10-19]
mechanical/output/3dp/step/print_batch_1/零空间运动测试组件.STEP
71.0 x 69.0 x 71.0 mm
