Robusr/OnesArm/mechanical/source/assemblies/simplified_24/零件/C45度关节顶部简化.SLDPRT

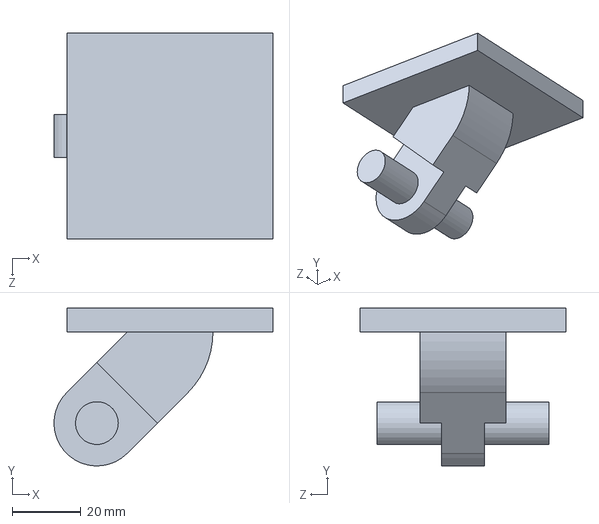
[picture p221: CAD file, 2026-10-19]
mechanical/source/assemblies/simplified_24/零件/C45度关节顶部简化.SLDPRT
63.8 x 46.0 x 60.0 mm
