Robusr/OnesArm/mechanical/source/assemblies/simplified_24/零件/夹具.SLDPRT

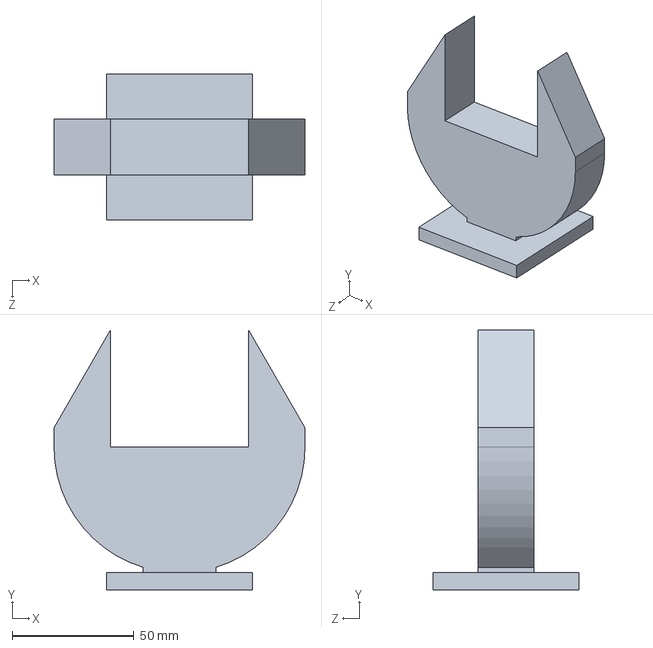
[picture p222: CAD file, 2026-10-19]
mechanical/source/assemblies/simplified_24/零件/夹具.SLDPRT
103.0 x 106.5 x 60.0 mm
