Robusr/OnesArm/mechanical/output/3dp/step/print_batch_1/小球.STEP

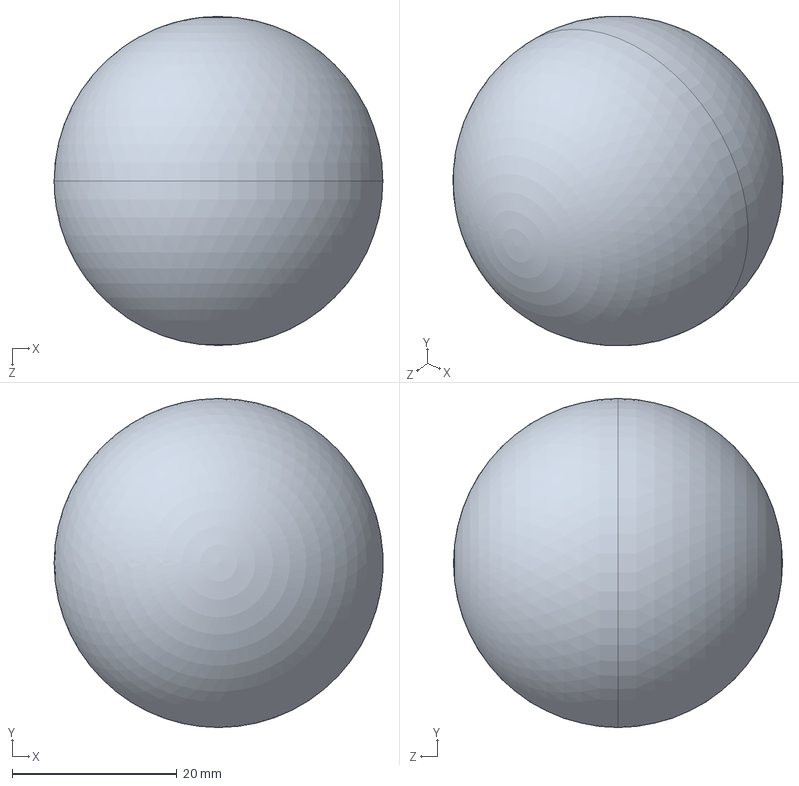
[picture p223: CAD file, 2026-10-19]
mechanical/output/3dp/step/print_batch_1/小球.STEP
40.0 x 40.0 x 40.0 mm
