Robusr/OnesArm/(list of files, cad)

Other CAD files:
mechanical/source/assemblies/simplified_24/装配/ACB/AyCyBx.SLDASM
mechanical/source/assemblies/simplified_24/装配/BAC/ByAxCy.SLDASM
mechanical/source/assemblies/simplified_24/装配/BCA/ByCyAx.SLDASM
mechanical/source/assemblies/simplified_24/装配/CAB/CyAxBx.SLDASM
mechanical/source/assemblies/simplified_24/装配/CBA/CyBxAy.SLDASM
mechanical/source/assemblies/simplified_24/装配/ABC/AyBxCy.SLDASM
mechanical/source/assemblies/simplified_24/装配/ACB/AyCxBy.SLDASM
mechanical/source/assemblies/simplified_24/装配/BAC/ByAyCy.SLDASM
mechanical/source/assemblies/simplified_24/装配/CAB/CyAyBy.SLDASM
mechanical/source/assemblies/simplified_24/装配/ABC/AyBxCx.SLDASM
mechanical/source/assemblies/simplified_24/装配/BAC/ByAyCx.SLDASM
mechanical/source/carbon_tube/XY连杆碳管.SLDPRT
mechanical/source/fea_models/静力学/SolidWorks有限元分析/Joint B/关节顶部.SLDPRT
mechanical/source/joints/current/关节顶部.SLDPRT
mechanical/output/3dp/step/current/关节底部.STEP
mechanical/output/3dp/step/print_batch_1/底座.STEP
mechanical/source/3dp/print_batch_1/长连杆右.SLDPRT
mechanical/source/carbon_tube/XX连杆碳管.SLDPRT
mechanical/source/sheet_metal/法兰连接板(攻丝底孔).SLDPRT
mechanical/output/sheet_metal/底座支撑(攻丝底孔).STEP
mechanical/source/3dp/print_batch_1/侧面闭环支撑.SLDPRT
mechanical/source/carbon_tube/底座碳管.SLDPRT
mechanical/source/analysis_models/kinematics/AyCxBy-D型机械臂图纸/A直关节顶部简化.SLDPRT
mechanical/output/3dp/step/print_batch_1/小圆盘 .STEP
mechanical/source/assemblies/simplified_24/零件/B直关节顶部简化 .SLDPRT
mechanical/output/3dp/step/print_batch_1/夹臂.STEP
docs/archive/related_concepts/electromagnetic_continuum_arm/图纸/万向节/NUT.SLDPRT
docs/archive/related_concepts/electromagnetic_continuum_arm/图纸/万向节/PIN.SLDPRT
docs/archive/related_concepts/electromagnetic_continuum_arm/图纸/万向节/SHAFT.SLDPRT
docs/archive/related_concepts/electromagnetic_continuum_arm/图纸/万向节/装配.SLDASM
docs/archive/related_concepts/electromagnetic_continuum_arm/图纸/底座.SLDPRT
docs/archive/related_concepts/electromagnetic_continuum_arm/图纸/支撑/分节装配.SLDASM
docs/archive/related_concepts/electromagnetic_continuum_arm/图纸/支撑/支撑.SLDPRT
docs/archive/related_concepts/electromagnetic_continuum_arm/图纸/电磁铁.SLDPRT
mechanical/output/3dp/stl_current/关节底部.STL
mechanical/output/3dp/stl_current/气体传感器保护罩.STL
mechanical/source/assemblies/legacy_2024/机械爪装配.SLDASM
mechanical/source/base/legacy_2024/底座.SLDASM
mechanical/source/drive/legacy_2024/减速器/FLE-42-20(无转子).SLDPRT
mechanical/source/drive/legacy_2024/电机/42BYGH33(无转子无螺纹孔).SLDPRT
mechanical/source/drive/legacy_2024/电机/42BYGH47(无转子).SLDPRT
mechanical/source/drive/legacy_2024/电机/42BYGH47(无转子无螺纹孔).SLDPRT
mechanical/source/drive/legacy_2024/电机模块无转子.SLDASM
mechanical/source/drive/legacy_2024/电机模块转子.SLDASM
mechanical/source/drive/legacy_2024/转子1(无螺纹孔).SLDPRT
mechanical/source/drive/legacy_2024/转子1.SLDPRT
mechanical/source/links/legacy_2024/XX连杆碳管.SLDPRT
mechanical/source/links/legacy_2024/XX长连杆.SLDASM
mechanical/source/links/legacy_2024/XY连杆碳管.SLDPRT
mechanical/source/links/legacy_2024/短碳管.SLDPRT
mechanical/source/links/legacy_2024/短连杆.SLDASM
mechanical/source/platform/legacy_2024/30型/3030型材-740mm-内部连接.SLDPRT
mechanical/source/platform/legacy_2024/30型/3030型材-740mm-边框.SLDPRT
mechanical/source/platform/legacy_2024/30型/3030型材-740mm.SLDPRT
mechanical/source/platform/legacy_2024/30型/3030型材-800mm.SLDPRT
mechanical/source/platform/legacy_2024/30型/3030型材-800mm边框.SLDPRT
mechanical/source/platform/legacy_2024/30型/测试平台.SLDASM
mechanical/source/platform/legacy_2024/40型/4040型材-上边框-720mm.SLDPRT
mechanical/source/platform/legacy_2024/40型/4040型材-支撑-720mm.SLDPRT
mechanical/source/platform/legacy_2024/40型/4040型材-竖边框-720mm.SLDPRT
mechanical/source/standard_parts/20系列型材/2040型材/4020_50mm.SLDPRT
mechanical/source/standard_parts/20系列型材/2040型材/上隆自动化_TNUT-20-M3.step
mechanical/source/standard_parts/20系列型材/T型螺母/TNUT-20-M3.STEP
mechanical/source/standard_parts/3030铝材/3030-M6-L16-T型螺栓.SLDPRT
mechanical/source/standard_parts/3030铝材/30槽内直角连接件.SLDPRT
mechanical/source/standard_parts/螺丝/内六角/SCA-M3-L12.SLDPRT
mechanical/source/standard_parts/螺丝/内六角/SCA-M3-L14.SLDPRT
mechanical/source/standard_parts/螺丝/内六角/SCA-M3-L16.SLDPRT
mechanical/source/standard_parts/螺丝/内六角/SCA-M3-L25.SLDPRT
mechanical/source/standard_parts/螺丝/内六角/SCA-M3-L8.SLDPRT
mechanical/source/standard_parts/螺丝/内六角/SCA-M4-L12.SLDPRT
mechanical/source/standard_parts/螺丝/内六角/SCA-M5-L16.SLDPRT
mechanical/source/standard_parts/螺丝/内六角/SCA-M5-L20.SLDPRT
mechanical/source/standard_parts/螺丝/内六角/SCA-M5-L35.SLDPRT
mechanical/source/standard_parts/螺丝/内六角/SCA-M6-L16.SLDPRT
mechanical/source/standard_parts/螺丝/内六角/SCA-M6-L20.SLDPRT
mechanical/source/standard_parts/螺丝/内六角/SCA-M6-L45.SLDPRT
mechanical/source/standard_parts/螺丝/内六角/SCE-M6-L10.SLDPRT
mechanical/source/standard_parts/螺丝/内六角/SCE-M6-L12.SLDPRT
mechanical/source/standard_parts/螺母/SLMNA-M5.SLDPRT
