Robusr/OnesArm/BOM/manufacturing/README.md

# Manufacturing checklists

These are the original 3D-print, sheet-metal, carbon-tube and platform checklists, copied from the source archive.

| Checklist | Exported image |
|---|---|
| [`3D打印/3D打印清单.md`](3D打印/3D打印清单.md) | [`3D打印/3D打印清单.png`](3D打印/3D打印清单.png) |
| [`3D打印补印/3D打印清单.md`](3D打印补印/3D打印清单.md) | [`3D打印补印/3D打印清单.png`](3D打印补印/3D打印清单.png) |
| [`钣金攻丝/清单.md`](钣金攻丝/清单.md) | [`钣金攻丝/清单.png`](钣金攻丝/清单.png), [`标准规格.png`](钣金攻丝/标准规格.png) |
| [`碳管定做/清单.md`](碳管定做/清单.md) | [`碳管定做/清单.png`](碳管定做/清单.png) |
| [`工作平台定位板/清单2.md`](工作平台定位板/清单2.md) | [`工作平台定位板/清单2.png`](工作平台定位板/清单2.png) |
| [`定做生产.md`](定做生产.md) | — |

## Link rewrite

The original Markdown files embedded images with absolute Typora paths such as `C:\Users\LEN\AppData\Roaming\Typora\typora-user-images\image-....png`. Those paths cannot resolve on another machine. The copies here replace each embedded image with the exported checklist PNG in the same folder. The text and quantities are unchanged.

`3d_print_notes.txt` is the original `备注.txt` from the 3D-print folder; it lists quantities for the structural parts.

No mass, tolerance or surface-finish data is present in these checklists. Add it before sending parts to a shop.
