Robusr/OnesArm/BOM/manufacturing/定做生产.md

# 定做生产清单

## 1、钣金

### 1、连杆俩接组件

#### XY长连杆*4

#### XX长连杆*4

#### 底座*2

#### （共计10个）

### 2、短连杆俩接组件

#### 短连杆*4

#### （共计4个）

### 3、电机支撑

#### 电机*6

#### （共计6个）

### 4、法兰连接板

#### 电机*6

#### （共计6个）

### 5、底座支撑

#### 底座*1

#### （共计1个）

## 2、碳管（50mm*46mm）

#### XX长*2

#### XY长*2

#### 短*2

#### 底座*1
