Robusr/OnesArm/BOM/manufacturing/3d_print_notes.txt

超声波模块底座*1
底座*1
关节底部*3
关节顶部*3
夹具底部*1
气体传感器保护罩*1
气体传感器底座*2
