Robusr/OnesArm/BOM/manufacturing/钣金攻丝/标准规格.png

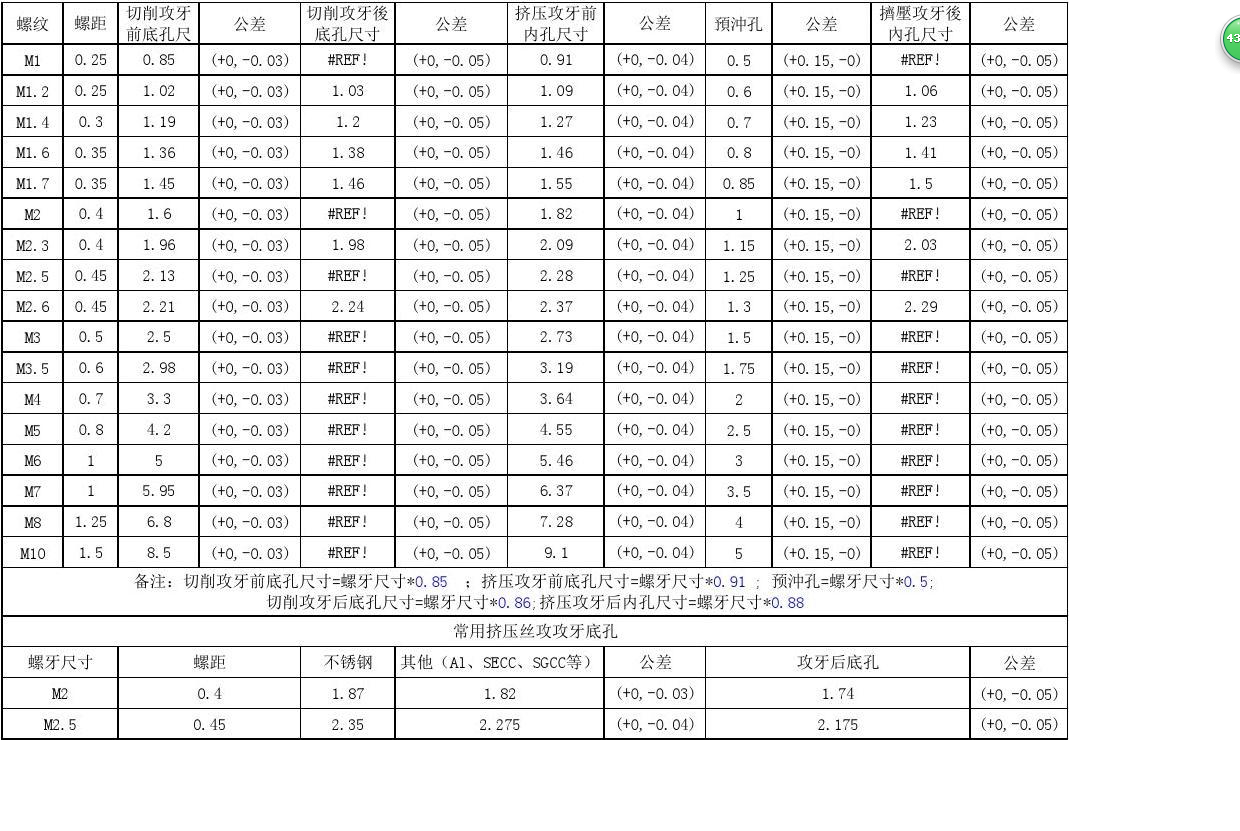
BOM/manufacturing/钣金攻丝/标准规格.png
