Robusr/OnesArm/media/photos/project/modular_assembly_diagram.jpg

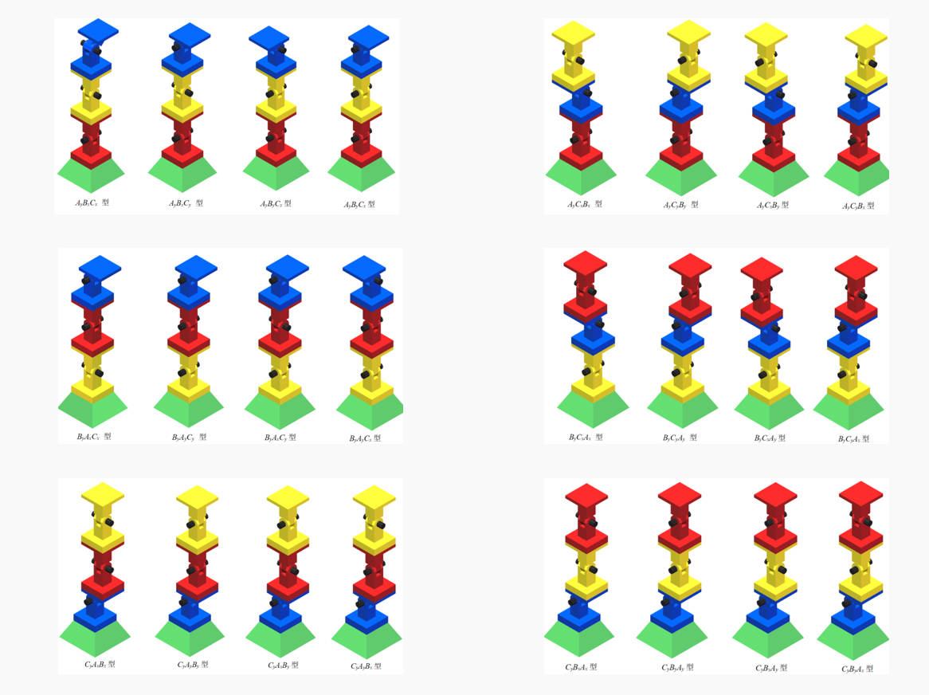
media/photos/project/modular_assembly_diagram.jpg
