Robusr/OnesArm/docs/verification_results.txt

# OnesArm verification results

Generated by `scripts/verify_theory/report_checks.py`. Lengths in metres.

## Forward kinematics

| Configuration | Standard DH position (m) | Report-order position (m) |
|---|---|---|
| q = [0, 0, 0, 0] | (0.354, -0.0, 0.07366) | (0.354, -0.07366, 0.0) |
| q = [0, 90, 0, 0] deg | (0.02134, 0.0, 0.449) | (0.0, -0.07366, 0.354) |
| q = [0, 45, -30, 30] deg | (0.283892, 0.110068, 0.241232) | (0.261257, 0.033549, 0.153777) |

## Report equation (3.7)

- Determinant of the printed rotation block at theta=90 deg: `0.000000`
- A rigid rotation must have determinant +1. The third column is printed as zeros.
- Correct third column under the report's own transform order: `[sin(theta2), -cos(theta2), 0]`.
- Orthonormality error of a correctly built report-order transform: `1.233e-32`

## Workspace bounding box (10,000 random samples, MATLAB joint limits)

| Convention | x min | x max | y min | y max | z min | z max | max reach |
|---|---:|---:|---:|---:|---:|---:|---:|
| Standard DH | -0.3533 | 0.3538 | -0.2405 | 0.2404 | -0.0759 | 0.4488 | 0.4496 |
| Report order | -0.3545 | 0.3519 | -0.3353 | 0.1464 | -0.1501 | 0.3533 | 0.3895 |

The report table gives joint limits `(0, 180)` for joints 3 and 4, not the `(-90, 90)` used above. A second run with the report limits is shown below.

| Convention | x min | x max | y min | y max | z min | z max | max reach |
|---|---:|---:|---:|---:|---:|---:|---:|
| Standard DH | -0.3507 | 0.3524 | -0.2405 | 0.0635 | -0.0779 | 0.4497 | 0.4500 |
| Report order | -0.3535 | 0.3530 | -0.3364 | -0.0281 | -0.1515 | 0.3538 | 0.3894 |

## Actuator check

- 10 N at the 0.354 m tip reach: `3.540 N.m`
- 15 kgf.cm servo stall torque: `1.471 N.m`
- Load / stall ratio: `2.41`
- The load is applied at each joint top face in the FEA, not necessarily at the tip; the report does not state the load location precisely enough to close this margin.

## Joint-limit unit check

- MATLAB `[-90 90]` without `*pi/180` is read as `180.0 rad` instead of `3.142 rad`; factor `57.3`.

## Assembly count

- `3! * 2^(3-1) = 24` for three interchangeable joint modules with the base-adjacent orientation fixed.
- Simplified assembly files found: `27`; three-letter combination files: `24`.
