Robusr/OnesArm/mechanical/source/links/legacy_2024/PerformanceLog.txt

Number of Contacts: 36
Number of contact data: 13304
