Robusr/OnesArm/firmware/stm32/KeyLED/Inc/main.h

#define LED1_Pin GPIO_PIN_6
#define LED1_GPIO_Port GPIOA
#define LED2_Pin GPIO_PIN_7
#define LED2_GPIO_Port GPIOA
#define KeyLeft_Pin GPIO_PIN_9
#define KeyLeft_GPIO_Port GPIOA
#define KeyRight_Pin GPIO_PIN_10
#define KeyRight_GPIO_Port GPIOA
