Robusr/OnesArm/firmware/stm32/彩色液晶屏驱动-基于2.00寸240x320分辨率/彩色液晶屏驱动-基于2.00寸240x320分辨率/Drivers/User/Inc/key.h

#ifndef __KEY_H
#define __KEY_H

#include "main.h"


#define	KEY_ON	 1		//按键按下
#define	KEY_OFF	 0		//按键放开

/*------------------------------------------ IO口配置宏 ----------------------------------*/


#define 	KEY_PIN           					GPIO_PIN_15        				 // KEY 引脚      
#define	KEY_PORT          					GPIOA                 			 // KEY GPIO端口     
#define 	__HAL_RCC_KEY_CLK_ENABLE         __HAL_RCC_GPIOA_CLK_ENABLE()	 // KEY GPIO端口时钟

/*------------------------------------------ 函数声明 ------------------------------------*/

void 		KEY_Init(void);	//按键IO口初始化函数
uint8_t	KEY_Scan(void);   //按键扫描

#endif //__KEY_H
