Robusr/OnesArm/(commit log)

2026-10-19 chore(repo): reorganize directory structure
    - move design, electronics, firmware, software and report assets into domain folders
    - add BOM summary, migration notes, licences and repository metadata
    - preserve the source archive unchanged
2026-10-19 docs(theory): add errata and verification scripts
    - document the DH convention mismatch, singular Eq. (3.7), joint-limit conflict and load case
    - add pure-Python checks for forward kinematics, workspace, torque and 24 combinations
    - record 10 passing tests, 1 skipped (no quaternion content)
2026-10-19 feat(media): add GIF demos and report figures
    - add four README-sized GIFs and poster frames
    - archive 91 report figure exports, key figures and manifests
    - keep original videos and PSD sources out of Git
2026-10-19 docs(readme): add English, Chinese and French READMEs
    - add structurally identical READMEs with shared figures, numbers and links
    - add long-form theory, mechanical, electronics and assembly documents in three languages
    - add glossary and documentation index
2026-10-19 docs(readme): present v2 as the current platform
    - lead with the v2 stepper/CAN platform and the v2 platform banner
    - retain the v1 servo/Pico build as a complete reference configuration
    - remove unfinished and uncertain wording from the README presentation
    - keep English, Chinese and French headings, tables and images aligned
2026-10-19 docs(readme): add v2 finite element and mathematical analysis
    - add the v2 XY-link URES displacement contour and the K u = f / beam relations
    - add the FCF per-module counts and the N_com formula from the presentation board
    - add the three-module 24-layout derivation, standard DH transforms, workspace set and effort index
    - renumber figures and keep English, Chinese and French READMEs aligned
2026-10-19 docs(readme): polish architecture and formula presentation
    - replace the ASCII stack with a clean SVG architecture diagram and legend
    - remove the board formula screenshots and render formulas with Unicode / code blocks
    - merge the v2 derivation into modular-combination, kinematics and assembly-selection sections
    - keep English, Chinese and French headings, tables, figures and images aligned
