Robusr/OnesArm/(notices)

Notices in the files:
firmware/stm32/KeyLED/Inc/main.h:
Copyright (c) 2024 STMicroelectronics.
All rights reserved.
This software is licensed under terms that can be found in the LICENSE file
README.md:
Docs and CAD: CC BY 4.0
